IlyaBOT/MonoPod/README.md

# MonoPod
DIY iPod-inspired portable music player powered by ESP32-S3, featuring a capacitive click wheel, custom firmware, high-quality audio (16 bit/ and wireless synchronization
