IlyaBOT/MonoPod/Hardware/TDA1308_HeadphoneAmp/README.md

# MonoPod TDA1308, R2: односторонняя плата

KiCad 10.0.6, 27.10.2026. Нативные файлы `TDA1308_HeadphoneAmp.kicad_pro`, `.kicad_sch` и `.kicad_pcb` являются редактируемыми оригиналами. Библиотеки и 3D-модели находятся в `libraries/`, переносить папку проекта целиком.

## Изменения относительно R1

| Параметр | R1 | R2 |
|---|---|---|
| Размер платы | 45 x 25 мм | 50 x 35 мм |
| Физические медные стороны | 2 | 1, только нижняя B.Cu |
| Переходные отверстия | 14 | 0 |
| Проволочные перемычки для разводки | 0 | 0 |
| Ширина дорожек | 0,25 мм | 0,60 мм |
| Устанавливаемые резисторы | 18, 0805 | 14, 1206 |
| Нулевые резисторы | 4 установлены + 2 места DNP | 0 |
| Керамические конденсаторы C3-C5 | SMD | Все выводные |
| Устанавливаемые электронные детали | 26 | 22 |

Медь, TDA1308, резисторы и селекторы JP находятся снизу. Все семь конденсаторов стоят сверху, их выводы паяются к нижней меди. Отверстия компонентов не являются переходными отверстиями. В R2 всего 21 отверстие для выводов/проводов: 14 x 0,8 мм и 7 x 1,15 мм. Для физической односторонней платы металлизация отверстий не требуется.

KiCad поддерживает формально чётное число медных слоёв, поэтому в редакторе сохранён служебный двухслойный стек. Верхний F.Cu электрически и физически не используется: нет дорожек, полигонов и активных колец площадок. Для выводных площадок в локальной библиотеке включено удаление всех неподключённых колец, включая крайние слои. Нативный контрольный экспорт F.Cu пуст: `validation/empty_front_copper_proof/`. Верхний медный Gerber отсутствует в производственном архиве. Это одна физическая сторона меди, а не скрытая двухслойная разводка. См. [документацию KiCad](https://docs.kicad.org/10.0/en/pcbnew/pcbnew.html).

Предыдущая R1 сохранена в `revisions/` основной рабочей папки на I:. Для изготовления новой версии использовать только архив R2 из текущей папки.

## Электрическая схема и сокращение резисторов

Основа сохранена: [NXP TDA1308, Rev.5, Fig.4, стр.6](https://www.nxp.com/docs/en/data-sheet/TDA1308.pdf). VREF = VDD/2, два инвертирующих каскада с Rin=Rf=3,9 кОм, обязательные выходные разделительные электролиты, развязка питания и общий GND. Электрические номиналы R1-R14 и C1-C7 относительно R1 не изменены.

Удалены R15-R20: четыре устанавливаемых нулевых резистора и два резервных места. Вместо них четыре трёхконтактных паяных селектора JP1-JP4. Резисторы делителя VREF, входных делителей и обратной связи нужны для сохранения рабочей схемы. R11/R12 = 2,2 Ом оставлены для выходной развязки с неизвестным кабелем; R13/R14 = 100 кОм сохраняют определённый потенциал отключённого выхода. Их удаление изменило бы поведение и диагностику платы, поэтому дальнейшее сокращение не выполнено.

### Режим ATT/DIRECT

Все JP изготовлены РАЗОМКНУТЫМИ. Перед включением необходимо запаять выбранные пары. Это четыре припойные перемычки выбора режима, они не используются для пересечения дорожек. Отдельных проводов и нулевых резисторов для разводки нет.

| Канал | Селекторы | ATTENUATED, штатно для PCM5102A | DIRECT для слабого источника |
|---|---|---|---|
| Левый | JP1 и JP2 | На обоих соединить 1-2 | На обоих убрать 1-2 и соединить 2-3 |
| Правый | JP3 и JP4 | На обоих соединить 1-2 | На обоих убрать 1-2 и соединить 2-3 |

Вывод 1 отмечен треугольником на нижней шелкографии; сверяться с нижним assembly-видом. Нельзя соединять все три площадки и нельзя оставлять два селектора одного канала в разных режимах. Переключать только при снятом питании. В DIRECT делитель отключён от источника и от выбранного входа с обоих концов, паразитной нагрузки 3,3 кОм нет. Контроль DC-графа обоих режимов выполнен в `scripts/document.py`.

В ATT реальное ослабление с нагрузкой входа 3,9 кОм составляет около -16,4 дБ, а не -12 дБ изолированного делителя. С выходным 2,2 Ом на 32 Ом получается около -17 дБ и 0,298 В RMS при 2,1 В RMS от PCM5102A, приблизительно 2,8 мВт/канал. Это расчёт линейной схемы, не измеренная мощность. DIRECT при полной амплитуде PCM5102A вызовет клиппинг: начинать с малой цифровой громкости.

## Конденсаторы: все выводные, все сверху

| Ref | Номинал | Корпус и шаг | Полярность |
|---|---|---|---|
| C1 | 22 мкФ / >=10 В | Электролит, D<=5 мм, P=2 мм | + к VREF, - к GND |
| C2 | 100 мкФ / >=10 В | Электролит, D<=6,3 мм, P=2,5 мм | + к VDD, - к GND |
| C3 | 100 нФ / >=25 В X7R | Выводной керамический, D<=5 мм, толщина <=2,5 мм, P=2,5 мм | Неполярный |
| C4/C5 | 4,7 мкФ / >=25 В X7R | Выводной многослойный керамический, тело <=7 x 4,5 мм, P=5 мм | Неполярные |
| C6/C7 | 220 мкФ / >=10 В | Электролит, D<=8 мм, P=3,5 мм | + к усилителю через R11/R12, - к наушникам |

Керамические C4/C5 должны иметь эффективную ёмкость >=2,2 мкФ при постоянном смещении до 2,5 В. Обычные диски 100 нФ вместо них не подходят: это сильно поднимет нижнюю границу полосы. Выбирать X7R, не Y5V/Z5U. Подходящий класс деталей существует среди выводных MLCC, например семейство [KEMET Goldmax X7R](https://content.kemet.com/datasheets/KEM_C1050_GOLDMAX_X7R.pdf); перед покупкой проверить конкретный корпус, шаг и DC bias. Шаг 5,08 мм можно аккуратно привести к 5,00 мм. 3D-модель показывает габарит посадочного места, а не гарантированный цвет/форму покупного конденсатора.

Большие выходные ёмкости остаются электролитическими: замена на малые керамические диски нарушила бы НЧ-характеристику. В C6/C7 можно установить 470 мкФ / >=10 В в том же габарите или временно имеющиеся 100 мкФ / 25 В. Срез на 32 Ом без учёта 2,2 Ом: 49,7 / 22,6 / 10,6 Гц для 100 / 220 / 470 мкФ. С 2,2 Ом: 46,5 / 21,2 / 9,9 Гц. На 20 Гц у 220 мкФ остаётся заметный спад; 470 мкФ лучше сохраняет бас.

Ваши выпаянные 100 мкФ / 25 В подходят для C2 при D<=6,3 мм и для временной замены C6/C7 при D<=8 мм. Если шаг 2,5 мм, выводы можно осторожно сформовать до 3,5 мм, не изгибая их у пробки. Их высота, ESR, утечка и исправность неизвестны. Для штатного варианта дополнительно нужны 22 мкФ x1, 100 нФ выводной X7R x1, 4,7 мкФ выводной X7R x2 и 220/470 мкФ x2. C2 можно взять из имеющегося набора после проверки.

## Подключение и монтаж

Штатное питание 3,3 В; 5 В только после полного стендового испытания. Не подавать 5 В на ESP32. Плата не содержит преобразователей, стабилизаторов или защиты от переполюсовки. Общая земля объединяет PCM5102A, питание и наушники. Разъём 3,5 мм вынесен на провода.

| Площадка | Маркировка | Подключение |
|---|---|---|
| J1 | VCC | Питание 3,3 В |
| J2 | GND | Земля источника питания/PCM5102A |
| J3 | LIN | Левый сигнал PCM5102A |
| J4 | RIN | Правый сигнал PCM5102A |
| J5 | GND | Общий контакт наушников |
| J6 | LOUT | Левый наушник, после C6 |
| J7 | ROUT | Правый наушник, после C7 |

Маркировка проводов находится на нижней стороне. При перевороте платы левое/правое положение на изображении меняется: подключать по надписям, не по памяти о R1. Площадки проводов 2,15 мм, отверстия 1,15 мм подходят для AWG26-30. Механическую разгрузку проводов выполнить в корпусе; монтажных отверстий нет.

Сначала паять SMD снизу: U1, резисторы и выбранные пары JP. Затем устанавливать конденсаторы сверху и паять их ножки снизу, подрезая выводы. C3 располагать как можно ближе к плате: длинные ножки ухудшают высокочастотную развязку. Точки GND имеют сплошное соединение с заливкой, поэтому при ручной пайке понадобится хороший теплоотвод от жала и флюс; не компенсировать недостаток мощности длительным перегревом деталей.

U1 остаётся SOIC-8 3,9 x 4,9 мм с шагом 1,27 мм. На нижнем виде pin 1 находится сверху справа от корпуса; ориентироваться по точке корпуса и метке шелкографии. TSSOP-8 не подходит. Все полярные конденсаторы имеют + на квадратной площадке, к усилителю/питанию; закрашенная половина силуэта обозначает отрицательную сторону. Проверить ориентацию по assembly-изображениям.

Снизу к высоте платы добавляются SMD-компоненты: место и изоляцию от металлического корпуса нужно проверить. Высота старых электролитов и совместимость корпуса MonoPod не измерены. Рисунки 3D библиотечные; они не подтверждают реальные габариты вашего набора.

## Тестовые площадки

TP1 VDD; TP2 GND; TP3 VREF; TP4 INA; TP5 INB; TP6 OUTA_RAW; TP7 OUTB_RAW; TP8 HP_L; TP9 HP_R. Все площадки находятся снизу и не требуют отдельных компонентов. INA/INB находятся после селекторов, до входных конденсаторов. RAW имеют постоянное смещение около VREF и не предназначены для наушников.

Схема сохраняет обратную связь до разделительных конденсаторов. Не подключать большие керамические конденсаторы от RAW к GND. В даташите CL ограничена 200 пФ при паспортных условиях. 2,2 Ом не гарантируют устойчивость с любым кабелем: проверить осциллографом на 330/33 Ом и с реальным кабелем. Noise gain около 1,61 в ATT и 2 в DIRECT; электрические значения относительно R1 не изменены.

## Первый запуск: без PCM5102A и без наушников

1. При снятом питании проверить пайку, ориентацию U1 и полярности четырёх электролитов. Проверить отсутствие устойчивого короткого VDD-GND мультиметром; из-за зарядки C2 показание сопротивления может меняться. Проверить четыре селектора JP: штатно на каждом запаять 1-2; ни один селектор не должен соединять все три площадки.
2. Подать стабилизированные 3,3 В от лабораторного источника с начальным ограничением 20 мА. Не подавать аудиосигнал. После зарядки конденсаторов источник должен выйти из ограничения. Нормальный ток покоя ожидается единицы мА (NXP: 3 мА типично, 5 мА максимум при 5 В, плюс ток делителя). Устойчивый ток более 10 мА без сигнала или нагрев требуют выключения и поиска причины.
3. Измерить TP1 VDD и TP3 VREF относительно TP2 GND. VREF должен быть около VDD/2: примерно 1,65 В при 3,3 В. Для начальной диагностики ориентир 1,60-1,70 В при точных 3,3 В; это практический ориентир, не паспортный допуск всей сборки.
4. Измерить постоянное напряжение на выводах 1 и 7 / TP6 и TP7. Оба должны быть около VREF, а не около нуля. Заметная разница между каналами либо выход у шины питания требует проверки U1 и обратной связи. Не подключать наушники к TP6/TP7.
5. Проверить DC после выходных конденсаторов, TP8/TP9. Без нагрузки ждать около 120 с для 220 мкФ, 240 с для 470 мкФ, 60 с для 100 мкФ: постоянная времени с 100 кОм составляет 22/47/10 с. В начале возможен зарядный импульс. После установления ориентир <10 мВ; если напряжение сохраняется, проверить полярность/утечку конденсатора и пайку. Это критерий диагностики, не гарантия для неизвестных электролитов.
6. Подать тестовый синус 1 кГц, например 20 мВ RMS, через LIN/RIN с общей землёй. В ATT ожидается около 3 мВ RMS на наушниковом выходе при резистивной нагрузке, поэтому для оценки формы можно постепенно увеличить до 100-200 мВ RMS на входе. Наблюдать оба RAW-выхода и выходы после C6/C7 осциллографом. Земля щупа только GND. Для проверки ВЧ использовать короткую землю щупа и пробник x10.
7. Установить отдельные эквиваленты нагрузки 330 Ом между LOUT-GND и ROUT-GND; проверить форму, DC и просадку питания. Нагрузки подключать при снятом питании, затем повторять измерения после включения.
8. Заменить эквиваленты на 33 Ом, >=0,25 Вт каждый. Для испытаний с сигналом можно увеличить токовый лимит до 50-100 мА, наблюдая потребление. Начинать с малой амплитуды. Не искать предел громкости в наушниках.
9. Проверить отсутствие клиппинга, ВЧ-самовозбуждения, перегрева и заметного падения VDD; повторить с реальным кабелем и с обоими каналами. Логический анализатор не заменяет осциллограф для DC, аналоговой формы и искажений; учитывать допустимые напряжения его входов.
10. Только после успешных проверок подключить наушники при минимальной громкости и установившемся питании. Затем подключить PCM5102A, начиная с минимального цифрового уровня. При выключениях/включениях учитывать зарядные импульсы. Испытание на 5 В проводить сначала без наушников и повторять весь цикл.

Выпаянная U1 может быть повреждена, перемаркирована или перегрета. Правильная схема и чистый DRC не исключают сохранение прежних симптомов перегруза из-за самой микросхемы. Измеренное улучшение на активных колонках не доказывает её работоспособность на 32 Ом.

## Проверки и файлы изготовления

Нативные ERC и DRC выполнены со всеми уровнями замечаний, с проверкой соответствия PCB схеме: 0 нарушений, 0 неразведённых соединений и 0 расхождений со схемой. Исключения DRC не добавлялись. Карта всех выводов и нетлист сверены, полярности и конфигурации селекторов проверены. В частности, на F.Cu нет активных площадок, дорожек или заливки; контрольный Gerber F.Cu содержит ноль апертур/рисующих команд. Все 78 центров площадок проверены на открытие в фактическом Gerber нижней маски; результат PASS в `soldermask_pad_openings.json`. Все дорожки B.Cu имеют ширину 0,6 мм, правило зазора 0,25 мм; минимальная толщина перемычек заливки земли 0,4 мм.

`manufacturing.zip` содержит только одну медь B.Cu, нижнюю маску, шелкографию двух сторон, контур, единый Excellon с 21 отверстием и `FABRICATION.txt`. Для физического заказа: ОДНА сторона меди снизу, FR4 1,6 мм, медь 35 мкм, все отверстия БЕЗ металлизации. Финиш HASL или иной стандартный паяемый. Не создавать верхнюю медь, не зеркалить и не масштабировать Gerber. Если сервис предлагает только двухслойный заказ, выбрать изготовителя с поддержкой односторонних плат или явно согласовать пустую верхнюю сторону; заказ автоматически не выполнялся.

Использован обычный Gerber RS-274X без X2-атрибутов. Комментарии X2 со служебной двухслойной нумерацией удалены; все графические команды побайтно по строкам сохранены, контроль в `gerber_metadata_normalization.json`. Внутренний двухслойный Gerber job KiCad намеренно не включён. Excellon имеет минимальный заголовок без атрибута металлизации; физическое отсутствие металлизации явно задано в FABRICATION.txt. Нативный отчёт KiCad называет выводные отверстия PTH по электрическому типу площадок — это служебная классификация CAD, а не указание металлизировать эту одностороннюю плату.

`BOM.csv` содержит 14 резисторов, 7 конденсаторов и одну U1 — всего 22 устанавливаемые детали. JP/J/TP указаны отдельно как площадки без покупных компонентов. Координаты и фактические повороты: `assembly_coordinates.csv`. В `renders/` находятся виды сверху/снизу, assembly и медь. `docs/schematic.pdf` — обзор, `.kicad_sch` — редактируемая схема. `validation/` содержит результаты, расчёты, карту цепей, доказательство пустого F.Cu и SHA-256.

Изготовленный физический образец не испытан. Чистые ERC/DRC не подтверждают исправность выпаянной TDA1308, утечку старых электролитов, реальные THD/шум или устойчивость с кабелем. Перенос библиотеки и native-паритет проверяются отдельно. Для редактирования открыть основной `.kicad_pro`. Скрипты `design.py`/`build_pcb.py` перезаписывают CAD; обычные правки вносить в KiCad. Повторные проверки: bundled Python KiCad + `scripts/validate.py`, экспорт — `scripts/export.py`.
