IlyaBOT/MonoPod/Hardware/MonoPod_Enclosure_v04_USB_Flush_Acrylic_2026-11-02/stl/README_RU.md

# MonoPod v0.7 — рамка дисплея с нахлёстом под клей

Стойки передней панели и рамки укорочены по высоте на 1 мм относительно пробника 52×30,4. Они входят друг в друга, поэтому плата TFT в сборе приблизилась к лицу на 1 мм. Шаг креплений 52×30,4 мм. Винты TFT — четыре М2.5×6. Расчётное зацепление резьбы 2,6 мм, запас под концом винта 0,25 мм.

На рамке сплошной бортик толщиной 1 мм. Он заходит под панель на 2 мм по контуру, включая участки вокруг креплений. В панели есть ответная ступенька с зазором 0,15 мм под тонкий слой клея. Клей наносится на обращённую к панели плоскую сторону этого бортика.

Акрил 45×38×1 мм с тем же контуром. Его посадка сдвинута вверх на 1,2 мм, чтобы оставить место под бортик рядом с каркасом колеса. Световой проём 38×31 мм расположен на 3 мм левее центра креплений. Справа рамка прикрывает зону шлейфа. Номинальный зазор между рамкой и корпусом TFT составляет 0,3 мм.

## Печать и примерка

1. Напечатайте `Probnik.stl` и `Ramka.stl` в масштабе 100%, в миллиметрах. Оба STL уже ориентированы плоской стороной на стол. Печатайте рамку из непрозрачного пластика.
2. Вставьте рамку с тыльной стороны пробника, приложите TFT и проверьте попадание всех четырёх винтов. Проверьте, что плата лежит на опорах без перекоса, стекло свободно, бортик перекрывает стык, а на включённом экране видны края изображения.
3. После сухой примерки печатайте `Front_Panel.stl` и приклейте рамку к панели по бортику. Клеевой шов проходит вдоль края, с отступом от винтовых отверстий. Монтаж TFT и установка панели выполняются после отверждения клея.

## Исходники

В полном архиве есть STL, STEP, сборка экрана и параметры CadQuery. Из корня архива с Python 3.13:

```powershell
python -m pip install -r source/requirements.txt
python source/build_enclosure.py --output build
```

В CAD проверены центры винтов, опорные площадки, непрерывность клеевой полосы, установка рамки сзади и зазоры до TFT и Click Wheel. Посадку напечатанных деталей проверяют пробником.
