IlyaBOT/MonoPod/Hardware/MonoPod_Enclosure_v04_USB_Flush_Acrylic_2026-11-02/reference/clickwheel/README_RU.md

# MonoPod Click Wheel v0.3 — механика под актуальную PCB

Комплект адаптирован к круглой плате MonoPod Ø44 мм из проекта KiCad: четыре боковые кнопки находятся на радиусе 16,5 мм, Select — в центре, крепёжные отверстия платы — в точках (±13; ±13). Идентичность ваших TS-1187A кнопкам проекта принята по вашему подтверждению. Исходная плата и прошивка не изменены.

Накладка закреплена в четырёх диагональных точках. При нажатии прогибается её тонкое лицо между закреплениями. У каждой стороны есть отдельный толкатель с двумя ограничительными ножками на общей перемычке. Select — отдельная деталь, удерживаемая скрытым буртиком за основное колесо; скрытый ключ задаёт её ориентацию. В собранном узле четыре неподвижные полки каркаса задают верхнее положение Select, а небольшой расчётный преднатяг её кнопки удерживает Select у этих полок.

Это механический прототип для первой печати. Геометрия и экспорт проверены в CAD; усилие нажатия, возврат пластика, ресурс и работа ёмкостного сенсора требуют проверки собранного узла.

## Файлы

| Файл | Назначение |
|---|---|
| `stl/wheel.stl` | Основное колесо с символами глубиной 0,1 мм, четырьмя толкателями и крепёжными бобышками |
| `stl/wheel_plain.stl` | Альтернатива без символов; печатать вместо `wheel.stl` |
| `stl/select.stl` | Отдельная Select с буртиком, ключом, центральным толкателем и тремя ограничителями |
| `stl/frame.stl` | Неподвижный каркас с четырьмя отверстиями крепления к корпусу |
| `stl/fit_coupon.stl` | Пробник посадки Select и пилотных отверстий M2 |
| `cad/assembly.step` | Сборка с платой, габаритными моделями компонентов, фольгой и условными габаритами винтов |
| `cad/wheel.step`, `cad/wheel_plain.step`, `cad/select.step`, `cad/frame.step` | Отдельные редактируемые твёрдые тела в сборочных координатах |
| `source/build_mechanism.py`, `source/parameters.json` | Параметрический исходник CadQuery 2.7 и снимок размеров |
| `source/pcb_geometry.json`, `source/pcb_native.step` | Геометрическая привязка к текущей плате |
| `reference/pcb_with_component_envelopes.step` | Плата с моделями габаритов компонентов для механической проверки |
| `reference/electrodes_1to1.svg` | Шесть медных электродов 1:1 при взгляде спереди; для проверки углового порядка |
| `reference/electrodes_BACK_1to1.svg` | Шаблон 1:1 при взгляде на изнанку; для размещения фольги на накладке |
| `Assembly_and_Print_Guide_RU.pdf` | Четыре страницы: сборка, печать, размерный шаблон и два вида электродов |
| `validation/geometry_check.json` | Численные результаты проверок |

STL уже ориентированы для печати. STEP использует сборочные координаты: лицевая плоскость `Z=0`, задняя сторона имеет отрицательный Z. При взгляде спереди X направлен вправо, Y — вверх, к MENU. Все размеры — в миллиметрах.

STL получены жёстким поворотом или переносом соответствующей CAD-детали, без зеркального отражения. Дополнительно зеркалить их в слайсере не нужно: после печати и переворота надпись MENU будет читаться правильно.

## Основные размеры

| Параметр | Размер |
|---|---:|
| Видимый диаметр колеса | 44,0 |
| Диаметр видимой Select | 15,0 |
| Отверстие колеса под Select | 15,3 |
| Радиальный зазор Select с каждой стороны | 0,15 |
| Толщина лица колеса | 0,7 |
| Глубина символов / остаток пластика под ними | 0,1 / 0,6 |
| Толщина основного диска Select | 2,0 |
| Скрытый буртик Select | Ø19,4 × 0,8, с вырезом со стороны PLAY |
| Длина центральной направляющей от лица | 1,65 |
| Осевой зазор до буртика Select без каркаса | 0,35 |
| Свободный осевой ход Select вверх в собранном каркасе | 0 |
| Диаметр контактных концов всех пяти толкателей | 2,4 |
| Глубина боковых контактных концов от лица | 3,4 |
| Глубина контактного конца Select от лица | 3,47 |
| Номинальный зазор до ненажатых боковых кнопок | 0,05 |
| Расчётный преднатяг кнопки Select | 0,02 |
| Зазор боковых ограничительных ножек до платы | 0,30 |
| Ход Select вниз до её ограничителей | 0,23 |
| Передняя поверхность платы от лица | 4,25 |
| Принятая итоговая толщина платы | 1,6 |
| От лица до обратной поверхности платы | 5,85 |
| От лица до конца условного габарита головок M2 | 7,85 |
| Габарит каркаса в плане | 50 × 50 |
| Осевой размер самого каркаса | 3,55 |
| Отверстия каркаса под M2.5 | Ø2,8, квадрат 42 × 42 |

Размер 7,85 мм включает условные головки M2 Ø5 × 2 мм. Реальные головки ваших винтов нужно проверить. Опциональный разъём на обратной стороне платы, его выводы и кабели в эту толщину не входят.

## Координаты привязки

Начало координат находится в центре Select. Таблица дана при взгляде на лицевую сторону; MENU сверху.

| Элемент | X | Y |
|---|---:|---:|
| MENU / SW1 | 0 | +16,5 |
| PREV / SW2 | −16,5 | 0 |
| NEXT / SW3 | +16,5 | 0 |
| PLAY / SW4 | 0 | −16,5 |
| Select / SW5 | 0 | 0 |
| H1 | −13 | +13 |
| H2 | +13 | +13 |
| H3 | −13 | −13 |
| H4 | +13 | −13 |
| Четыре крепления к корпусу | ±21 | ±21 |

## Крепёж

Для текущего узла нужны **четыре M2×5**. Они устанавливаются с обратной стороны платы и последовательно проходят через плату и каркас, затем входят в глухие пилотные отверстия накладки. Номинальный диаметр пилота — 1,7 мм; расчётная длина зацепления винта в накладке — 2,2 мм. От дна пилота до лицевой поверхности остаётся 0,65 мм материала, а между концом винта и дном пилота — 0,20 мм. Резьбу в пластике формируют аккуратно на пробнике, затем в детали; модель не содержит нарезанную винтовую резьбу.

Для крепления собранного узла к будущей передней панели предусмотрены **четыре M2.5×4**. Винты идут сзади через уши каркаса толщиной 2,4 мм в ответные резьбовые бобышки корпуса. За переднюю опорную поверхность уха выступает 1,6 мм стержня. Ответные бобышки и резьба M2.5 относятся к будущему корпусу и в этот комплект не входят. При проектировании панели нужно сохранить место для зацепления винта и дна глухого отверстия.

Опорная плоскость ушей находится на глубине 1,85 мм от лица колеса, передний торец кольцевой части каркаса — на глубине 0,70 мм. Поэтому в будущей панели нужна выборка под кольцо на 1,15 мм относительно плоскости опоры ушей. Четыре точки крепления и эта ступень задают интерфейс корпуса; плоская панель без выборки не сядет на все опоры.

M2.5×8 оставлены для будущего соединения половинок корпуса; в текущем узле они не используются. M2×6 вместо M2×5 ставить нельзя без пересчёта глубины: они могут повредить тонкое лицо накладки.

## Пробная печать и посадка

Используйте FDM с соплом 0,4 мм, масштаб 100%, единицы мм. Для первой проверки подходит слой 0,1 мм: лицо колеса имеет семь слоёв, под символами остаётся шесть. Материал и режимы конкретного принтера влияют на зазоры и упругость; одинаковый профиль нужен для пробника и рабочих деталей.

Сначала напечатайте `fit_coupon.stl` и Select. Круглые отверстия пробника с одной, двумя и тремя точками имеют соответственно Ø15,2 / Ø15,3 / Ø15,4 мм: это зазоры 0,10 / 0,15 / 0,20 мм на сторону для Select Ø15. У каждого отверстия есть совместимый паз под скрытый ключ Select. Совместите ключ с пазом и проверьте свободное скольжение без заедания. Среднее отверстие соответствует рабочей модели. В нижнем ряду находятся глухие пилоты M2 Ø1,6 / Ø1,7 / Ø1,8 мм с тем же порядком точек; выберите посадку, в которой винт формирует резьбу без растрескивания и держится без свободного проворота.

Если нужен другой размер, измените соответствующий параметр в `source/parameters.json` и заново выполните генератор. Изменение JSON само по себе не обновляет STL и STEP. Для генерации нужны Python, CadQuery 2.7, NumPy, Trimesh и Matplotlib. Соседние `pcb_geometry.json` и `pcb_native.step` должны оставаться рядом с исходником.

Воспроизводимая генерация в Windows из папки комплекта (проверено на Python 3.12):

```powershell
py -3.12 -m venv .venv
.\.venv\Scripts\python.exe -m pip install -r source\requirements.txt
.\.venv\Scripts\python.exe source\build_mechanism.py
.\.venv\Scripts\python.exe source\make_images.py
.\.venv\Scripts\python.exe source\make_guide.py
```

Генератор перезаписывает экспорты в этой папке. Перед редактированием сохраните копию комплекта. Размеры конкретной платы находятся в `pcb_geometry.json`; при перемещении кнопок или отверстий одной правки параметров недостаточно — требуется обновить привязку и проверить всю сборку.

Колесо и Select в STL лежат лицом на столе, толкателями вверх. Каркас лежит задней плоскостью на столе. Колесу и пробнику отдельные поддержки геометрически не требуются. **Под скрытым выступающим буртиком Select и под четырьмя внутренними полками каркаса нужны локальные поддержки.** Полки расположены на углах 45°, 135°, 225° и 315°, в зоне радиусов примерно 9,2–15,2 мм. Не допускайте прирастания поддержек к направляющему ключу, контактным концам, опорным поверхностям полок и буртика. После снятия поддержек очистите посадки и проверьте скольжение. До полной печати осмотрите тонкое лицо, мелкие символы, ножки, полки и глухие пилоты в предпросмотре слайсера.

Преднатяг Select 0,02 мм — расчётная настройка, а не достижимая гарантия FDM-печати слоем 0,1 мм. После печати нужно проверить, что полки задают положение Select без люфта и без постоянного срабатывания кнопки. По измерениям можно скорректировать `select_preload` и высоту контактного конца, сохраняя запас до ограничителей.

## Фольга и провода

Оба шаблона электродов соответствуют новой геометрии: в них освобождены места под бобышки и перемычки толкателей. Это шесть отдельных электродов с промежутками 1,2 мм, внутренним радиусом 9,35 мм и наружным 20,8 мм. Старый шаблон из ZIP v0.2 для этой накладки не использовать.

Для размещения меди на изнанке используйте `reference/electrodes_BACK_1to1.svg`, держа MENU сверху. Файл `reference/electrodes_1to1.svg` показывает расположение спереди: E1 находится на 12 часах, E2–E6 идут по часовой стрелке, как в прежней привязке PCB. Вид с изнанки уже отражён по X, поэтому дополнительно зеркалить BACK-шаблон не нужно. Печатайте 100% без подгонки страницы и проверьте контрольный отрезок 20 мм. Сохраняйте обозначения E1–E6 при подключении проводов; надписи и контрольный отрезок не являются вырезами в меди.

Медь приклеивается к изнанке тонкого лица. Не соединяйте соседние секторы клеевой медной лентой или припоем. Для соединений с E1–E6 платы используйте тонкие гибкие изолированные провода со свободным изгибом: провод не должен натягивать прогибающуюся накладку или попадать под ограничители. Под площадками пайки в проверочной модели принят габарит до 1 мм над платой; реальные наплывы припоя и петли проводов в CAD не воспроизведены. У каркаса со стороны PLAY есть выход для проводки, задняя часть открыта для доступа к J1.

## Сборка

1. Очистите детали после печати, включая скрытые полки каркаса. Проверьте пробником посадку Select и пилот M2. Убедитесь, что винт M2×5 не прошивает лицо накладки.
2. Закрепите шесть электродов на изнанке накладки. Подготовьте гибкие соединения; уложите их вне бобышек, толкателей, полок и ограничительных ножек.
3. Совместите четыре бобышки накладки с четырьмя внутренними опорами каркаса **без установленной Select**. Затем вставьте Select с открытой задней стороны каркаса в отверстие колеса до упора буртика в четыре полки. Скрытый ключ должен смотреть к MENU и попасть в паз направляющей; вырез в буртике Select направлен к PLAY, к зоне E1/E3/E5 на плате. Такой порядок не требует проводить буртик сквозь неподвижные полки.
4. Установите PCB кнопками к накладке, удерживая детали до вворачивания винтов. Все четыре отверстия платы должны совпасть без бокового усилия; Select должен оказаться над центральной SW5.
5. Вставьте четыре M2×5 с обратной стороны PCB. Затягивайте постепенно крест-накрест до посадки плоских опор. Не выгибайте плату и не перетягивайте пластиковые пилоты. Убедитесь, что провода не зажаты между опорами.
6. Поочерёдно проверьте MENU, PREV, NEXT, PLAY и Select. Каждая кнопка должна срабатывать и отпускаться без заедания; при нажатии направления Select не должен срабатывать сам. Проверьте также работу touch через накладку с установленной фольгой.
7. После успешной примерки закрепите каркас на ответных бобышках передней панели четырьмя M2.5×4. Не используйте затяжку этих винтов для исправления перекоса или принудительного совмещения отверстий.

Если боковая кнопка поджата в покое, Select постоянно срабатывает или кнопка не срабатывает до упора ограничителей, сначала измерьте фактическую толщину PCB и высоту собранной кнопки. Для Select предусмотрен только небольшой механический преднатяг 0,02 мм, недостаточный для срабатывания. Корректировать нужно осевую посадку или высоту толкателя в модели; уменьшение высоты ограничительных ножек без измерений убирает предусмотренное ограничение хода.

## Что проверено и что остаётся проверить

Для текущей модели подтверждены корректные одиночные твёрдые тела, замкнутые STL с согласованными нормалями, повторное чтение STEP без изменения объёма и совпадение центров всех пяти толкателей с актуальной PCB. В расчётных положениях детали не пересекаются с платой, моделями компонентов и принятыми габаритами пайки. Удержание Select проверено на прямое вытягивание, его движение — до 0,23 мм вниз и на боковое смещение 0,15 мм. При ходе 0,23 мм суммарное расчётное сжатие центральной кнопки составляет 0,25 мм с учётом преднатяга. В собранном каркасе полки блокируют свободный подъём Select; отдельно от каркаса её удерживает колесо с осевым запасом 0,35 мм. Электродов получилось ровно шесть.

Проверка каждой боковой перемычки на перемещение 0,30 мм предполагает, что сама перемычка с толкателем и ограничителями движется как жёсткий элемент. Это проверка зазоров и ограничителей, **не расчёт упругого изгиба всего колеса**. Упругость FDM-пластика, усилие и возврат после нажатия, влияние затяжки, ресурс, точность печати, реальные головки винтов и ёмкостная чувствительность пока не проверены физически. Номинальные 0,20 мм хода кнопки и проверочные 0,25 мм не заменяют измерение изготовленного узла.

Привязка выполнена к PCB с SHA-256 `a7bdeb4b372455b6ef700c6a342041ecb3fbb6f173e195c51b35aa866ef53abd`. При последующем перемещении кнопок или отверстий в KiCad механическую модель нужно обновить.
