IlyaBOT/MonoPod/Hardware/TDA1308_HeadphoneAmp/validation/drill_report_from_KiCad.txt

Drill report for TDA1308_HeadphoneAmp.kicad_pcb
Created on 2026-10-27T15:29:45

Copper Layer Stackup:
    =============================================================
    L1 :  F.Cu                      front
    L2 :  B.Cu                      back

Drill file 'TDA1308_HeadphoneAmp.drl' contains
    plated through holes:
    =============================================================
    T1  0.800mm  0.0315"  (14 holes))
    T2  1.150mm  0.0453"  (7 holes))

    Total plated holes count 21

Not plated through holes are merged with plated holes
    unplated through holes:
    =============================================================

    Total unplated holes count 0
