IlyaBOT/MonoPod/Hardware/TDA1308_HeadphoneAmp/revisions/R1_snapshot/validation/drill_report.txt

Drill report for TDA1308_HeadphoneAmp.kicad_pcb
Created on 2026-10-27T14:29:48

Copper Layer Stackup:
    =============================================================
    L1 :  F.Cu                      front
    L2 :  B.Cu                      back

Drill file 'TDA1308_HeadphoneAmp-PTH.drl' contains
    plated through holes:
    =============================================================
    T1  0.300mm  0.0118"  (14 holes))
    T2  0.800mm  0.0315"  (8 holes))
    T3  1.150mm  0.0453"  (7 holes))

    Total plated holes count 29

Drill file 'TDA1308_HeadphoneAmp-NPTH.drl' contains
    unplated through holes:
    =============================================================

    Total unplated holes count 0
