IlyaBOT/MonoPod/firmware/README_POWER_GUARD_HOLD_v0.10.7.2_RU.md

# MonoPod v0.10.7.2 — прототип Deep Sleep и пробуждение через HOLD

## Как работает

На ESP32-S3 N16R8 мониторится GPIO9 **только при отпущенных кнопках**: внешний резистор 20 кОм подключает его к шине 3V3. На момент старта аналоговый вход GPIO9 используется без полной инициализации прошивки, чтобы проверить питание до SD, Wi-Fi, TFT framebuffer, touch и I2S.

- При стартовом результате 2450–3119 мВ устройство показывает `LOW BATTERY / Connect charger` на TFT 3 секунды, затем уходит в Deep Sleep. Показание — **приближение**, не калиброванный вольтметр: ADC ESP32-S3 нелинеен и насыщается в верхней части диапазона.
- В ходе работы устойчивые показания <=3050 мВ при отпущенных кнопках более 750 мс также запускают предупреждение и Deep Sleep. При активной передаче USB/Wi-Fi устройство не прерывает запись этим механизмом. Запуск Wi-Fi OTA дополнительно отклоняется, если GPIO9 не подтверждает достаточное напряжение, либо в этот момент нажата кнопка. Это лишь предварительная проверка, а не гарантия безопасности уже начатой прошивки.
- В Deep Sleep плата ждёт HOLD=LOCK (GPIO21 LOW). После переключения в LOCK она сразу снова уходит в сон и ждёт HOLD=UNLOCK (GPIO21 HIGH). После возврата к UNLOCK проверяет питание заново. Если оно всё ещё низкое, TFT показывает сообщение на 3 секунды, и цикл повторяется. При достаточном питании продолжается полный запуск прошивки.
- Если при уходе в Deep Sleep HOLD уже установлен в LOCK, плата ждёт только возврата в UNLOCK.
- Это **не аппаратный power-off**: все части платы, постоянно питаемые от батареи, продолжают потреблять ток. Ток Deep Sleep платы DevKit может быть значительно выше тока самого чипа из-за USB-преобразователей, стабилизаторов, TFT и TP4056.

## Подключение

- HOLD — GPIO21, **внешняя** подтяжка 10 кОм к 3V3, положение LOCK замыкает GPIO21 на GND.
- Резистивная клавиатура — GPIO9, 20 кОм к 3V3. При нажатой кнопке через GPIO9 измерять 3V3 нельзя; код намеренно игнорирует такие показания.
- Аккумуляторный ADC GPIO4 остаётся для приблизительной оценки Vbat. Он не сообщает напряжение шины 3V3.
- TFT использует GPIO10 CS, GPIO39 DC, GPIO47 RST, GPIO15 BL, SPI GPIO11/12/13, без SD.begin() для аварийного экрана.

## Критические ограничения

1. **ESP32-S3 нельзя гарантированно эксплуатировать при 2.7–2.8 В.** Устройство рассчитано на 3.0–3.6 В. Если в точке 3V3 уже 2.57 В, *никакая прошивка не сможет гарантировать вывод предупреждения, работу Flash или Deep Sleep*. Исправьте стабилизатор/цепь питания: подойдут правильно рассчитанный buck-boost 3.3 В и Li-ion protection/UVLO.
2. Калиброванного независимого входа 3V3 в текущей разводке нет. GPIO9 — **только приближение**. Ни сохранение постоянного значения, ни отсечка по нему не заменяют физический undervoltage-lockout.
3. Разбудить плату по любому Select пока невозможно: Select находится на той же аналоговой лестнице GPIO9, что и другие кнопки; HOLD GPIO21 подходит для wake EXT0, поскольку это RTC GPIO. При быстрых переключениях или сильной просадке возможен повторный сброс; переключайте LOCK, дайте контроллеру распознать его, затем UNLOCK.
4. До безопасной записи в Flash/на microSD и OTA нужно устранить падение стабилизатора. Скрипт не умеет предотвратить повреждение данных, если питание исчезнет во время уже идущей записи.

## Настройка

В `DIY_iPod_Mono/PowerGuard.cpp`:
- `kShutdownMv = 3050` — порог ухода в сон при работающей прошивке.
- `kBootResumeMv = 3120` — порог разрешения полноценного старта.
- `kReleasedMinMv = 2450` — фильтр нажатых кнопок, не минимально допустимое питание.
- `kSustainedLowMs = 750` — время устойчивой просадки.

**Проверять на стенде с регулируемым источником**, отключив аккумулятор, с ограничением тока, постепенно изменяя напряжение. Не проверяйте работу Li-ion ниже безопасного напряжения разряда. Сначала проверьте роль GPIO21 и правильность логических уровней HOLD.

## Известные ограничения / статус

Архив является прототипом. Нативные/static тесты не заменяют компиляцию в Arduino IDE и проверку Deep Sleep / TFT на физической ESP32-S3. Режим классической ESP32 оставлен без изменений.
