IlyaBOT/MonoPod/Hardware/MonoPod_Enclosure_v04_USB_Flush_Acrylic_2026-11-02/PARAMETERS_RU.md

# Параметры MonoPod Enclosure v0.4

Все редактируемые значения находятся в `source/parameters.json`. Координаты: X вправо, Y вверх, глубина D=-Z. Зазоры в серии - **на сторону**, если не указано иное. Размеры display задаются до поворота; `rotation_degrees=90` поворачивает окно, плату, стекло и сетку креплений вместе.

Изменение JSON требует повторного запуска генератора. Параметры исходного колеса сохранены отдельно в `reference/clickwheel/source/parameters.json`; не меняйте их для подгонки корпуса.

| Параметр | Значение | Ед. | Статус | Источник / проверка |
|---|---|---|---|---|
| version | 0.4 | - | Служебный | Формат проекта |
| units | mm | - | Служебный | Формат проекта |
| case.width | 94.0 | мм | ПРОЕКТНОЕ | Начальные габариты и конструкция; подогнать после обмера начинки и пробников |
| case.height | 148.0 | мм | ПРОЕКТНОЕ | Начальные габариты и конструкция; подогнать после обмера начинки и пробников |
| case.depth | 26.0 | мм | ПРОЕКТНОЕ | Начальные габариты и конструкция; подогнать после обмера начинки и пробников |
| case.corner_radius | 8.0 | мм | ПРОЕКТНОЕ | Начальные габариты и конструкция; подогнать после обмера начинки и пробников |
| case.edge_radius | 0.6 | мм | ПРОЕКТНОЕ | Начальные габариты и конструкция; подогнать после обмера начинки и пробников |
| case.front_thickness | 2.4 | мм | ПРОЕКТНОЕ | Начальные габариты и конструкция; подогнать после обмера начинки и пробников |
| case.wall | 2.0 | мм | ПРОЕКТНОЕ | Начальные габариты и конструкция; подогнать после обмера начинки и пробников |
| case.rear_thickness | 2.0 | мм | ПРОЕКТНОЕ | Начальные габариты и конструкция; подогнать после обмера начинки и пробников |
| case.lip_wall | 1.2 | мм | ПРОЕКТНОЕ | Начальные габариты и конструкция; подогнать после обмера начинки и пробников |
| case.lip_height | 2.0 | мм | ПРОЕКТНОЕ | Начальные габариты и конструкция; подогнать после обмера начинки и пробников |
| case.seam_clearance | 0.25 | мм | ПРОЕКТНОЕ | Начальные габариты и конструкция; подогнать после обмера начинки и пробников |
| case.closure_xy | [[-40.0, -65.0], [40.0, -65.0], [-40.0, 65.0], [40.0, 65.0]] | мм | ПРОЕКТНОЕ | Начальные габариты и конструкция; подогнать после обмера начинки и пробников |
| case.closure_boss_diameter | 7.2 | мм | ПРОЕКТНОЕ | Начальные габариты и конструкция; подогнать после обмера начинки и пробников |
| case.closure_root_diameter | 8.4 | мм | ПРОЕКТНОЕ | Начальные габариты и конструкция; подогнать после обмера начинки и пробников |
| case.closure_root_height | 3.0 | мм | ПРОЕКТНОЕ | Начальные габариты и конструкция; подогнать после обмера начинки и пробников |
| case.closure_end_gap | 0.0 | мм | ПРОЕКТНОЕ | Начальные габариты и конструкция; подогнать после обмера начинки и пробников |
| case.closure_pilot_depth | 6.3 | мм | ПРОЕКТНОЕ | Начальные габариты и конструкция; подогнать после обмера начинки и пробников |
| wheel.x | 0.0 | мм | ПРОЕКТНОЕ ПОД ИНТЕРФЕЙС | Сопряжение с неизменённым Click Wheel v0.3; исходные 42x42/2.8/1.15 фиксируются отдельными reference/STEP/JSON |
| wheel.y | -31.0 | мм | ПРОЕКТНОЕ ПОД ИНТЕРФЕЙС | Сопряжение с неизменённым Click Wheel v0.3; исходные 42x42/2.8/1.15 фиксируются отдельными reference/STEP/JSON |
| wheel.face_recess | 0.6 | мм | ПРОЕКТНОЕ ПОД ИНТЕРФЕЙС | Сопряжение с неизменённым Click Wheel v0.3; исходные 42x42/2.8/1.15 фиксируются отдельными reference/STEP/JSON |
| wheel.radial_gap | 0.25 | мм | ПРОЕКТНОЕ ПОД ИНТЕРФЕЙС | Сопряжение с неизменённым Click Wheel v0.3; исходные 42x42/2.8/1.15 фиксируются отдельными reference/STEP/JSON |
| wheel.ring_radial_clearance | 0.25 | мм | ПРОЕКТНОЕ ПОД ИНТЕРФЕЙС | Сопряжение с неизменённым Click Wheel v0.3; исходные 42x42/2.8/1.15 фиксируются отдельными reference/STEP/JSON |
| wheel.ring_axial_clearance | 0.1 | мм | ПРОЕКТНОЕ ПОД ИНТЕРФЕЙС | Сопряжение с неизменённым Click Wheel v0.3; исходные 42x42/2.8/1.15 фиксируются отдельными reference/STEP/JSON |
| wheel.lug_radial_clearance | 0.25 | мм | ПРОЕКТНОЕ ПОД ИНТЕРФЕЙС | Сопряжение с неизменённым Click Wheel v0.3; исходные 42x42/2.8/1.15 фиксируются отдельными reference/STEP/JSON |
| wheel.boss_diameter | 7.2 | мм | ПРОЕКТНОЕ ПОД ИНТЕРФЕЙС | Сопряжение с неизменённым Click Wheel v0.3; исходные 42x42/2.8/1.15 фиксируются отдельными reference/STEP/JSON |
| wheel.pilot_depth | 1.85 | мм | ПРОЕКТНОЕ ПОД ИНТЕРФЕЙС | Сопряжение с неизменённым Click Wheel v0.3; исходные 42x42/2.8/1.15 фиксируются отдельными reference/STEP/JSON |
| wheel.lug_radius | 4.0 | мм | ПО ИСХОДНОЙ CAD | Наружный радиус уха из генератора v0.3 |
| display.x | 0.0 | мм | НЕ ПОДТВЕРЖДЕНО | Габаритный профиль типового TFT; проверить display_window_coupon и изменить по своей плате |
| display.y | 35.0 | мм | НЕ ПОДТВЕРЖДЕНО | Габаритный профиль типового TFT; проверить display_window_coupon и изменить по своей плате |
| display.rotation_degrees | 90.0 | град | ПРОЕКТНОЕ | 90 градусов: альбомный экран под интерфейс 160x128; реальные отверстия и стекло не обмерены |
| display.pcb_width | 35.0 | мм | НЕ ПОДТВЕРЖДЕНО | Габаритный профиль типового TFT; проверить display_window_coupon и изменить по своей плате |
| display.pcb_height | 56.0 | мм | НЕ ПОДТВЕРЖДЕНО | Габаритный профиль типового TFT; проверить display_window_coupon и изменить по своей плате |
| display.pcb_thickness | 1.6 | мм | НЕ ПОДТВЕРЖДЕНО | Габаритный профиль типового TFT; проверить display_window_coupon и изменить по своей плате |
| display.pcb_front_depth | 6.0 | мм | НЕ ПОДТВЕРЖДЕНО | Габаритный профиль типового TFT; проверить display_window_coupon и изменить по своей плате |
| display.hole_pitch_x | 30.0 | мм | НЕ ПОДТВЕРЖДЕНО | Габаритный профиль типового TFT; проверить display_window_coupon и изменить по своей плате |
| display.hole_pitch_y | 50.0 | мм | НЕ ПОДТВЕРЖДЕНО | Габаритный профиль типового TFT; проверить display_window_coupon и изменить по своей плате |
| display.hole_diameter | 2.8 | мм | НЕ ПОДТВЕРЖДЕНО | Габаритный профиль типового TFT; проверить display_window_coupon и изменить по своей плате |
| display.glass_width | 34.0 | мм | НЕ ПОДТВЕРЖДЕНО | Габаритный профиль типового TFT; проверить display_window_coupon и изменить по своей плате |
| display.glass_height | 43.0 | мм | НЕ ПОДТВЕРЖДЕНО | Габаритный профиль типового TFT; проверить display_window_coupon и изменить по своей плате |
| display.glass_above_pcb | 3.4 | мм | НЕ ПОДТВЕРЖДЕНО | Габаритный профиль типового TFT; проверить display_window_coupon и изменить по своей плате |
| display.glass_y_offset | 0.0 | мм | НЕ ПОДТВЕРЖДЕНО | Габаритный профиль типового TFT; проверить display_window_coupon и изменить по своей плате |
| display.active_width | 28.0 | мм | НЕ ПОДТВЕРЖДЕНО | Габаритный профиль типового TFT; проверить display_window_coupon и изменить по своей плате |
| display.active_height | 35.0 | мм | НЕ ПОДТВЕРЖДЕНО | Габаритный профиль типового TFT; проверить display_window_coupon и изменить по своей плате |
| display.window_width | 29.0 | мм | НЕ ПОДТВЕРЖДЕНО | Габаритный профиль типового TFT; проверить display_window_coupon и изменить по своей плате |
| display.window_height | 36.0 | мм | НЕ ПОДТВЕРЖДЕНО | Габаритный профиль типового TFT; проверить display_window_coupon и изменить по своей плате |
| display.window_radius | 0.8 | мм | НЕ ПОДТВЕРЖДЕНО | Габаритный профиль типового TFT; проверить display_window_coupon и изменить по своей плате |
| display.rear_component_height | 3.0 | мм | НЕ ПОДТВЕРЖДЕНО | Габаритный профиль типового TFT; проверить display_window_coupon и изменить по своей плате |
| display.boss_diameter | 6.4 | мм | НЕ ПОДТВЕРЖДЕНО | Габаритный профиль типового TFT; проверить display_window_coupon и изменить по своей плате |
| display.pilot_depth | 2.65 | мм | НЕ ПОДТВЕРЖДЕНО | Габаритный профиль типового TFT; проверить display_window_coupon и изменить по своей плате |
| mainboard.width | 70.0 | мм | ИЗМЕРЕНО ПОЛЬЗОВАТЕЛЕМ | Макетная плата 70x90 мм; уточнение 01.11.2026 |
| mainboard.height | 90.0 | мм | ИЗМЕРЕНО ПОЛЬЗОВАТЕЛЕМ | Макетная плата 70x90 мм; уточнение 01.11.2026 |
| mainboard.thickness | 1.6 | мм | ПРОЕКТНОЕ / ОБМЕРИТЬ | Общий родитель всей припаянной сборки; jack_tip_recess сдвигает плату и оба разъёма вместе, сохраняя защиту носика джека |
| mainboard.x | 0.0 | мм | ПРОЕКТНОЕ / ОБМЕРИТЬ | Общий родитель всей припаянной сборки; jack_tip_recess сдвигает плату и оба разъёма вместе, сохраняя защиту носика джека |
| mainboard.hole_diameter | 2.2 | мм | ПРОЕКТНОЕ / ОБМЕРИТЬ | Общий родитель всей припаянной сборки; jack_tip_recess сдвигает плату и оба разъёма вместе, сохраняя защиту носика джека |
| mainboard.boss_diameter | 5.6 | мм | ПРОЕКТНОЕ / ОБМЕРИТЬ | Общий родитель всей припаянной сборки; jack_tip_recess сдвигает плату и оба разъёма вместе, сохраняя защиту носика джека |
| mainboard.pilot_depth | 3.7 | мм | ПРОЕКТНОЕ / ОБМЕРИТЬ | Общий родитель всей припаянной сборки; jack_tip_recess сдвигает плату и оба разъёма вместе, сохраняя защиту носика джека |
| mainboard.component_height | 7.0 | мм | ПРОЕКТНОЕ / ОБМЕРИТЬ | Общий родитель всей припаянной сборки; jack_tip_recess сдвигает плату и оба разъёма вместе, сохраняя защиту носика джека |
| mainboard.rear_solder_height | 2.0 | мм | ПРОЕКТНОЕ / ОБМЕРИТЬ | Общий родитель всей припаянной сборки; jack_tip_recess сдвигает плату и оба разъёма вместе, сохраняя защиту носика джека |
| mainboard.stack_to_wheel_face | 22.0 | мм | ОЦЕНКА ПОЛЬЗОВАТЕЛЯ С ЗАПАСОМ | От низа платы/пайки до лица колеса около 20 мм; для модели выбрано 22 мм. Проверить осевой пробник |
| mainboard.mount_from_left_bottom | [[67.0, 3.0], [3.0, 87.0], [67.0, 87.0]] | мм | НЕ ОБМЕРЕНО | Три стартовых отверстия от ЛЕВОГО НИЖНЕГО края платы. Не сверлить плату по этому файлу; проверить реальную разводку и края |
| mainboard.jack_tip_recess | 1.0 | мм | ПРОЕКТНОЕ / ОБМЕРИТЬ | Общий родитель всей припаянной сборки; jack_tip_recess сдвигает плату и оба разъёма вместе, сохраняя защиту носика джека |
| tp4056.pcb_width | 17.0 | мм | НОМИНАЛ ИЗ ЗАДАНИЯ | 28x17x4 дано пользователем; выступ USB/толщина PCB/реальная высота требуют примерки |
| tp4056.pcb_length | 28.0 | мм | НОМИНАЛ ИЗ ЗАДАНИЯ | 28x17x4 дано пользователем; выступ USB/толщина PCB/реальная высота требуют примерки |
| tp4056.module_height | 4.0 | мм | НОМИНАЛ ИЗ ЗАДАНИЯ | 28x17x4 дано пользователем; выступ USB/толщина PCB/реальная высота требуют примерки |
| tp4056.pcb_thickness | 1.0 | мм | ПРОЕКТНОЕ / ПРИМЕРИТЬ | Высоты над платой и размер USB не обмерены. Геометрия привязана к mainboard; отдельного кармана/прижима TP4056 нет |
| tp4056.usb_left_from_board_left | 6.5 | мм | ПРИМЕРНО ИЗМЕРЕНО ПОЛЬЗОВАТЕЛЕМ | Диапазон 6–7 мм; выбран центр 6.5. Перед финальным корпусом обмерить |
| tp4056.usb_tip_beyond_board | 6.5 | мм | ПРИМЕРНО ИЗМЕРЕНО ПОЛЬЗОВАТЕЛЕМ | Диапазон 6–7 мм; выбран центр 6.5. Перед финальным корпусом обмерить |
| tp4056.mount_standoff | 0.2 | мм | ПРОЕКТНОЕ / ПРИМЕРИТЬ | Высоты над платой и размер USB не обмерены. Геометрия привязана к mainboard; отдельного кармана/прижима TP4056 нет |
| tp4056.usb_axis_above_pcb_rear | 2.5 | мм | ПРОЕКТНОЕ / ПРИМЕРИТЬ | Высоты над платой и размер USB не обмерены. Геометрия привязана к mainboard; отдельного кармана/прижима TP4056 нет |
| tp4056.usb_protrusion | 1.5 | мм | ПРОЕКТНОЕ / ПРИМЕРИТЬ | Высоты над платой и размер USB не обмерены. Геометрия привязана к mainboard; отдельного кармана/прижима TP4056 нет |
| tp4056.usb_width | 8.8 | мм | ПРОЕКТНОЕ / ПРИМЕРИТЬ | Высоты над платой и размер USB не обмерены. Геометрия привязана к mainboard; отдельного кармана/прижима TP4056 нет |
| tp4056.usb_height | 3.0 | мм | ПРОЕКТНОЕ / ПРИМЕРИТЬ | Высоты над платой и размер USB не обмерены. Геометрия привязана к mainboard; отдельного кармана/прижима TP4056 нет |
| tp4056.usb_metal_length | 7.0 | мм | ПРОЕКТНОЕ / ПРИМЕРИТЬ | Высоты над платой и размер USB не обмерены. Геометрия привязана к mainboard; отдельного кармана/прижима TP4056 нет |
| tp4056.aperture_width | 9.6 | мм | ПРОЕКТНОЕ / ПРИМЕРИТЬ | Высоты над платой и размер USB не обмерены. Геометрия привязана к mainboard; отдельного кармана/прижима TP4056 нет |
| tp4056.aperture_height | 3.8 | мм | ПРОЕКТНОЕ / ПРИМЕРИТЬ | Высоты над платой и размер USB не обмерены. Геометрия привязана к mainboard; отдельного кармана/прижима TP4056 нет |
| tp4056.tunnel_wall | 1.6 | мм | ПРОЕКТНОЕ / ПРИМЕРИТЬ | Высоты над платой и размер USB не обмерены. Геометрия привязана к mainboard; отдельного кармана/прижима TP4056 нет |
| tp4056.body_clearance | 0.3 | мм | ПРОЕКТНОЕ / ПРИМЕРИТЬ | Высоты над платой и размер USB не обмерены. Геометрия привязана к mainboard; отдельного кармана/прижима TP4056 нет |
| jack.body_width | 11.5 | мм | ЧЕРТЁЖ АНАЛОГА | XKB PJ-324MX A1, 10.09.2024; соответствие вашей детали не подтверждено |
| jack.body_length | 14.2 | мм | ЧЕРТЁЖ АНАЛОГА | XKB PJ-324MX A1, 10.09.2024; соответствие вашей детали не подтверждено |
| jack.body_height | 6.45 | мм | ЧЕРТЁЖ АНАЛОГА | XKB PJ-324MX A1, 10.09.2024; соответствие вашей детали не подтверждено |
| jack.body_x_offset | -0.25 | мм | ЧЕРТЁЖ АНАЛОГА | XKB PJ-324MX A1, 10.09.2024; соответствие вашей детали не подтверждено |
| jack.axis_above_body_bottom | 3.0 | мм | ЧЕРТЁЖ АНАЛОГА | XKB PJ-324MX A1, 10.09.2024; соответствие вашей детали не подтверждено |
| jack.thread_diameter | 6.0 | мм | ЧЕРТЁЖ АНАЛОГА | XKB PJ-324MX A1, 10.09.2024; соответствие вашей детали не подтверждено |
| jack.thread_length | 3.55 | мм | ЧЕРТЁЖ АНАЛОГА | XKB PJ-324MX A1, 10.09.2024; соответствие вашей детали не подтверждено |
| jack.bore_diameter | 3.6 | мм | ЧЕРТЁЖ АНАЛОГА | XKB PJ-324MX A1, 10.09.2024; соответствие вашей детали не подтверждено |
| jack.panel_hole_diameter | 6.3 | мм | ПРОЕКТНОЕ / ПРИМЕРИТЬ | Посадка/положение подбираются jack/bottom coupons |
| jack.panel_thickness | 1.6 | мм | ПРОЕКТНОЕ / ПРИМЕРИТЬ | Посадка/положение подбираются jack/bottom coupons |
| jack.nut_diameter | 8.2 | мм | НЕ ПОДТВЕРЖДЕНО | Габарит гайки оценён; проверить ваш экземпляр и полное зацепление |
| jack.nut_thickness | 1.6 | мм | НЕ ПОДТВЕРЖДЕНО | Габарит гайки оценён; проверить ваш экземпляр и полное зацепление |
| jack.body_clearance | 0.3 | мм | ПРОЕКТНОЕ / ПРИМЕРИТЬ | Посадка/положение подбираются jack/bottom coupons |
| jack.pin_length | 3.0 | мм | ЧЕРТЁЖ АНАЛОГА | XKB PJ-324MX A1, 10.09.2024; соответствие вашей детали не подтверждено |
| jack.gap_from_usb_right | 8.0 | мм | ПРИМЕРНО ИЗМЕРЕНО ПОЛЬЗОВАТЕЛЕМ | Зазор около 8 мм между металлическими краями; выступ 7–8 мм до конца резьбы. Высота оси не обмерена |
| jack.tip_beyond_board | 7.5 | мм | ПРИМЕРНО ИЗМЕРЕНО ПОЛЬЗОВАТЕЛЕМ | Зазор около 8 мм между металлическими краями; выступ 7–8 мм до конца резьбы. Высота оси не обмерена |
| jack.mount_standoff | 0.2 | мм | ПРОЕКТНОЕ / ПРИМЕРИТЬ | Посадка/положение подбираются jack/bottom coupons |
| jack.nut_access_diameter | 11.0 | мм | ПРОЕКТНОЕ / ПРИМЕРИТЬ | Посадка/положение подбираются jack/bottom coupons |
| jack.seat_outer_diameter | 13.0 | мм | ПРОЕКТНОЕ / ПРИМЕРИТЬ | Посадка/положение подбираются jack/bottom coupons |
| hold.x | 0.0 | мм | НЕ ПОДТВЕРЖДЕНО / ПРИМЕРИТЬ | Семейство SS22F32 либо компактный аналог; тип на фото не установлен. Есть отдельные шаги отверстий, окна и карманы |
| hold.center_depth | 17.0 | мм | НЕ ПОДТВЕРЖДЕНО / ПРИМЕРИТЬ | Семейство SS22F32 либо компактный аналог; тип на фото не установлен. Есть отдельные шаги отверстий, окна и карманы |
| hold.travel | 3.0 | мм | НЕ ПОДТВЕРЖДЕНО / ПРИМЕРИТЬ | Семейство SS22F32 либо компактный аналог; тип на фото не установлен. Есть отдельные шаги отверстий, окна и карманы |
| hold.body_length_x | 15.7 | мм | НЕ ПОДТВЕРЖДЕНО / ПРИМЕРИТЬ | Семейство SS22F32 либо компактный аналог; тип на фото не установлен. Есть отдельные шаги отверстий, окна и карманы |
| hold.body_width_z | 7.4 | мм | НЕ ПОДТВЕРЖДЕНО / ПРИМЕРИТЬ | Семейство SS22F32 либо компактный аналог; тип на фото не установлен. Есть отдельные шаги отверстий, окна и карманы |
| hold.body_depth_y | 6.5 | мм | НЕ ПОДТВЕРЖДЕНО / ПРИМЕРИТЬ | Семейство SS22F32 либо компактный аналог; тип на фото не установлен. Есть отдельные шаги отверстий, окна и карманы |
| hold.flange_length | 23.3 | мм | НЕ ПОДТВЕРЖДЕНО / ПРИМЕРИТЬ | Семейство SS22F32 либо компактный аналог; тип на фото не установлен. Есть отдельные шаги отверстий, окна и карманы |
| hold.flange_width_z | 5.5 | мм | НЕ ПОДТВЕРЖДЕНО / ПРИМЕРИТЬ | Семейство SS22F32 либо компактный аналог; тип на фото не установлен. Есть отдельные шаги отверстий, окна и карманы |
| hold.flange_thickness | 0.5 | мм | НЕ ПОДТВЕРЖДЕНО / ПРИМЕРИТЬ | Семейство SS22F32 либо компактный аналог; тип на фото не установлен. Есть отдельные шаги отверстий, окна и карманы |
| hold.hole_pitch | 19.0 | мм | НЕ ПОДТВЕРЖДЕНО / ПРИМЕРИТЬ | Семейство SS22F32 либо компактный аналог; тип на фото не установлен. Есть отдельные шаги отверстий, окна и карманы |
| hold.hole_diameter | 2.2 | мм | НЕ ПОДТВЕРЖДЕНО / ПРИМЕРИТЬ | Семейство SS22F32 либо компактный аналог; тип на фото не установлен. Есть отдельные шаги отверстий, окна и карманы |
| hold.lever_width_x | 3.8 | мм | НЕ ПОДТВЕРЖДЕНО / ПРИМЕРИТЬ | Семейство SS22F32 либо компактный аналог; тип на фото не установлен. Есть отдельные шаги отверстий, окна и карманы |
| hold.lever_width_z | 2.0 | мм | НЕ ПОДТВЕРЖДЕНО / ПРИМЕРИТЬ | Семейство SS22F32 либо компактный аналог; тип на фото не установлен. Есть отдельные шаги отверстий, окна и карманы |
| hold.lever_length_y | 5.0 | мм | НЕ ПОДТВЕРЖДЕНО / ПРИМЕРИТЬ | Семейство SS22F32 либо компактный аналог; тип на фото не установлен. Есть отдельные шаги отверстий, окна и карманы |
| hold.terminal_length_y | 3.0 | мм | НЕ ПОДТВЕРЖДЕНО / ПРИМЕРИТЬ | Семейство SS22F32 либо компактный аналог; тип на фото не установлен. Есть отдельные шаги отверстий, окна и карманы |
| hold.standoff_height | 2.4 | мм | НЕ ПОДТВЕРЖДЕНО / ПРИМЕРИТЬ | Семейство SS22F32 либо компактный аналог; тип на фото не установлен. Есть отдельные шаги отверстий, окна и карманы |
| hold.boss_diameter | 5.2 | мм | НЕ ПОДТВЕРЖДЕНО / ПРИМЕРИТЬ | Семейство SS22F32 либо компактный аналог; тип на фото не установлен. Есть отдельные шаги отверстий, окна и карманы |
| hold.pilot_depth | 3.7 | мм | НЕ ПОДТВЕРЖДЕНО / ПРИМЕРИТЬ | Семейство SS22F32 либо компактный аналог; тип на фото не установлен. Есть отдельные шаги отверстий, окна и карманы |
| hold.window_clearance | 0.2 | мм | НЕ ПОДТВЕРЖДЕНО / ПРИМЕРИТЬ | Семейство SS22F32 либо компактный аналог; тип на фото не установлен. Есть отдельные шаги отверстий, окна и карманы |
| hold.lever_gap | 0.0 | мм | НЕ ПОДТВЕРЖДЕНО / ПРИМЕРИТЬ | Семейство SS22F32 либо компактный аналог; тип на фото не установлен. Есть отдельные шаги отверстий, окна и карманы |
| hold.neck_length_x | 7.0 | мм | НЕ ПОДТВЕРЖДЕНО / ПРИМЕРИТЬ | Семейство SS22F32 либо компактный аналог; тип на фото не установлен. Есть отдельные шаги отверстий, окна и карманы |
| hold.neck_width_z | 4.4 | мм | НЕ ПОДТВЕРЖДЕНО / ПРИМЕРИТЬ | Семейство SS22F32 либо компактный аналог; тип на фото не установлен. Есть отдельные шаги отверстий, окна и карманы |
| hold.neck_inner_protrusion | 0.4 | мм | НЕ ПОДТВЕРЖДЕНО / ПРИМЕРИТЬ | Семейство SS22F32 либо компактный аналог; тип на фото не установлен. Есть отдельные шаги отверстий, окна и карманы |
| hold.cap_length_x | 14.0 | мм | НЕ ПОДТВЕРЖДЕНО / ПРИМЕРИТЬ | Семейство SS22F32 либо компактный аналог; тип на фото не установлен. Есть отдельные шаги отверстий, окна и карманы |
| hold.cap_width_z | 8.4 | мм | НЕ ПОДТВЕРЖДЕНО / ПРИМЕРИТЬ | Семейство SS22F32 либо компактный аналог; тип на фото не установлен. Есть отдельные шаги отверстий, окна и карманы |
| hold.cap_thickness_y | 1.8 | мм | НЕ ПОДТВЕРЖДЕНО / ПРИМЕРИТЬ | Семейство SS22F32 либо компактный аналог; тип на фото не установлен. Есть отдельные шаги отверстий, окна и карманы |
| hold.cap_wall_gap | 0.2 | мм | НЕ ПОДТВЕРЖДЕНО / ПРИМЕРИТЬ | Семейство SS22F32 либо компактный аналог; тип на фото не установлен. Есть отдельные шаги отверстий, окна и карманы |
| hold.pocket_end_gap | 0.2 | мм | НЕ ПОДТВЕРЖДЕНО / ПРИМЕРИТЬ | Семейство SS22F32 либо компактный аналог; тип на фото не установлен. Есть отдельные шаги отверстий, окна и карманы |
| hold.cap_corner_radius | 1.2 | мм | НЕ ПОДТВЕРЖДЕНО / ПРИМЕРИТЬ | Семейство SS22F32 либо компактный аналог; тип на фото не установлен. Есть отдельные шаги отверстий, окна и карманы |
| hold.grip_rib_count | 3 | шт | НЕ ПОДТВЕРЖДЕНО / ПРИМЕРИТЬ | Семейство SS22F32 либо компактный аналог; тип на фото не установлен. Есть отдельные шаги отверстий, окна и карманы |
| hold.grip_rib_width | 0.7 | мм | НЕ ПОДТВЕРЖДЕНО / ПРИМЕРИТЬ | Семейство SS22F32 либо компактный аналог; тип на фото не установлен. Есть отдельные шаги отверстий, окна и карманы |
| hold.grip_rib_height | 0.25 | мм | НЕ ПОДТВЕРЖДЕНО / ПРИМЕРИТЬ | Семейство SS22F32 либо компактный аналог; тип на фото не установлен. Есть отдельные шаги отверстий, окна и карманы |
| hold.grip_rib_pitch | 2.0 | мм | НЕ ПОДТВЕРЖДЕНО / ПРИМЕРИТЬ | Семейство SS22F32 либо компактный аналог; тип на фото не установлен. Есть отдельные шаги отверстий, окна и карманы |
| fasteners.m2_pilot | 1.7 | мм | ПРОЕКТНОЕ / ПРОБНИК | Пилоты и проходные отверстия проверяются под материал и принтер |
| fasteners.m25_pilot | 2.1 | мм | ПРОЕКТНОЕ / ПРОБНИК | Пилоты и проходные отверстия проверяются под материал и принтер |
| fasteners.m2_clearance | 2.2 | мм | ПРОЕКТНОЕ / ПРОБНИК | Пилоты и проходные отверстия проверяются под материал и принтер |
| fasteners.m25_clearance | 2.8 | мм | ПРОЕКТНОЕ / ПРОБНИК | Пилоты и проходные отверстия проверяются под материал и принтер |
| fasteners.wheel_screw | 4.0 | мм | ИЗ НАБОРА ПОЛЬЗОВАТЕЛЯ | Выбран доступный винт; допустимость длины зависит от приведённого стека деталей |
| fasteners.display_screw | 5.0 | мм | ИЗ НАБОРА ПОЛЬЗОВАТЕЛЯ | Выбран доступный винт; допустимость длины зависит от приведённого стека деталей |
| fasteners.mainboard_screw | 5.0 | мм | ИЗ НАБОРА ПОЛЬЗОВАТЕЛЯ | Выбран доступный винт; допустимость длины зависит от приведённого стека деталей |
| fasteners.hold_screw | 4.0 | мм | ИЗ НАБОРА ПОЛЬЗОВАТЕЛЯ | Выбран доступный винт; допустимость длины зависит от приведённого стека деталей |
| fasteners.closure_screw | 8.0 | мм | ИЗ НАБОРА ПОЛЬЗОВАТЕЛЯ | Выбран доступный винт; допустимость длины зависит от приведённого стека деталей |
| fasteners.m2_head_diameter | 4.0 | мм | НЕ ПОДТВЕРЖДЕНО | Головки винтов условные, измерить фактические |
| fasteners.m25_head_diameter | 5.0 | мм | НЕ ПОДТВЕРЖДЕНО | Головки винтов условные, измерить фактические |
| fasteners.head_height | 2.0 | мм | НЕ ПОДТВЕРЖДЕНО | Головки винтов условные, измерить фактические |
| fasteners.minimum_blind_floor | 0.6 | мм | ПРОЕКТНОЕ / ПРОБНИК | Пилоты и проходные отверстия проверяются под материал и принтер |
| fasteners.connector_insert_screw | 4.0 | мм | ИЗ НАБОРА ПОЛЬЗОВАТЕЛЯ | Выбран доступный винт; допустимость длины зависит от приведённого стека деталей |
| coupons.window_border | 5.0 | мм | ПРОЕКТНОЕ | Серия калибров, маркировка и точность сетки |
| coupons.wheel_border | 5.0 | мм | ПРОЕКТНОЕ | Серия калибров, маркировка и точность сетки |
| coupons.wheel_step_extras | [0.0, 0.1, 0.2] | мм | ПРОЕКТНОЕ | Серия калибров, маркировка и точность сетки |
| coupons.clearances | [0.15, 0.2, 0.25, 0.3] | мм | ПРОЕКТНОЕ | Серия калибров, маркировка и точность сетки |
| coupons.lever_gaps | [-0.05, 0.0, 0.1, 0.2] | мм | ПРОЕКТНОЕ | Серия калибров, маркировка и точность сетки |
| coupons.hold_hole_pitches | [15.0, 19.0] | мм | ПРОЕКТНОЕ | Серия калибров, маркировка и точность сетки |
| coupons.jack_panel_thicknesses | [1.2, 1.6, 2.0, 2.4] | мм | ПРОЕКТНОЕ | Серия калибров, маркировка и точность сетки |
| coupons.jack_holes | [6.1, 6.3, 6.5] | мм | ПРОЕКТНОЕ | Серия калибров, маркировка и точность сетки |
| coupons.usb_recesses | [1.5, 2.0, 2.5] | мм | ПРОЕКТНОЕ | Серия калибров, маркировка и точность сетки |
| coupons.m2_pilots | [1.6, 1.7, 1.8] | мм | ПРОЕКТНОЕ | Серия калибров, маркировка и точность сетки |
| coupons.m25_pilots | [2.0, 2.1, 2.2] | мм | ПРОЕКТНОЕ | Серия калибров, маркировка и точность сетки |
| coupons.jack_plate_width | 24.0 | мм | ПРОЕКТНОЕ | Серия калибров, маркировка и точность сетки |
| coupons.jack_plate_height | 24.0 | мм | ПРОЕКТНОЕ | Серия калибров, маркировка и точность сетки |
| coupons.hold_patch_width | 34.0 | мм | ПРОЕКТНОЕ | Серия калибров, маркировка и точность сетки |
| coupons.hold_patch_height | 20.0 | мм | ПРОЕКТНОЕ | Серия калибров, маркировка и точность сетки |
| coupons.screw_bar_width | 82.0 | мм | ПРОЕКТНОЕ | Серия калибров, маркировка и точность сетки |
| coupons.screw_bar_height | 24.0 | мм | ПРОЕКТНОЕ | Серия калибров, маркировка и точность сетки |
| coupons.screw_bar_base | 2.0 | мм | ПРОЕКТНОЕ | Серия калибров, маркировка и точность сетки |
| coupons.screw_boss_height | 5.0 | мм | ПРОЕКТНОЕ | Серия калибров, маркировка и точность сетки |
| coupons.tolerance_key_width | 8.0 | мм | ПРОЕКТНОЕ | Серия калибров, маркировка и точность сетки |
| coupons.tolerance_key_height | 6.0 | мм | ПРОЕКТНОЕ | Серия калибров, маркировка и точность сетки |
| coupons.tolerance_frame_thickness | 3.0 | мм | ПРОЕКТНОЕ | Серия калибров, маркировка и точность сетки |
| coupons.bottom_patch_margin | 4.0 | мм | ПРОЕКТНОЕ | Серия калибров, маркировка и точность сетки |
| coupons.bottom_patch_length | 35.0 | мм | ПРОЕКТНОЕ | Серия калибров, маркировка и точность сетки |
| coupons.bottom_patch_front_depth | 12.0 | мм | ПРОЕКТНОЕ | Серия калибров, маркировка и точность сетки |
| coupons.marker_diameter | 0.8 | мм | ПРОЕКТНОЕ | Серия калибров, маркировка и точность сетки |
| coupons.marker_depth | 0.35 | мм | ПРОЕКТНОЕ | Серия калибров, маркировка и точность сетки |
| coupons.stack_gauge_jaw_length | 35.0 | мм | ПРОЕКТНОЕ | Серия калибров, маркировка и точность сетки |
| coupons.stack_gauge_width | 10.0 | мм | ПРОЕКТНОЕ | Серия калибров, маркировка и точность сетки |
| coupons.stack_gauge_wall | 2.4 | мм | ПРОЕКТНОЕ | Серия калибров, маркировка и точность сетки |
| coupons.stl_linear_tolerance | 0.035 | мм | ПРОЕКТНОЕ | Серия калибров, маркировка и точность сетки |
| coupons.stl_angular_tolerance | 0.1 | рад | ПРОЕКТНОЕ | Серия калибров, маркировка и точность сетки |
| coupons.insert_clearances | [0.15, 0.2, 0.25, 0.3] | мм | ПРОЕКТНОЕ | Серия калибров, маркировка и точность сетки |
| coupons.connector_aperture_extras | [0.0, 0.2, 0.4] | мм | ПРОЕКТНОЕ | Серия калибров, маркировка и точность сетки |
| coupons.usb_cable_side_clearances | [0.3, 0.4, 0.5] | мм | ПРОЕКТНОЕ | Серия калибров, маркировка и точность сетки |
| acrylic.stock_width | 200.0 | мм | НОМИНАЛ ИЗ ЗАДАНИЯ | Лист акрила пользователя 200x100x1; фактическую толщину измерить перед вклейкой |
| acrylic.stock_height | 100.0 | мм | НОМИНАЛ ИЗ ЗАДАНИЯ | Лист акрила пользователя 200x100x1; фактическую толщину измерить перед вклейкой |
| acrylic.thickness | 1.0 | мм | НОМИНАЛ ИЗ ЗАДАНИЯ | Лист акрила пользователя 200x100x1; фактическую толщину измерить перед вклейкой |
| acrylic.overlap | 3.0 | мм | ПРОЕКТНОЕ / ПРОБНИК | Основной вариант: плоский акрил почти вровень и задняя клеевая рамка. front_lip/stop_pad используются только альтернативой rear_lip. Контуры лазера номинальные, пропил в CAM |
| acrylic.corner_radius | 2.0 | мм | ПРОЕКТНОЕ / ПРОБНИК | Основной вариант: плоский акрил почти вровень и задняя клеевая рамка. front_lip/stop_pad используются только альтернативой rear_lip. Контуры лазера номинальные, пропил в CAM |
| acrylic.pocket_side_clearance | 0.2 | мм | ПРОЕКТНОЕ / ПРОБНИК | Основной вариант: плоский акрил почти вровень и задняя клеевая рамка. front_lip/stop_pad используются только альтернативой rear_lip. Контуры лазера номинальные, пропил в CAM |
| acrylic.front_lip_thickness | 0.8 | мм | ПРОЕКТНОЕ / ПРОБНИК | Основной вариант: плоский акрил почти вровень и задняя клеевая рамка. front_lip/stop_pad используются только альтернативой rear_lip. Контуры лазера номинальные, пропил в CAM |
| acrylic.adhesive_gap | 0.2 | мм | ПРОЕКТНОЕ / ПРОБНИК | Основной вариант: плоский акрил почти вровень и задняя клеевая рамка. front_lip/stop_pad используются только альтернативой rear_lip. Контуры лазера номинальные, пропил в CAM |
| acrylic.adhesive_inner_margin | 0.5 | мм | ПРОЕКТНОЕ / ПРОБНИК | Основной вариант: плоский акрил почти вровень и задняя клеевая рамка. front_lip/stop_pad используются только альтернативой rear_lip. Контуры лазера номинальные, пропил в CAM |
| acrylic.stop_pad_diameter | 1.2 | мм | ПРОЕКТНОЕ / ПРОБНИК | Основной вариант: плоский акрил почти вровень и задняя клеевая рамка. front_lip/stop_pad используются только альтернативой rear_lip. Контуры лазера номинальные, пропил в CAM |
| acrylic.minimum_display_air_gap | 0.4 | мм | ПРОЕКТНОЕ / ПРОБНИК | Основной вариант: плоский акрил почти вровень и задняя клеевая рамка. front_lip/stop_pad используются только альтернативой rear_lip. Контуры лазера номинальные, пропил в CAM |
| acrylic.fit_clearances | [0.15, 0.2, 0.25, 0.3] | мм | ПРОЕКТНОЕ / ПРОБНИК | Основной вариант: плоский акрил почти вровень и задняя клеевая рамка. front_lip/stop_pad используются только альтернативой rear_lip. Контуры лазера номинальные, пропил в CAM |
| acrylic.sheet_margin | 5.0 | мм | ПРОЕКТНОЕ / ПРОБНИК | Основной вариант: плоский акрил почти вровень и задняя клеевая рамка. front_lip/stop_pad используются только альтернативой rear_lip. Контуры лазера номинальные, пропил в CAM |
| acrylic.sheet_part_gap | 3.0 | мм | ПРОЕКТНОЕ / ПРОБНИК | Основной вариант: плоский акрил почти вровень и задняя клеевая рамка. front_lip/stop_pad используются только альтернативой rear_lip. Контуры лазера номинальные, пропил в CAM |
| acrylic.svg_stroke_width | 0.01 | мм | ПРОЕКТНОЕ / ПРОБНИК | Основной вариант: плоский акрил почти вровень и задняя клеевая рамка. front_lip/stop_pad используются только альтернативой rear_lip. Контуры лазера номинальные, пропил в CAM |
| acrylic.mount_style | flush_carrier | - | ПРОЕКТНОЕ / ПРОБНИК | Основной вариант: плоский акрил почти вровень и задняя клеевая рамка. front_lip/stop_pad используются только альтернативой rear_lip. Контуры лазера номинальные, пропил в CAM |
| acrylic.face_recess | 0.1 | мм | ПРОЕКТНОЕ / ПРОБНИК | Основной вариант: плоский акрил почти вровень и задняя клеевая рамка. front_lip/stop_pad используются только альтернативой rear_lip. Контуры лазера номинальные, пропил в CAM |
| connector_insert.width | 54.0 | мм | ПРОЕКТНОЕ / ПРОБНИК | Съёмная нижняя вставка для всей припаянной сборки; M2x4 снаружи. Проверить bottom_edge_coupon и высоты осей |
| connector_insert.x | -12.0 | мм | ПРОЕКТНОЕ / ПРОБНИК | Съёмная нижняя вставка для всей припаянной сборки; M2x4 снаружи. Проверить bottom_edge_coupon и высоты осей |
| connector_insert.gap | 0.2 | мм | ПРОЕКТНОЕ / ПРОБНИК | Съёмная нижняя вставка для всей припаянной сборки; M2x4 снаружи. Проверить bottom_edge_coupon и высоты осей |
| connector_insert.wall_thickness | 2.0 | мм | ПРОЕКТНОЕ / ПРОБНИК | Съёмная нижняя вставка для всей припаянной сборки; M2x4 снаружи. Проверить bottom_edge_coupon и высоты осей |
| connector_insert.mount_from_left | [3.5, 50.5] | мм | ПРОЕКТНОЕ / ПРОБНИК | Съёмная нижняя вставка для всей припаянной сборки; M2x4 снаружи. Проверить bottom_edge_coupon и высоты осей |
| connector_insert.mount_depth | 7.5 | мм | ПРОЕКТНОЕ / ПРОБНИК | Съёмная нижняя вставка для всей припаянной сборки; M2x4 снаружи. Проверить bottom_edge_coupon и высоты осей |
| connector_insert.boss_diameter | 4.8 | мм | ПРОЕКТНОЕ / ПРОБНИК | Съёмная нижняя вставка для всей припаянной сборки; M2x4 снаружи. Проверить bottom_edge_coupon и высоты осей |
| connector_insert.boss_length | 2.8 | мм | ПРОЕКТНОЕ / ПРОБНИК | Съёмная нижняя вставка для всей припаянной сборки; M2x4 снаружи. Проверить bottom_edge_coupon и высоты осей |
| connector_insert.pilot_depth | 2.3 | мм | ПРОЕКТНОЕ / ПРОБНИК | Съёмная нижняя вставка для всей припаянной сборки; M2x4 снаружи. Проверить bottom_edge_coupon и высоты осей |
| connector_insert.root_width | 4.8 | мм | ПРОЕКТНОЕ / ПРОБНИК | Съёмная нижняя вставка для всей припаянной сборки; M2x4 снаружи. Проверить bottom_edge_coupon и высоты осей |
| connector_insert.root_min_depth | 7.5 | мм | ПРОЕКТНОЕ / ПРОБНИК | Съёмная нижняя вставка для всей припаянной сборки; M2x4 снаружи. Проверить bottom_edge_coupon и высоты осей |
| connector_insert.tunnel_end_gap | 0.3 | мм | ПРОЕКТНОЕ / ПРОБНИК | Съёмная нижняя вставка для всей припаянной сборки; M2x4 снаружи. Проверить bottom_edge_coupon и высоты осей |
| connector_insert.assembly_clearance | 0.3 | мм | ПРОЕКТНОЕ / ПРОБНИК | Съёмная нижняя вставка для всей припаянной сборки; M2x4 снаружи. Проверить bottom_edge_coupon и высоты осей |
| lens_carrier.bond_width | 2.0 | мм | ПРОЕКТНОЕ / ПРОБНИК | Печатная задняя рамка: полоса клея 2, толщина 0.8, общие M2.5x5 с TFT. Сухая примерка и кондуктор перед вклейкой |
| lens_carrier.frame_thickness | 0.8 | мм | ПРОЕКТНОЕ / ПРОБНИК | Печатная задняя рамка: полоса клея 2, толщина 0.8, общие M2.5x5 с TFT. Сухая примерка и кондуктор перед вклейкой |
| lens_carrier.ear_thickness | 0.8 | мм | ПРОЕКТНОЕ / ПРОБНИК | Печатная задняя рамка: полоса клея 2, толщина 0.8, общие M2.5x5 с TFT. Сухая примерка и кондуктор перед вклейкой |
| lens_carrier.boss_side_clearance | 0.2 | мм | ПРОЕКТНОЕ / ПРОБНИК | Печатная задняя рамка: полоса клея 2, толщина 0.8, общие M2.5x5 с TFT. Сухая примерка и кондуктор перед вклейкой |
| lens_carrier.sleeve_wall | 1.4 | мм | ПРОЕКТНОЕ / ПРОБНИК | Печатная задняя рамка: полоса клея 2, толщина 0.8, общие M2.5x5 с TFT. Сухая примерка и кондуктор перед вклейкой |
| lens_carrier.panel_pocket_clearance | 0.2 | мм | ПРОЕКТНОЕ / ПРОБНИК | Печатная задняя рамка: полоса клея 2, толщина 0.8, общие M2.5x5 с TFT. Сухая примерка и кондуктор перед вклейкой |
| lens_carrier.panel_pocket_axial_clearance | 0.15 | мм | ПРОЕКТНОЕ / ПРОБНИК | Печатная задняя рамка: полоса клея 2, толщина 0.8, общие M2.5x5 с TFT. Сухая примерка и кондуктор перед вклейкой |
| lens_carrier.glass_side_clearance | 0.3 | мм | ПРОЕКТНОЕ / ПРОБНИК | Печатная задняя рамка: полоса клея 2, толщина 0.8, общие M2.5x5 с TFT. Сухая примерка и кондуктор перед вклейкой |
| lens_carrier.inner_corner_radius | 0.8 | мм | ПРОЕКТНОЕ / ПРОБНИК | Печатная задняя рамка: полоса клея 2, толщина 0.8, общие M2.5x5 с TFT. Сухая примерка и кондуктор перед вклейкой |
| lens_carrier.display_pilot_depth | 2.85 | мм | ПРОЕКТНОЕ / ПРОБНИК | Печатная задняя рамка: полоса клея 2, толщина 0.8, общие M2.5x5 с TFT. Сухая примерка и кондуктор перед вклейкой |
| lens_carrier.jig_base_thickness | 2.0 | мм | ПРОЕКТНОЕ / ПРОБНИК | Печатная задняя рамка: полоса клея 2, толщина 0.8, общие M2.5x5 с TFT. Сухая примерка и кондуктор перед вклейкой |
| lens_carrier.jig_border | 6.0 | мм | ПРОЕКТНОЕ / ПРОБНИК | Печатная задняя рамка: полоса клея 2, толщина 0.8, общие M2.5x5 с TFT. Сухая примерка и кондуктор перед вклейкой |
| lens_carrier.jig_lens_side_clearance | 0.3 | мм | ПРОЕКТНОЕ / ПРОБНИК | Печатная задняя рамка: полоса клея 2, толщина 0.8, общие M2.5x5 с TFT. Сухая примерка и кондуктор перед вклейкой |
| usb_cable.body_width | 9.7 | мм | ПРИМЕРНО ИЗМЕРЕНО ПОЛЬЗОВАТЕЛЕМ | 02.11.2026: корпус 9.7x5.6, металлический носик около 7. Систематическая погрешность штангенциркуля не измерена |
| usb_cable.body_height | 5.6 | мм | ПРИМЕРНО ИЗМЕРЕНО ПОЛЬЗОВАТЕЛЕМ | 02.11.2026: корпус 9.7x5.6, металлический носик около 7. Систематическая погрешность штангенциркуля не измерена |
| usb_cable.body_length | 16.0 | мм | НЕ ОБМЕРЕНО / ГАБАРИТ | Глубина сопряжения 6 мм и сечение металла условные; геометрический резерв не подтверждает электрический контакт. Проверить настоящим кабелем |
| usb_cable.metal_tip_length | 7.0 | мм | ПРИМЕРНО ИЗМЕРЕНО ПОЛЬЗОВАТЕЛЕМ | 02.11.2026: корпус 9.7x5.6, металлический носик около 7. Систематическая погрешность штангенциркуля не измерена |
| usb_cable.metal_width | 8.2 | мм | НЕ ОБМЕРЕНО / ГАБАРИТ | Глубина сопряжения 6 мм и сечение металла условные; геометрический резерв не подтверждает электрический контакт. Проверить настоящим кабелем |
| usb_cable.metal_height | 2.4 | мм | НЕ ОБМЕРЕНО / ГАБАРИТ | Глубина сопряжения 6 мм и сечение металла условные; геометрический резерв не подтверждает электрический контакт. Проверить настоящим кабелем |
| usb_cable.engagement_depth | 6.0 | мм | НЕ ОБМЕРЕНО / ГАБАРИТ | Глубина сопряжения 6 мм и сечение металла условные; геометрический резерв не подтверждает электрический контакт. Проверить настоящим кабелем |
| usb_cable.side_clearance | 0.4 | мм | ПРОЕКТНОЕ / ПРОБНИК | 0.4 зазора на сторону, 0.5 осевого резерва. В тесте суммарный размер корпуса увеличен на 0.2, носик укорочен на 0.2. Это допуск модели, не калибровка прибора |
| usb_cable.axial_clearance | 0.5 | мм | ПРОЕКТНОЕ / ПРОБНИК | 0.4 зазора на сторону, 0.5 осевого резерва. В тесте суммарный размер корпуса увеличен на 0.2, носик укорочен на 0.2. Это допуск модели, не калибровка прибора |
| usb_cable.well_wall | 1.6 | мм | ПРОЕКТНОЕ / ПРОБНИК | 0.4 зазора на сторону, 0.5 осевого резерва. В тесте суммарный размер корпуса увеличен на 0.2, носик укорочен на 0.2. Это допуск модели, не калибровка прибора |
| usb_cable.well_corner_radius | 0.6 | мм | ПРОЕКТНОЕ / ПРОБНИК | 0.4 зазора на сторону, 0.5 осевого резерва. В тесте суммарный размер корпуса увеличен на 0.2, носик укорочен на 0.2. Это допуск модели, не калибровка прибора |
| usb_cable.well_outer_radius | 1.6 | мм | ПРОЕКТНОЕ / ПРОБНИК | 0.4 зазора на сторону, 0.5 осевого резерва. В тесте суммарный размер корпуса увеличен на 0.2, носик укорочен на 0.2. Это допуск модели, не калибровка прибора |
| usb_cable.measurement_size_allowance | 0.2 | мм | ПРОЕКТНОЕ / ПРОБНИК | 0.4 зазора на сторону, 0.5 осевого резерва. В тесте суммарный размер корпуса увеличен на 0.2, носик укорочен на 0.2. Это допуск модели, не калибровка прибора |
| usb_cable.tip_length_allowance | 0.2 | мм | ПРОЕКТНОЕ / ПРОБНИК | 0.4 зазора на сторону, 0.5 осевого резерва. В тесте суммарный размер корпуса увеличен на 0.2, носик укорочен на 0.2. Это допуск модели, не калибровка прибора |
