IlyaBOT/MonoPod/Hardware/MonoPod_Enclosure_v04_USB_Flush_Acrylic_2026-11-02/reference/RIGID_ELECTRONICS_TASK_RU.txt

Уточнения пользователя 01.11.2026:
Миниджек и плата заряда припаяны к макетной плате. Это единая жёсткая сборка.
Макетка 70x90 мм.
Type-C выступает примерно на 6–7 мм, миниджек — на 7–8 мм.
От левого края макетки до левого края разъёма Type-C около 6–7 мм.
От правого края Type-C до левого края миниджека около 8 мм.
От самого низа платы до верха колеса при прижатом колесе примерно 20 мм;
с небольшим запасом взять высоту 22 мм.

Интерпретация: 22 мм — осевой габарит от нижней точки пайки до лица колеса;
выступ миниджека измерен до конца резьбового носика; боковой зазор 8 мм —
между металлической оболочкой USB-C и резьбовым носиком джека Ø6 мм.
Высоты осей, фактическая пайка, отверстия и тип джека ещё НЕ ОБМЕРЕНЫ.
