IlyaBOT/MonoPod/firmware/README_FLAC_PICTURE_SKIP_v0.10.7.1_RU.md

# MonoPod v0.10.7.1 — пропуск FLAC-обложек без загрузки в память

## Исправленная проблема

На некоторых FLAC-треках с большими изображениями внутри метаданных (например, PICTURE = 9 442 893 байт) декодер мог долго обрабатывать служебный блок и приводить к перезапуску ESP32-S3. Достоверная причина конкретного аппаратного сбоя (watchdog или исключение памяти) определяется только по UART panic/backtrace.

## Решение

Новый `DIY_iPod_Mono/FlacPictureSkipSource.h` — прозрачный seekable-фильтр перед `ChunkedFlacSource` и `SeekableFlacDecoder`.

- При запуске FLAC читает только `fLaC` и 4-байтные заголовки метаданных; перемещается через payload PICTURE через `seek`, без копирования в RAM/PSRAM.
- Вместо каждого PICTURE-блока генерирует 4-байтный пустой блок FLAC PADDING. LAST-флаг сохраняется.
- STREAMINFO, VORBIS_COMMENT, прочие служебные блоки и аудиокадры не меняются.
- `getSize`, `getPos`, `seek` работают в виртуальных смещениях; FLAC sample-accurate seek остаётся корректным.
- Записанный на microSD исходный файл не модифицируется; из файла ничего физически не удаляется.
- Если разметка FLAC недостоверна или содержит более 32 блоков PICTURE, воспроизведение этого файла отменяется с ошибкой, вместо чтения за пределами файла.

Путь: `AudioFileSourceSD` -> `FlacPictureSkipSource` -> `ChunkedFlacSource` -> `SeekableFlacDecoder` -> I2S.

## Проверка

- `tests/test_flac_picture_skip.py` генерирует FLAC с блоком PICTURE >9 MiB, собирает нативную проверку и запускает `flac --test` на виртуальном потоке.
- Нативный тест проверяет, что индекс не читает payload, а 500 произвольных seek возвращают правильные байты.
- С исходным файлом «Rinrin - All The Things She Said.flac» виртуальный выход FLAC был проверен декодером `flac --test`.
- Проверка исходников: `python -m pytest -q tests` — 55 passed, 1 skipped.
- Физическая сборка/прошивка на ESP32-S3 и испытания звука пока не выполнялись.

## Диагностика

Если устройство всё ещё перезагружается на этом треке, сохранить UART-вывод на скорости прошивки от момента PLAY до строки `Backtrace` или `Guru Meditation Error`. Вероятная следующая причина — ограничения декодера libFLAC, выделение PCM-буфера или просадка питания 3.3 В, а не обложка.
