IlyaBOT/MonoPod/MonoPod_Desktop/docs/AUDIT_RU.md

# Аудит исходников

Первый полный обход `I:\DIY_iPod_Mono` зафиксировал 1869 файлов в `original-inventory.json` (пути, размер, время изменения, SHA-256). В корне нет Git-репозитория: отличия ревизий установлены по содержимому, без утверждения о чистоте относительно неизвестного upstream. `revision-comparison.json` перечисляет изменения модулей между найденными деревьями.

На первом обходе самой поздней основной прошивкой была v0.9.0. Во время реализации появились распакованные v0.9.1 и v0.9.1.1. Проведён второй аудит, исходники и документация новой ветки перенесены на v0.9.1.1. Манифест этой базы и перечень отличий находятся в `baseline-refresh`. Ни один исходный файл v0.9.0 / v0.9.1 / v0.9.1.1 не изменён. Рабочая ветка — отдельная `MonoPod_v0.10.0`.

## Карта

| Дерево / модуль | Назначение и состояние до изменений |
|---|---|
| DIY_iPod_Mono, MonoPod_v0.6, v0.8.6…v0.9.1.1 | Исторические и основные Arduino-прошивки; основной актуальный sketch внутри версии |
| Studio/usb_sync.py, UsbSync.cpp | MPOD1 v3, HELLO/INFO, явные SYNC START/END, PUT/REPLACE/DELETE в /Music, SCAN, блоки NEXT до 1024 байт, CRC, временный файл / backup |
| Studio/device_api.py, WiFiSync.cpp | HTTP /api/info, /upload, /api/theme, /api/smoothing, /api/theme/reset, /time; в v0.9.1.1 STA сохраняется и AP используется резервно |
| SyncMode.cpp | Остановка аудио, блокировка нормального UI, один владелец SD: USB или Wi-Fi |
| Theme.cpp, Studio/theme_format.py | MPT1: 28 байт, 4 RGB565 цвета, две отсортированные таблицы 4bpp глифов, CRC payload |
| Display.cpp, MonoFont.h, UI.cpp | Геометрия 160×128, штатный сглаживаемый шрифт v0.9.1, поддержка пользовательских глифов |
| Library.cpp, AudioEngine.cpp | MP3/WAV/FLAC/raw AAC; .m4a/ALAC не поддерживаются; индекс плеера до 2048, сканирование до MAX_SCAN_DEPTH |
| BoardProbe, ESP8266_dev-tests, MonoPod_S3_DevTest_v1 | Отдельные аппаратные диагностики; не используются как основная прошивка |
| Wokwi-sim_dev, Wokwi_ILI9341, standalone_demo | Отдельные симуляторы/демонстрации; не подтверждают поведение физической платы |
| Hardware, hardware | KiCad, механика, аппаратные материалы; не изменялись |
| examples/S3_USB_MSC_Lab, tools/itunesdb_inspect.py | Изолированные опыты MSC/iTunes; не смешаны с MPOD1 |

До v0.10.0 отсутствовали LIST/STAT/READ, произвольные пользовательские каталоги, mkdir/rmdir/rename, USB-темы и расширенная палитра. Desktop требует соответствующих capabilities и не подменяет эти операции локальными данными.

GPIO, AudioEngine, Backlight, Input, схема питания и аппаратные настройки не перерабатывались. Bluetooth Classic по-прежнему исключён препроцессором для S3. Ограничение индекса плеера 2048 не является ограничением файлового менеджера: Desktop читает каталоги страницами и проверен на 2101 записи.

По последнему crash log дополнительно исправлен регресс Library.cpp, унаследованный от v0.9.0. Доказательство из совпадающего ELF и результаты — BOOT_REGRESSION_RU.md. Пользовательский badapple.bav сохранён из v0.9.0; в базе v0.9.1.1 этого файла не было.
