IlyaBOT/MonoPod/Hardware/MonoPod_Enclosure_v04_USB_Flush_Acrylic_2026-11-02/images/coupon_sheet.png

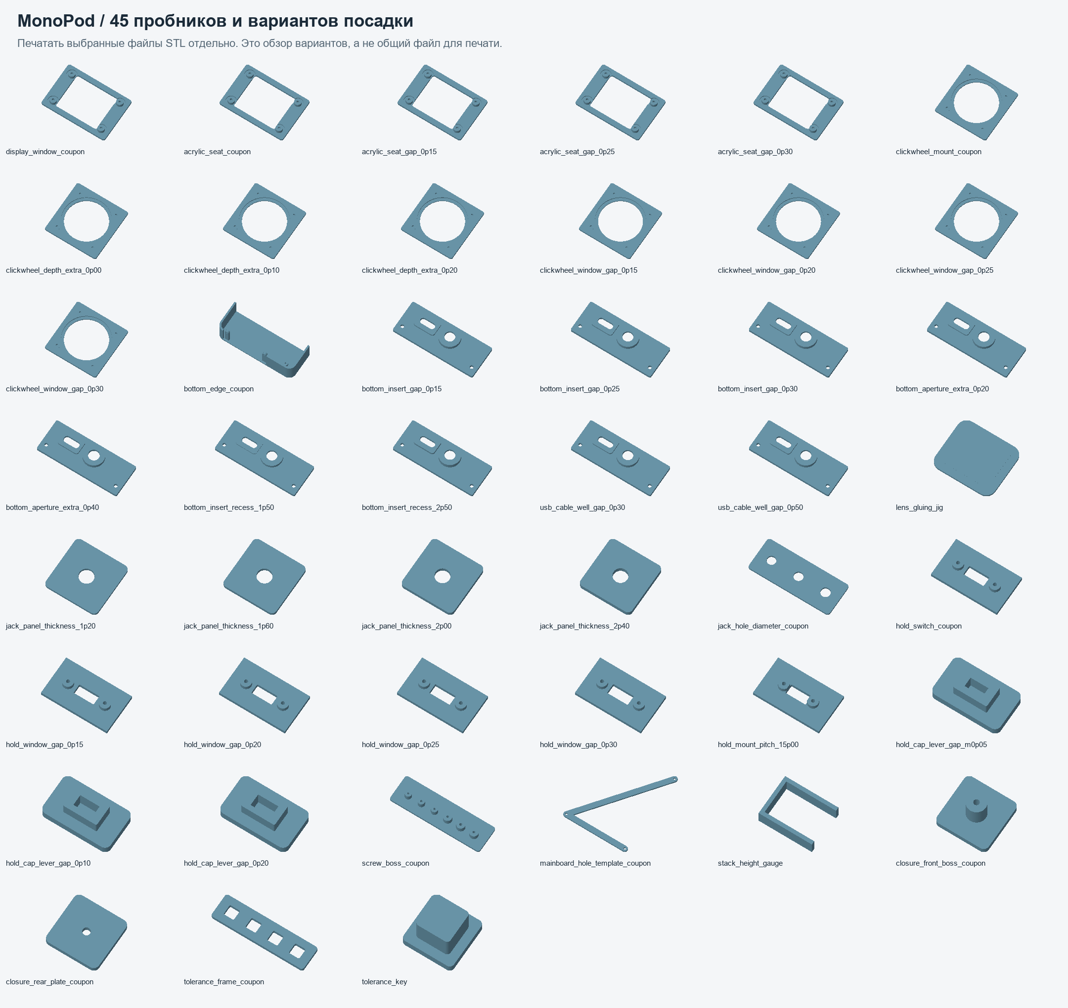
Hardware/MonoPod_Enclosure_v04_USB_Flush_Acrylic_2026-11-02/images/coupon_sheet.png
