IlyaBOT/MonoPod/Hardware/MonoPod_Enclosure_v04_USB_Flush_Acrylic_2026-11-02/reference/photos/photo_3_2026-11-01_18-29-50.jpg

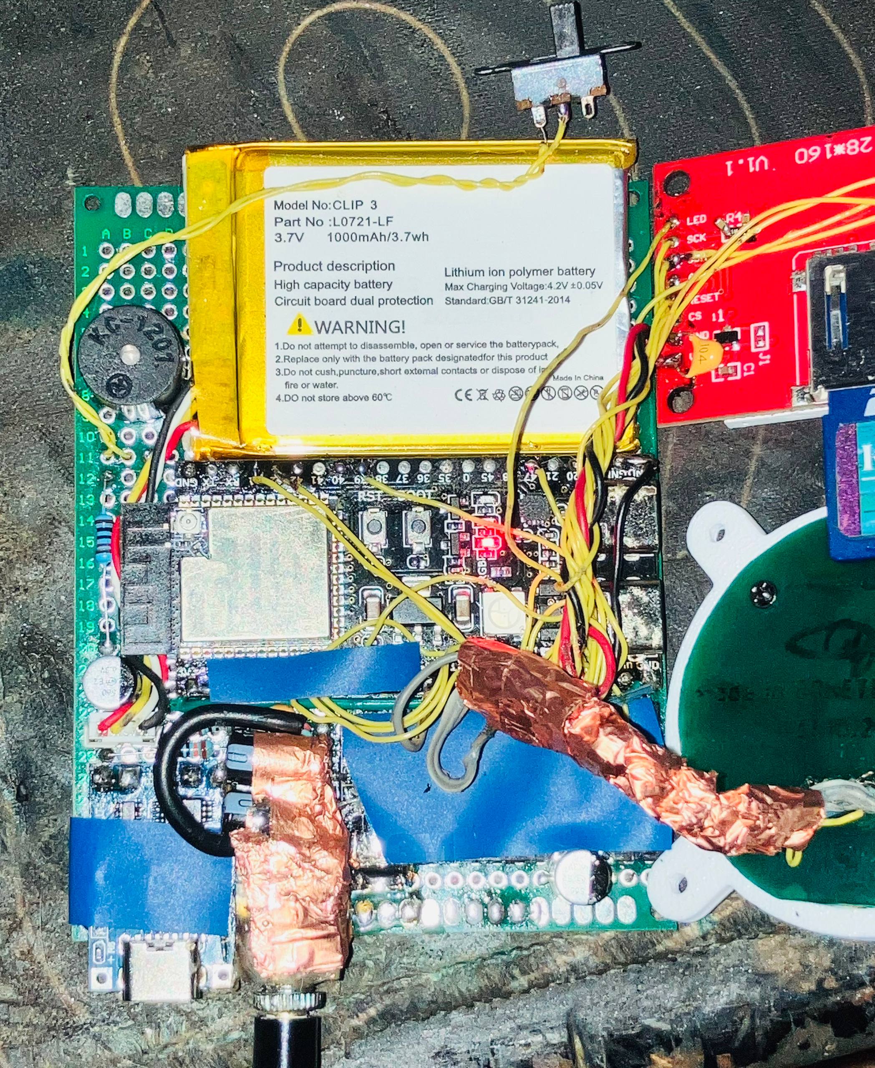
Hardware/MonoPod_Enclosure_v04_USB_Flush_Acrylic_2026-11-02/reference/photos/photo_3_2026-11-01_18-29-50.jpg
