IlyaBOT/MonoPod/Hardware/MonoPod_Enclosure_v04_USB_Flush_Acrylic_2026-11-02/reference/photos/rigid_electronics_2026-11-01.png

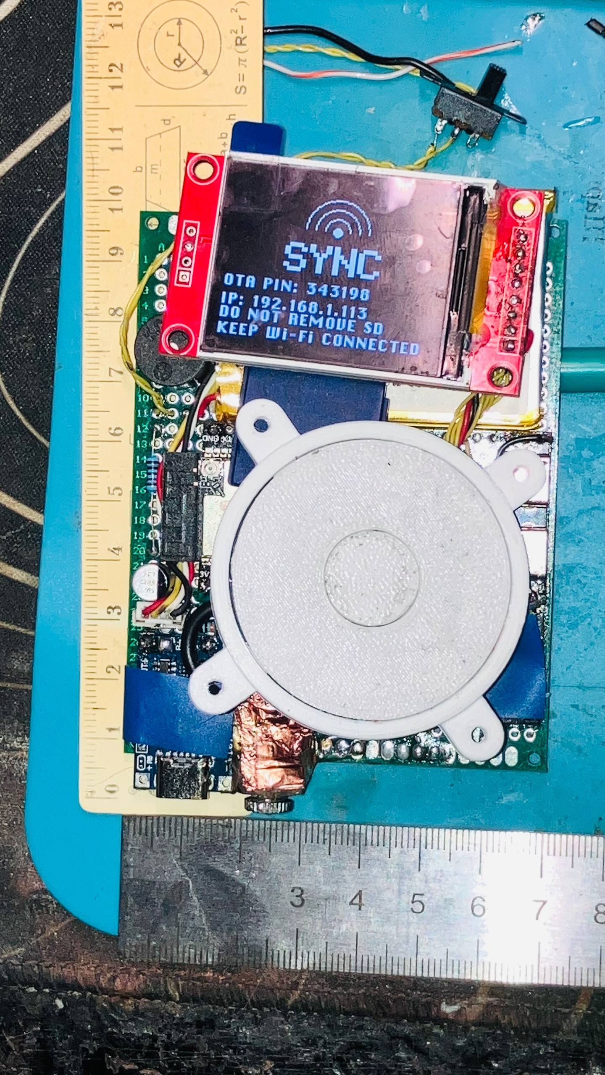
Hardware/MonoPod_Enclosure_v04_USB_Flush_Acrylic_2026-11-02/reference/photos/rigid_electronics_2026-11-01.png
