IlyaBOT/MonoPod/Hardware/TDA1308_HeadphoneAmp/renders/back.png

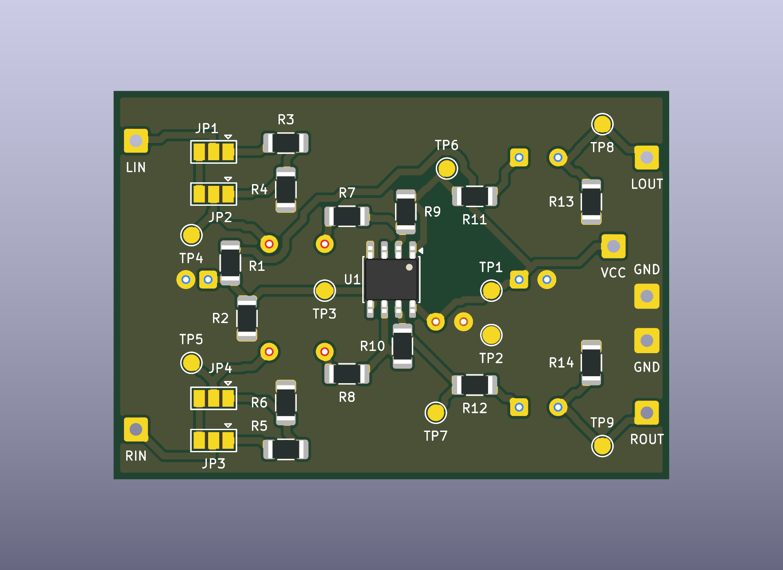
Hardware/TDA1308_HeadphoneAmp/renders/back.png
