IlyaBOT/MonoPod/Hardware/TDA1308_HeadphoneAmp/renders/front.png

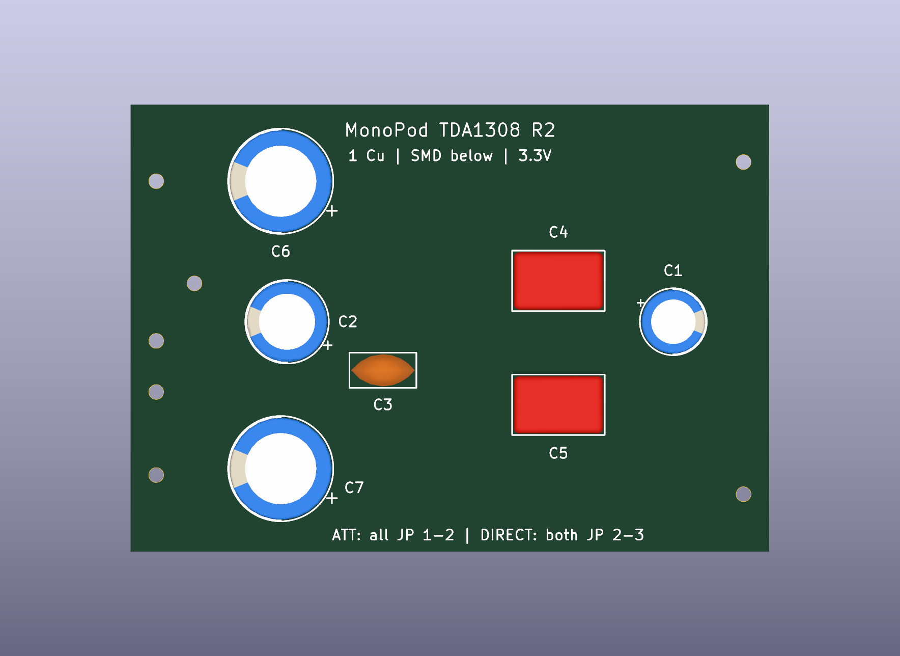
Hardware/TDA1308_HeadphoneAmp/renders/front.png
