IlyaBOT/MonoPod/MonoPod_Desktop/docs/theme-fixtures/menu.png

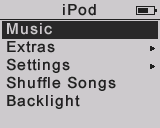
MonoPod_Desktop/docs/theme-fixtures/menu.png
