IlyaBOT/MonoPod/MonoPod_Desktop/docs/ui-smoke/1.5/main.png

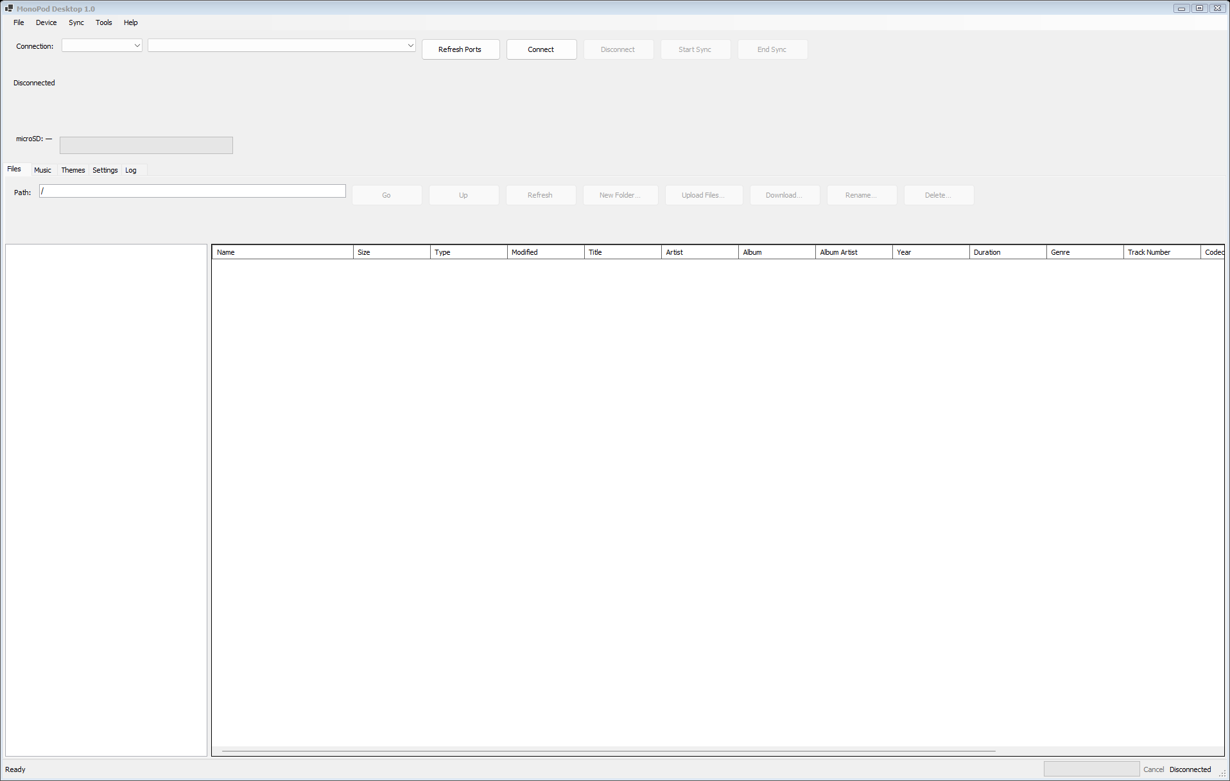
MonoPod_Desktop/docs/ui-smoke/1.5/main.png
