IlyaBOT/MonoPod/MonoPod_Desktop/docs/ui-smoke/1.5/tab-1.png

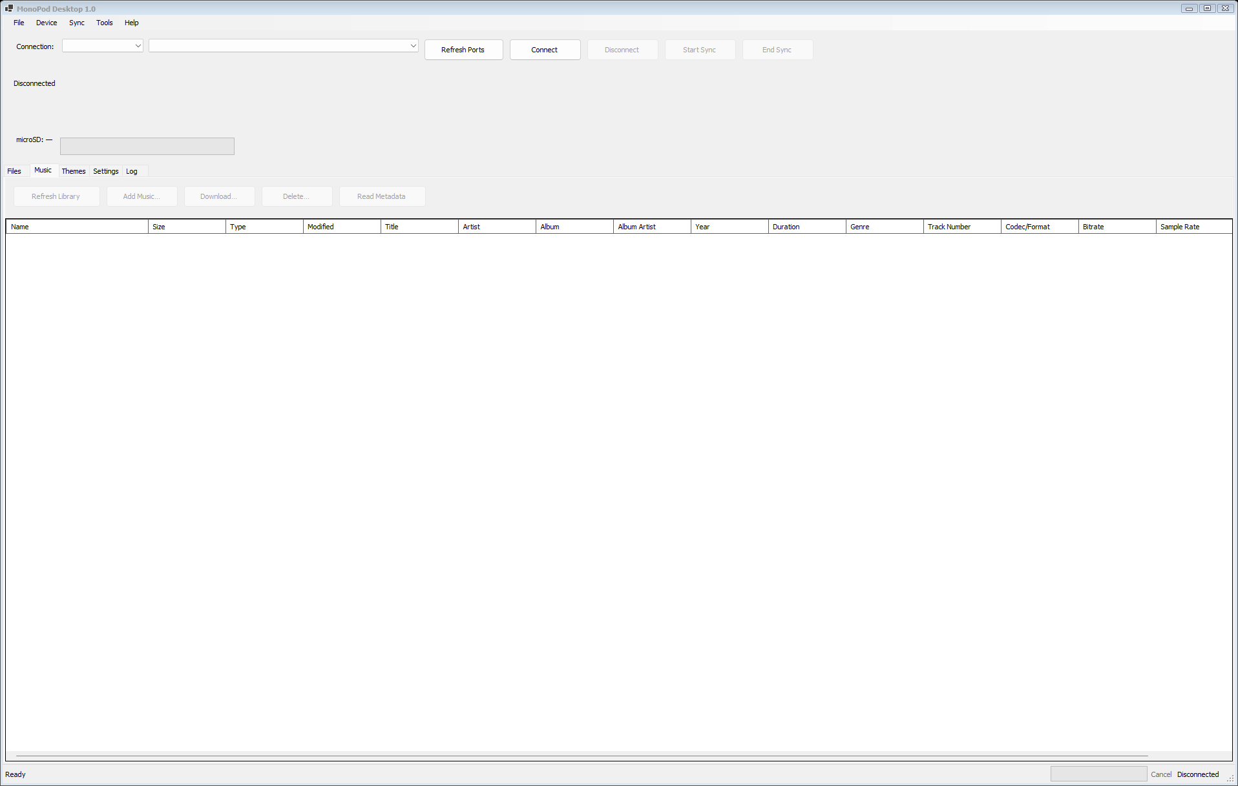
MonoPod_Desktop/docs/ui-smoke/1.5/tab-1.png
