IlyaBOT/MonoPod/MonoPod_Desktop/docs/ui-smoke/1.25/tab-2.png

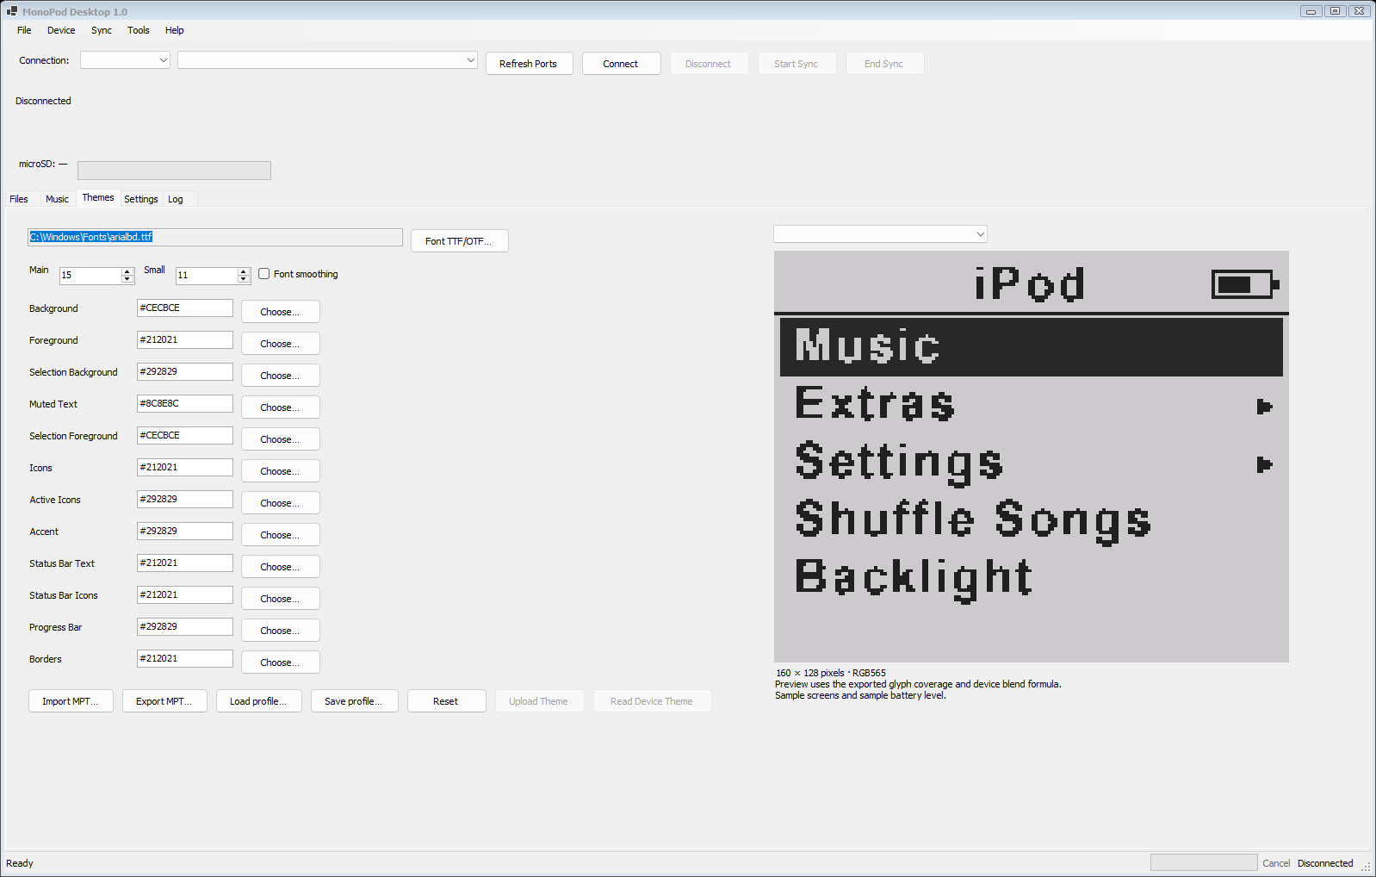
MonoPod_Desktop/docs/ui-smoke/1.25/tab-2.png
