IlyaBOT/MonoPod/MonoPod_Desktop/docs/ui-smoke/1/main.png

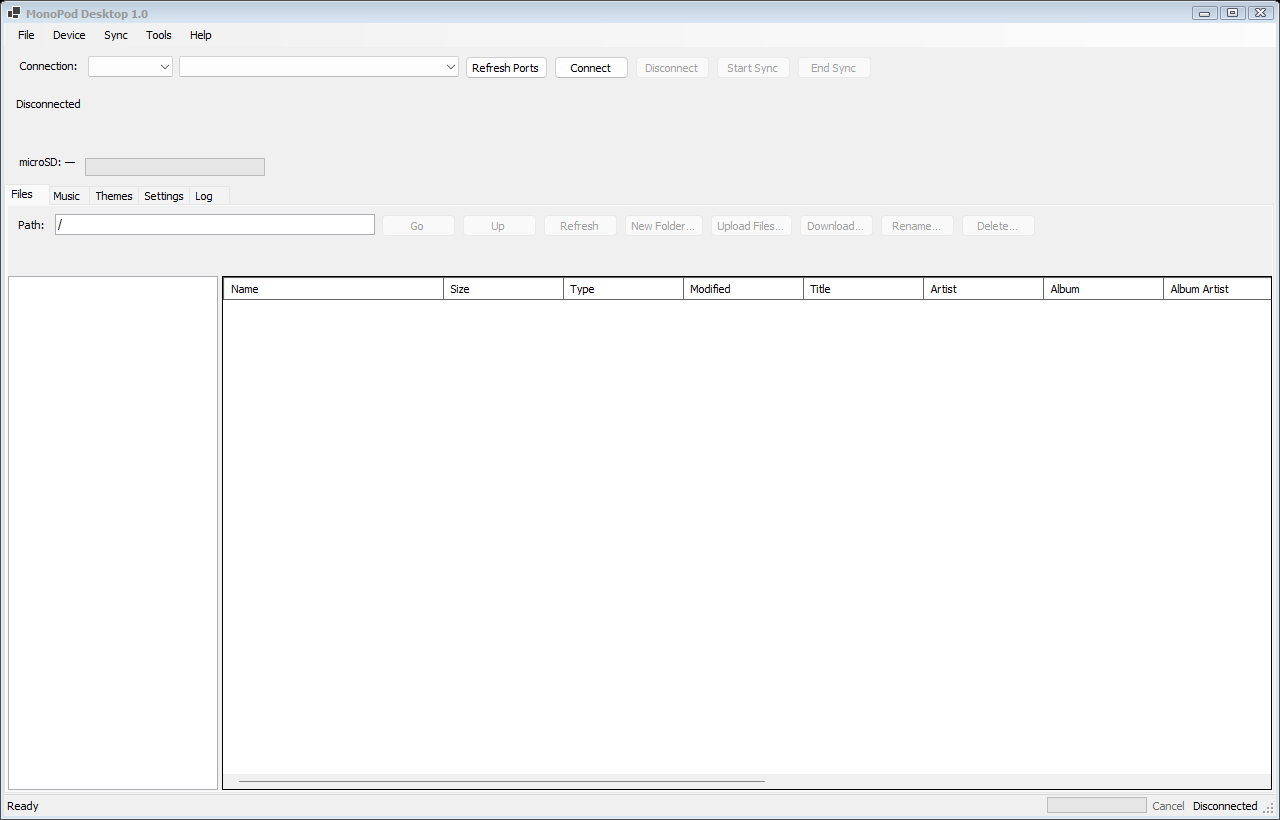
MonoPod_Desktop/docs/ui-smoke/1/main.png
