IlyaBOT/MonoPod/Hardware/TDA1308_HeadphoneAmp/assembly_coordinates.csv

Ref | Value | X_mm_top_view | Y_mm_top_view | KiCad_rotation_deg | Mounting_side
J6 | LOUT | 2.0 | 6.0 | 0.0 | TOP
J1 | VCC | 5.0 | 14.0 | 0.0 | TOP
J4 | RIN | 48.0 | 30.5 | 0.0 | TOP
J5 | GND | 2.0 | 22.5 | 0.0 | TOP
C6 | 220u / >=10V | 13.5 | 6.0 | 180.0 | TOP
J7 | ROUT | 2.0 | 29.0 | 0.0 | TOP
C4 | 4.7u / >=25V X7R | 36.0 | 13.8 | 180.0 | TOP
C1 | 22u / >=10V | 41.5 | 17.0 | 0.0 | TOP
C5 | 4.7u / >=25V X7R | 36.0 | 23.5 | 180.0 | TOP
C7 | 220u / >=10V | 13.5 | 28.5 | 180.0 | TOP
J3 | LIN | 48.0 | 4.5 | 0.0 | TOP
C3 | 100n / >=25V X7R | 21.0 | 20.8 | 180.0 | TOP
C2 | 100u / >=10V | 13.5 | 17.0 | 180.0 | TOP
J2 | GND | 2.0 | 18.5 | 0.0 | TOP
R4 | 3.3k | 34.5 | 8.9 | -90.0 | BOTTOM
TP8 | HP_L | 6.0 | 3.0 | 180.0 | BOTTOM
R8 | 3.9k | 29.0 | 25.5 | 180.0 | BOTTOM
R6 | 3.3k | 34.5 | 28.1 | 90.0 | BOTTOM
TP1 | VDD | 16.0 | 18.0 | 180.0 | BOTTOM
TP7 | OUTB_RAW | 21.0 | 29.0 | 180.0 | BOTTOM
TP2 | GND | 16.0 | 22.0 | 180.0 | BOTTOM
JP2 | L_OUTPUT_SEL | 41.0 | 9.3 | 0.0 | BOTTOM
R5 | 10k | 34.5 | 32.299999 | 180.0 | BOTTOM
JP1 | L_INPUT_SEL | 41.0 | 5.5 | 0.0 | BOTTOM
U1 | TDA1308T | 25.0 | 17.0 | -90.0 | BOTTOM
R2 | 10k | 38.0 | 20.5 | -90.0 | BOTTOM
TP5 | INB | 43.0 | 24.5 | 180.0 | BOTTOM
TP9 | HP_R | 6.0 | 32.0 | 180.0 | BOTTOM
TP4 | INA | 43.0 | 13.0 | 180.0 | BOTTOM
TP3 | VREF | 31.0 | 18.0 | 180.0 | BOTTOM
R13 | 100k | 7.0 | 10.0 | -90.0 | BOTTOM
JP4 | R_OUTPUT_SEL | 41.0 | 27.7 | 0.0 | BOTTOM
JP3 | R_INPUT_SEL | 41.0 | 31.5 | 0.0 | BOTTOM
R14 | 100k | 7.0 | 24.5 | 90.0 | BOTTOM
TP6 | OUTA_RAW | 20.0 | 7.0 | 180.0 | BOTTOM
R7 | 3.9k | 29.0 | 11.3 | 180.0 | BOTTOM
R12 | 2.2R | 17.5 | 26.5 | 180.0 | BOTTOM
R10 | 3.9k | 24.0 | 23.0 | -90.0 | BOTTOM
R1 | 10k | 39.5 | 15.5 | -90.0 | BOTTOM
R3 | 10k | 34.5 | 4.7 | 180.0 | BOTTOM
R9 | 3.9k | 23.7 | 10.9 | -90.0 | BOTTOM
R11 | 2.2R | 17.5 | 9.5 | 180.0 | BOTTOM
