IlyaBOT/MonoPod/Hardware/TDA1308_HeadphoneAmp/revisions/R1_snapshot/assembly_coordinates.csv

Ref | Value | X_mm | Y_mm | Rotation_deg | Side | DNP
U1 | TDA1308T | 25 | 16 | 0 | TOP | False
R1 | 10k | 17.8 | 8.0 | 0 | TOP | False
R2 | 10k | 17.8 | 10.5 | 0 | TOP | False
R3 | 10k | 9.2 | 10.5 | 0 | TOP | False
R4 | 3.3k | 12.7 | 10.5 | 90 | TOP | False
R5 | 10k | 9.2 | 19 | 0 | TOP | False
R6 | 3.3k | 12.7 | 19 | 90 | TOP | False
R7 | 3.9k | 17.3 | 18 | 0 | TOP | False
R8 | 3.9k | 29.5 | 20.2 | 90 | TOP | False
R9 | 3.9k | 19.9 | 14.7 | -90 | TOP | False
R10 | 3.9k | 30 | 16 | -90 | TOP | False
R11 | 2.2R | 21 | 10.5 | 90 | TOP | False
R12 | 2.2R | 37.5 | 11.1 | 90 | TOP | False
R13 | 100k | 38.5 | 15 | 0 | TOP | False
R14 | 100k | 38.5 | 19 | 0 | TOP | False
R15 | 0R | 5.5 | 10.5 | 0 | TOP | False
R16 | 0R | 9.2 | 13 | 0 | TOP | False
R17 | 0R | 5.5 | 19 | 0 | TOP | False
R18 | 0R | 9.2 | 21.5 | 0 | TOP | False
R19 | 0R | 5.5 | 13 | 0 | TOP | True
R20 | 0R | 5.5 | 21.5 | 0 | TOP | True
C1 | 22u / >=10V | 13.5 | 4.5 | 0 | TOP | False
C2 | 100u / >=10V | 6 | 4.8 | 0 | TOP | False
C3 | 100n / 25V X7R | 30.6 | 12.5 | 0 | TOP | False
C4 | 4.7u / 25V X7R | 13.6 | 15.6 | 0 | TOP | False
C5 | 4.7u / 25V X7R | 23.5 | 21 | 0 | TOP | False
C6 | 220u / >=10V | 22.25 | 5 | 0 | TOP | False
C7 | 220u / >=10V | 31.25 | 5 | 0 | TOP | False
J1 | VCC | 1.8 | 4 | 0 | TOP | False
J2 | GND | 1.8 | 9 | 0 | TOP | False
J3 | LIN | 1.8 | 14 | 0 | TOP | False
J4 | RIN | 1.8 | 19 | 0 | TOP | False
J5 | GND | 43 | 11.5 | 0 | TOP | False
J6 | LOUT | 43 | 15.5 | 0 | TOP | False
J7 | ROUT | 43 | 20.5 | 0 | TOP | False
TP1 | VDD | 18.2 | 1.6 | 0 | TOP | False
TP2 | GND | 1.8 | 23 | 0 | TOP | False
TP3 | VREF | 15.5 | 21.8 | 0 | TOP | False
TP4 | INA | 15.8 | 13 | 0 | TOP | False
TP5 | INB | 19 | 23.5 | 0 | TOP | False
TP6 | OUTA_RAW | 19.3 | 20.6 | 0 | TOP | False
TP7 | OUTB_RAW | 33 | 16 | 0 | TOP | False
TP8 | HP_L | 34 | 12 | 0 | TOP | False
TP9 | HP_R | 35 | 21.5 | 0 | TOP | False
