IlyaBOT/MonoPod/Hardware/MonoPod_Enclosure_v04_USB_Flush_Acrylic_2026-11-02/reference/clickwheel/cad/assembly.step

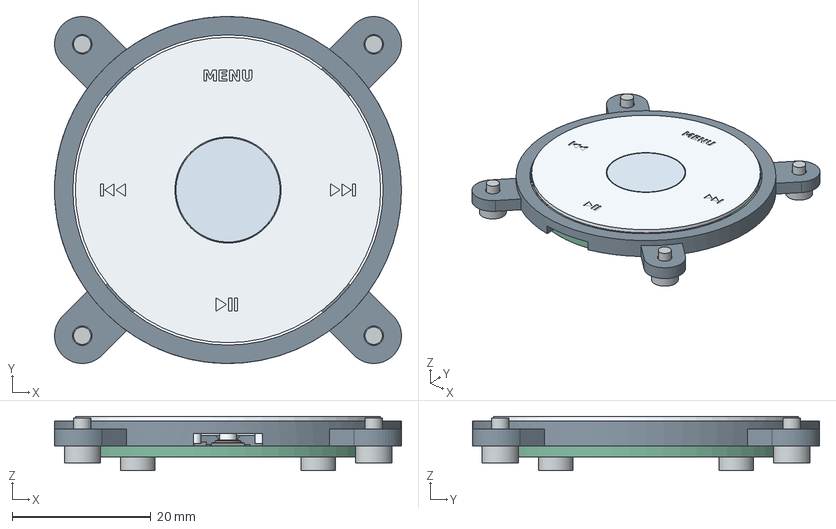
[picture p31: CAD file, 2026-11-14]
Hardware/MonoPod_Enclosure_v04_USB_Flush_Acrylic_2026-11-02/reference/clickwheel/cad/assembly.step
50.0 x 50.0 x 7.85 mm
wheel
select
frame
board
foil
SW1_fixed
SW2_fixed
SW3_fixed
SW4_fixed
SW5_fixed
R3
R1
R5
R2
R4
C1
R6
SW1_actuator
SW2_actuator
SW3_actuator
SW4_actuator
SW5_actuator
M2x5_1
M2x5_2
M2x5_3
M2x5_4
M2p5x4_1
M2p5x4_2
M2p5x4_3
M2p5x4_4
