IlyaBOT/MonoPod/Hardware/MonoPod_Enclosure_v04_USB_Flush_Acrylic_2026-11-02/reference/envelopes/mainboard_rear_solder_keepout.step

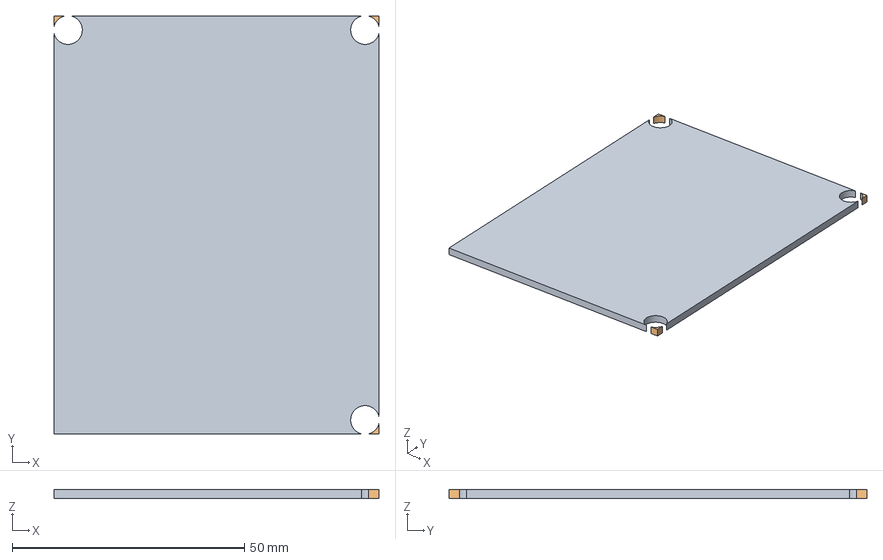
[picture p33: CAD file, 2026-11-14]
Hardware/MonoPod_Enclosure_v04_USB_Flush_Acrylic_2026-11-02/reference/envelopes/mainboard_rear_solder_keepout.step
70.0 x 90.0 x 2.00 mm
