IlyaBOT/MonoPod/Hardware/MonoPod_Enclosure_v04_USB_Flush_Acrylic_2026-11-02/cad/acrylic_carrier_subassembly.step

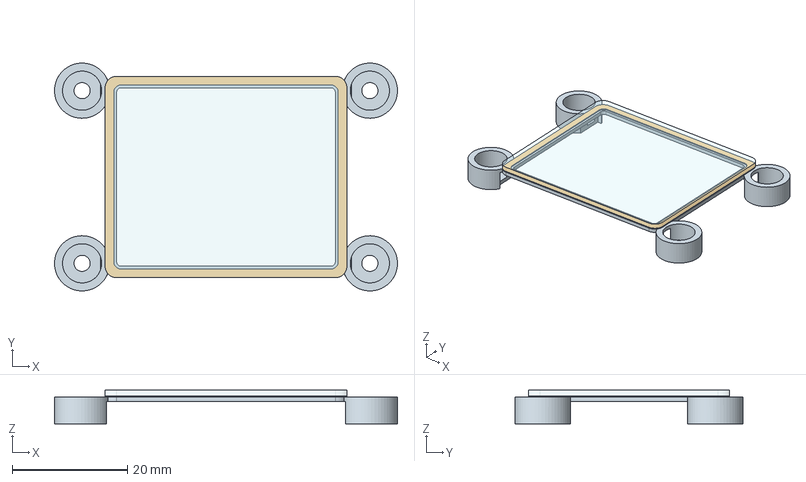
[picture p35: CAD file, 2026-11-14]
Hardware/MonoPod_Enclosure_v04_USB_Flush_Acrylic_2026-11-02/cad/acrylic_carrier_subassembly.step
59.6 x 39.6 x 5.90 mm
display_lens_carrier
screen_lens
lens_adhesive_envelope
