IlyaBOT/MonoPod/Hardware/MonoPod_Enclosure_v04_USB_Flush_Acrylic_2026-11-02/cad/assembly_mockup.step

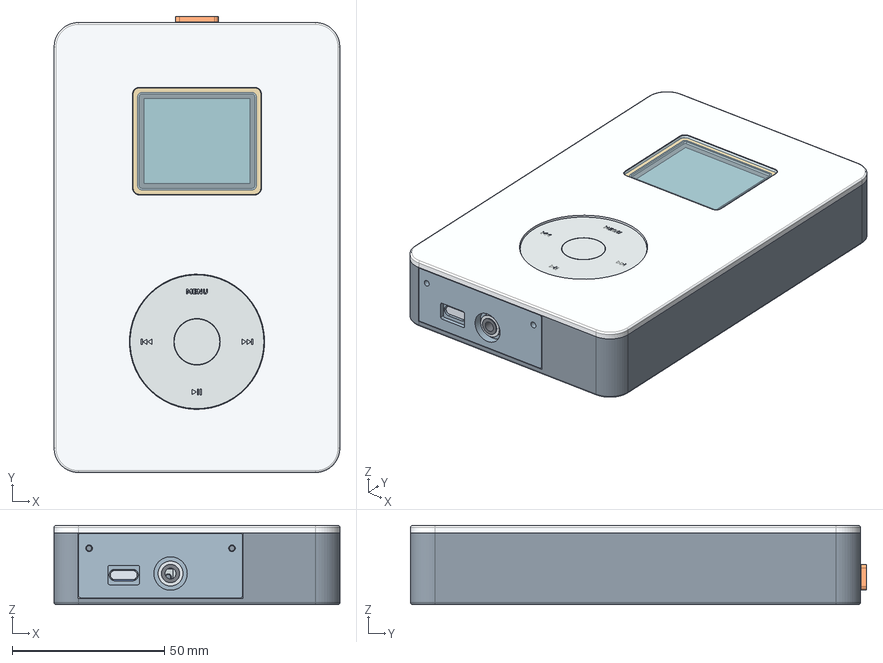
[picture p36: CAD file, 2026-11-14]
Hardware/MonoPod_Enclosure_v04_USB_Flush_Acrylic_2026-11-02/cad/assembly_mockup.step
94.0 x 150.0 x 26.0 mm
front_panel
back_chassis
hold_slider_cap
bottom_connector_insert
display_lens_carrier
clickwheel_original_assembly
mainboard
tp4056_pcb
tp4056_components
usb_c_shell
jack_body
jack_nut
hold_switch_body
hold_lever
display_pcb
display_glass
display_active
screen_lens
lens_adhesive_envelope
