IlyaBOT/MonoPod/Hardware/MonoPod_Enclosure_v04_USB_Flush_Acrylic_2026-11-02/cad/mainboard_hole_template_coupon.step

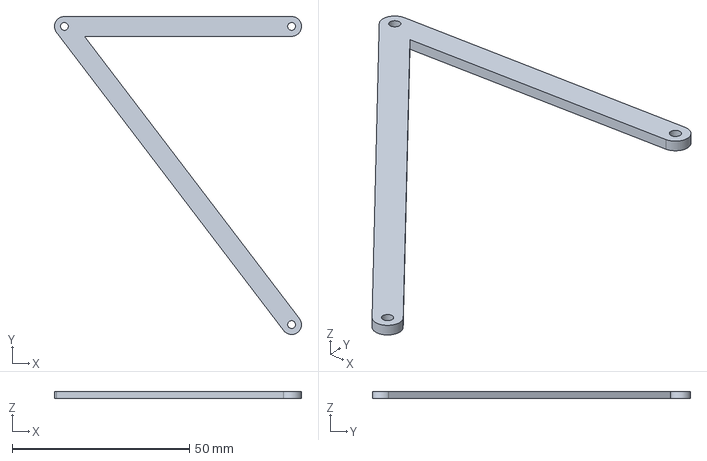
[picture p37: CAD file, 2026-11-14]
Hardware/MonoPod_Enclosure_v04_USB_Flush_Acrylic_2026-11-02/cad/mainboard_hole_template_coupon.step
69.6 x 89.6 x 2.00 mm
