IlyaBOT/MonoPod/Hardware/MonoPod_Enclosure_v04_USB_Flush_Acrylic_2026-11-02/cad/soldered_electronics_assembly.step

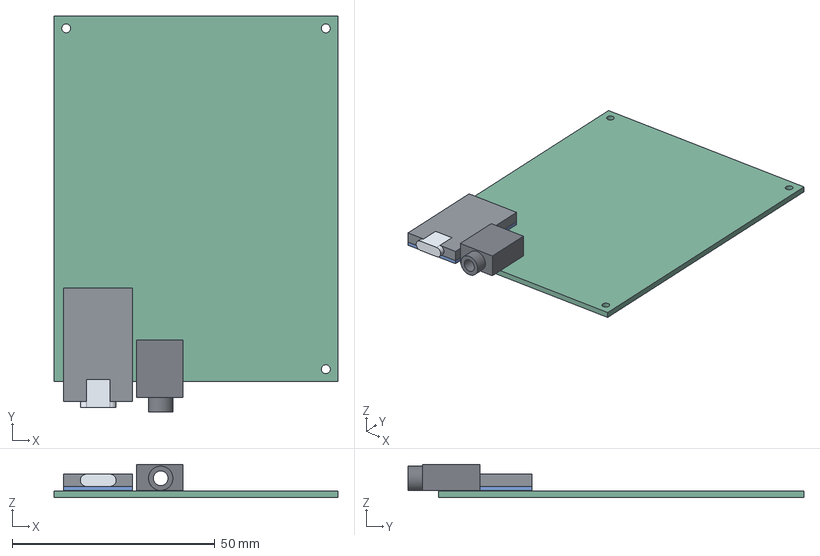
[picture p38: CAD file, 2026-11-14]
Hardware/MonoPod_Enclosure_v04_USB_Flush_Acrylic_2026-11-02/cad/soldered_electronics_assembly.step
70.0 x 97.5 x 8.25 mm
mainboard
tp4056_pcb
tp4056_components
usb_c_shell
jack_body
