IlyaBOT/MonoPod/Hardware/MonoPod_Enclosure_v04_USB_Flush_Acrylic_2026-11-02/cad/front_acrylic_display_assembly.step

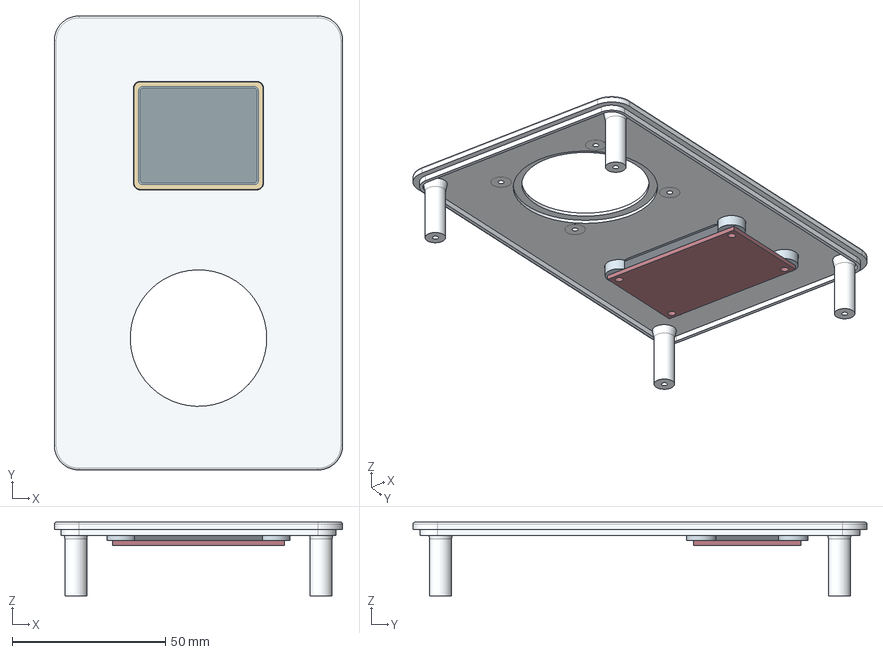
[picture p39: CAD file, 2026-11-14]
Hardware/MonoPod_Enclosure_v04_USB_Flush_Acrylic_2026-11-02/cad/front_acrylic_display_assembly.step
94.0 x 148.0 x 24.0 mm
front_panel
display_lens_carrier
screen_lens
lens_adhesive_envelope
display_pcb
display_glass
