IlyaBOT/MonoPod/Hardware/MonoPod_Enclosure_v04_USB_Flush_Acrylic_2026-11-02/cad/bottom_cable_fit_assembly.step

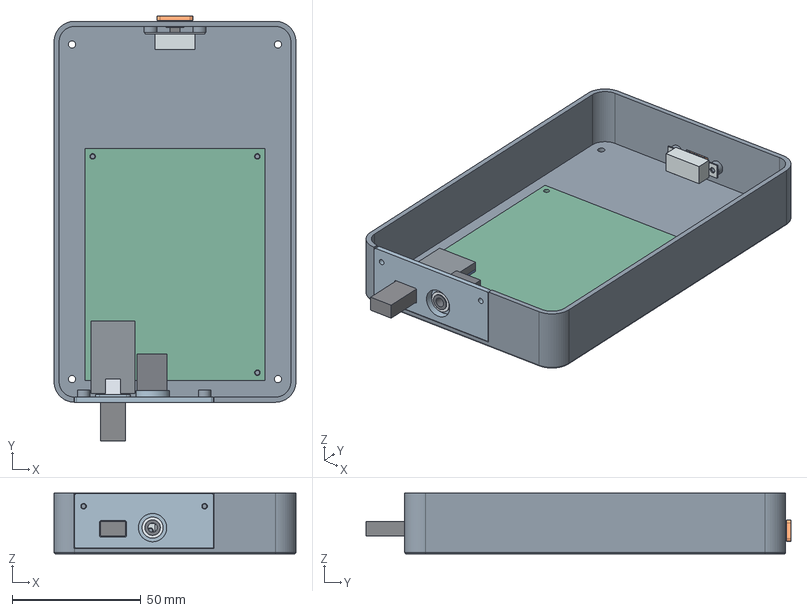
[picture p40: CAD file, 2026-11-14]
Hardware/MonoPod_Enclosure_v04_USB_Flush_Acrylic_2026-11-02/cad/bottom_cable_fit_assembly.step
94.0 x 165.0 x 23.6 mm
back_chassis
hold_slider_cap
bottom_connector_insert
mainboard
tp4056_pcb
tp4056_components
usb_c_shell
jack_body
jack_nut
hold_switch_body
hold_lever
usb_cable_hood
usb_cable_metal
