IlyaBOT/MonoPod/Hardware/MonoPod_Enclosure_v04_USB_Flush_Acrylic_2026-11-02/laser/acrylic_stock_layout_1to1.dxf

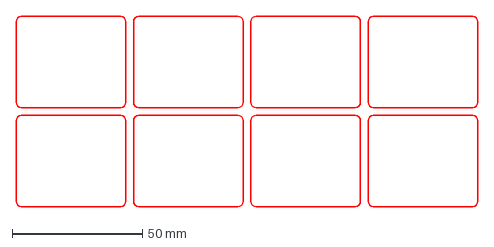
[picture p42: CAD file, 2026-11-14]
Hardware/MonoPod_Enclosure_v04_USB_Flush_Acrylic_2026-11-02/laser/acrylic_stock_layout_1to1.dxf
177.0 x 73.0 mm
