IlyaBOT/MonoPod/Hardware/MonoPod_Enclosure_v04_USB_Flush_Acrylic_2026-11-02/reference/clickwheel/cad/frame.step

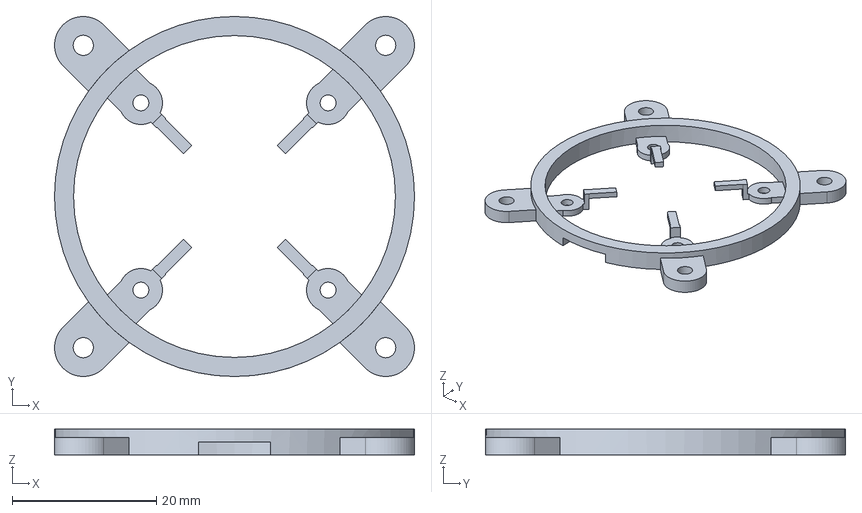
[picture p43: CAD file, 2026-11-14]
Hardware/MonoPod_Enclosure_v04_USB_Flush_Acrylic_2026-11-02/reference/clickwheel/cad/frame.step
50.0 x 50.0 x 3.55 mm
