IlyaBOT/MonoPod/Hardware/MonoPod_Enclosure_v04_USB_Flush_Acrylic_2026-11-02/reference/clickwheel/reference/pcb_with_component_envelopes.step

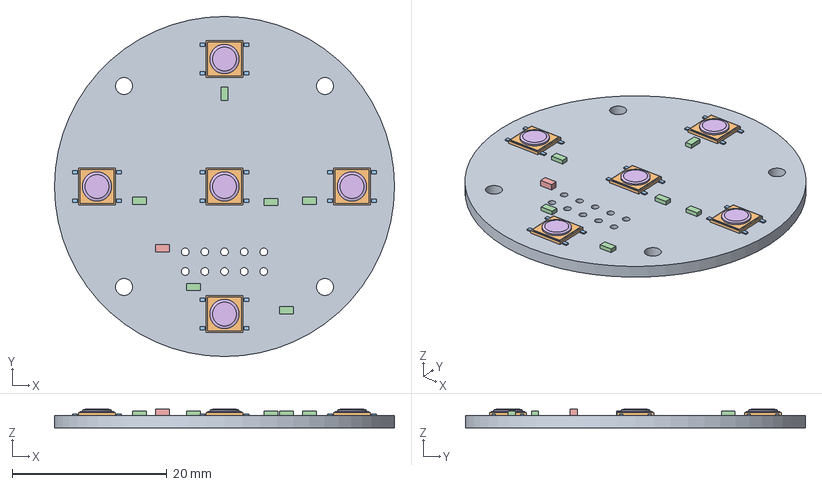
[picture p44: CAD file, 2026-11-14]
Hardware/MonoPod_Enclosure_v04_USB_Flush_Acrylic_2026-11-02/reference/clickwheel/reference/pcb_with_component_envelopes.step
44.0 x 44.0 x 2.40 mm
FR4
SW1_fixed
SW2_fixed
SW3_fixed
SW4_fixed
SW5_fixed
R3
R1
R5
R2
R4
C1
R6
SW1_actuator
SW2_actuator
SW3_actuator
SW4_actuator
SW5_actuator
