IlyaBOT/MonoPod/Hardware/MonoPod_Enclosure_v04_USB_Flush_Acrylic_2026-11-02/reference/envelopes/display_pcb.step

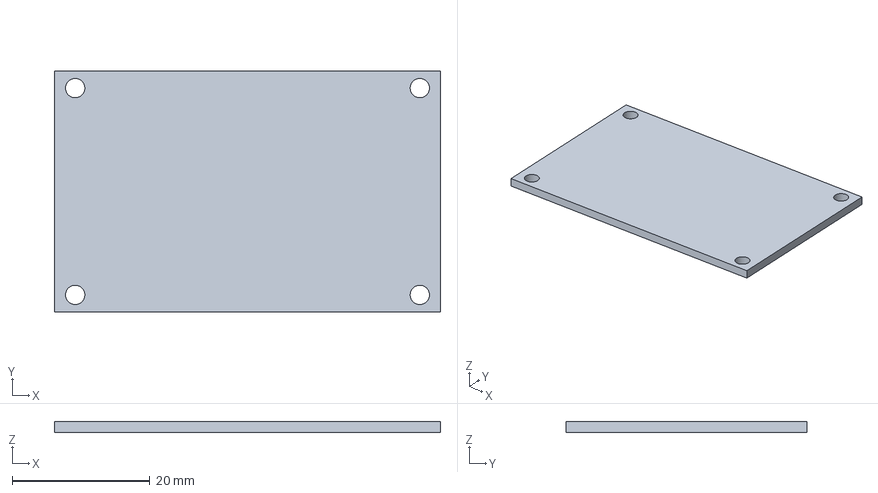
[picture p45: CAD file, 2026-11-14]
Hardware/MonoPod_Enclosure_v04_USB_Flush_Acrylic_2026-11-02/reference/envelopes/display_pcb.step
56.0 x 35.0 x 1.60 mm
