IlyaBOT/MonoPod/Hardware/MonoPod_Enclosure_v04_USB_Flush_Acrylic_2026-11-02/laser/acrylic_screen_lens_1to1.dxf

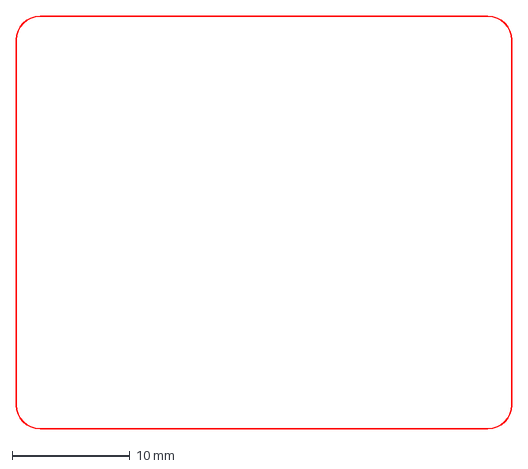
[picture p48: CAD file, 2026-11-14]
Hardware/MonoPod_Enclosure_v04_USB_Flush_Acrylic_2026-11-02/laser/acrylic_screen_lens_1to1.dxf
42.0 x 35.0 mm
