IlyaBOT/MonoPod/Hardware/MonoPod_Enclosure_v04_USB_Flush_Acrylic_2026-11-02/reference/clickwheel/cad/select.step

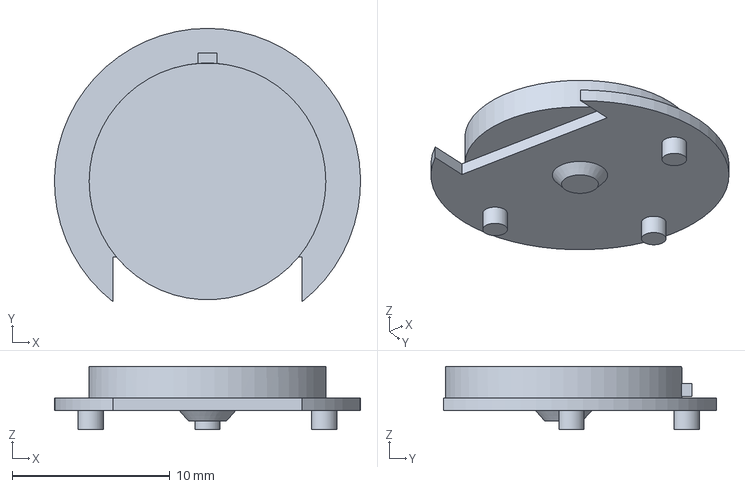
[picture p49: CAD file, 2026-11-14]
Hardware/MonoPod_Enclosure_v04_USB_Flush_Acrylic_2026-11-02/reference/clickwheel/cad/select.step
19.4 x 17.3 x 4.02 mm
