IlyaBOT/MonoPod/Hardware/MonoPod_Enclosure_v04_USB_Flush_Acrylic_2026-11-02/reference/envelopes/usb_cable_metal.step

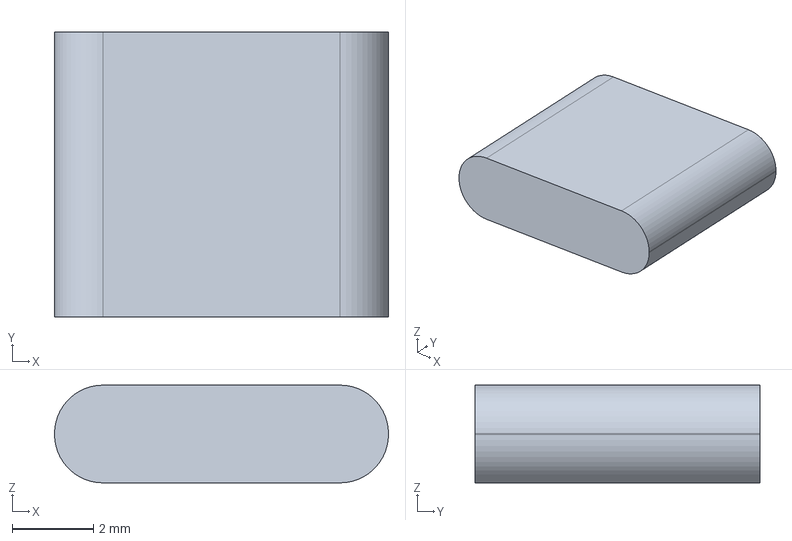
[picture p50: CAD file, 2026-11-14]
Hardware/MonoPod_Enclosure_v04_USB_Flush_Acrylic_2026-11-02/reference/envelopes/usb_cable_metal.step
8.20 x 7.00 x 2.40 mm
