IlyaBOT/MonoPod/Hardware/MonoPod_Enclosure_v04_USB_Flush_Acrylic_2026-11-02/cad/usb_cable_well_gap_0p50.step

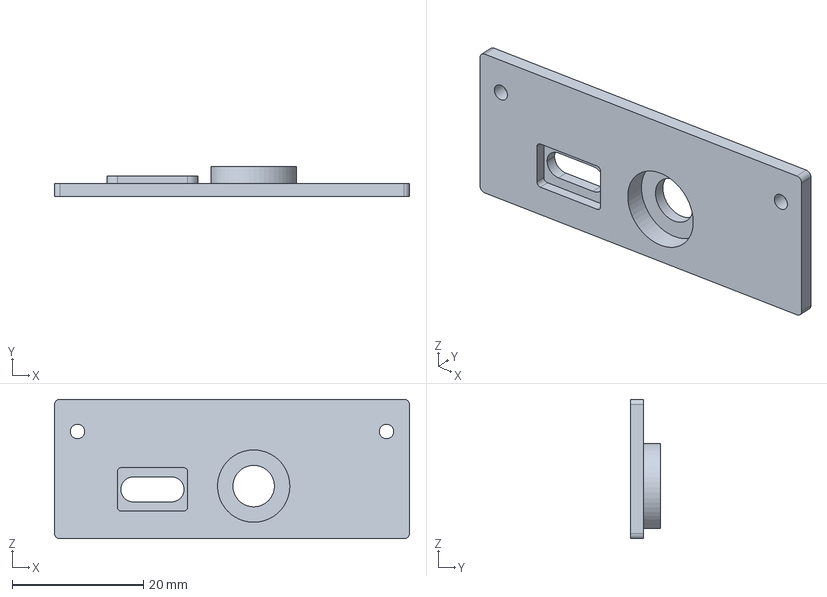
[picture p54: CAD file, 2026-11-14]
Hardware/MonoPod_Enclosure_v04_USB_Flush_Acrylic_2026-11-02/cad/usb_cable_well_gap_0p50.step
54.0 x 4.55 x 21.2 mm
