IlyaBOT/MonoPod/Hardware/MonoPod_Enclosure_v04_USB_Flush_Acrylic_2026-11-02/cad/front_panel_rear_lip_alternative.step

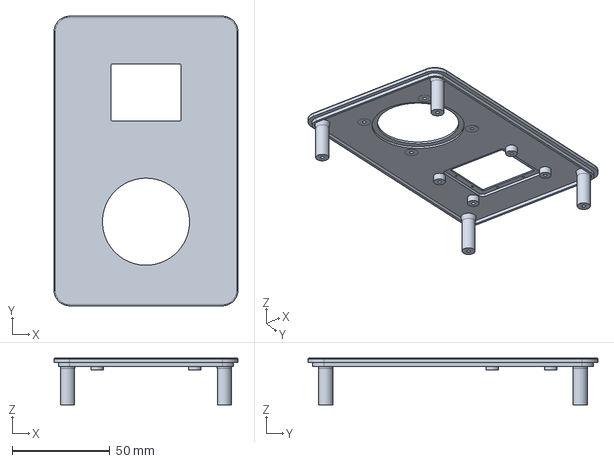
[picture p57: CAD file, 2026-11-14]
Hardware/MonoPod_Enclosure_v04_USB_Flush_Acrylic_2026-11-02/cad/front_panel_rear_lip_alternative.step
94.0 x 148.0 x 24.0 mm
