IlyaBOT/MonoPod/Hardware/MonoPod_Enclosure_v04_USB_Flush_Acrylic_2026-11-02/cad/clickwheel_window_gap_0p20.step

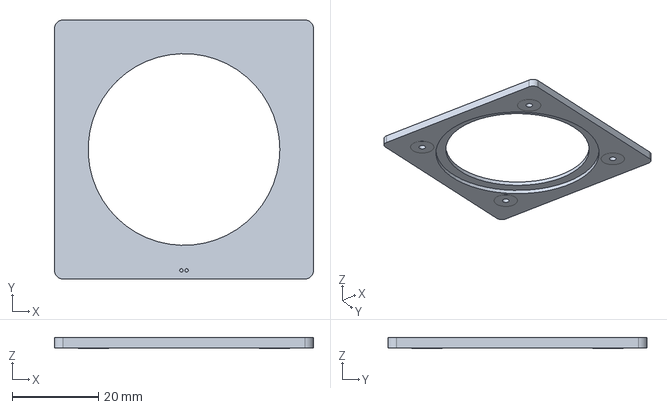
[picture p59: CAD file, 2026-11-14]
Hardware/MonoPod_Enclosure_v04_USB_Flush_Acrylic_2026-11-02/cad/clickwheel_window_gap_0p20.step
60.0 x 60.0 x 2.45 mm
