IlyaBOT/MonoPod/Hardware/MonoPod_Enclosure_v04_USB_Flush_Acrylic_2026-11-02/cad/closure_front_boss_coupon.step

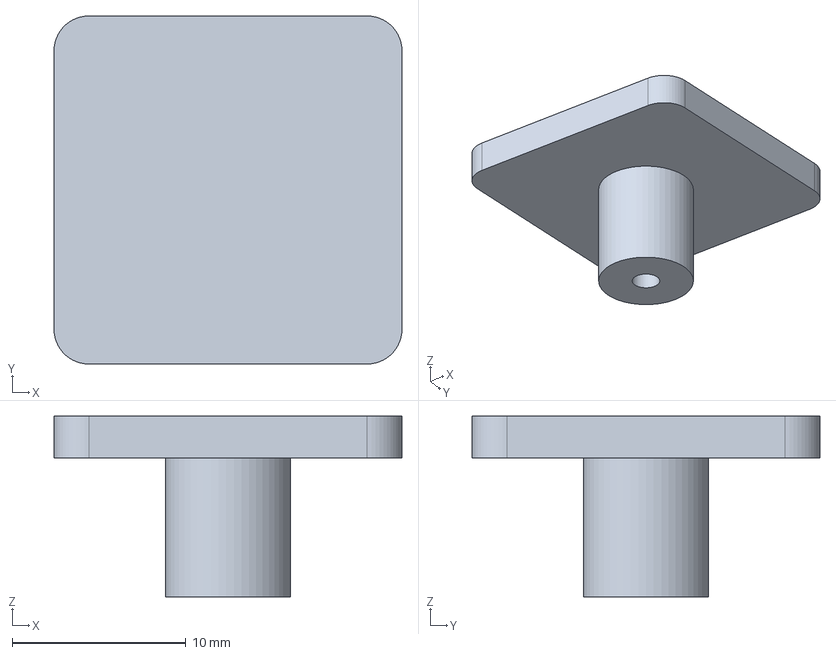
[picture p62: CAD file, 2026-11-14]
Hardware/MonoPod_Enclosure_v04_USB_Flush_Acrylic_2026-11-02/cad/closure_front_boss_coupon.step
20.0 x 20.0 x 10.4 mm
