IlyaBOT/MonoPod/Hardware/MonoPod_Enclosure_v04_USB_Flush_Acrylic_2026-11-02/cad/hold_window_gap_0p25.step

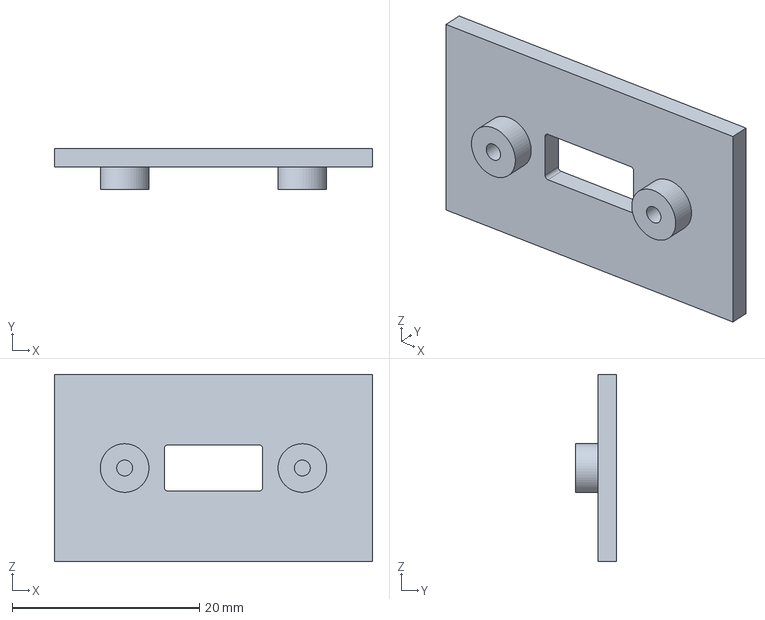
[picture p64: CAD file, 2026-11-14]
Hardware/MonoPod_Enclosure_v04_USB_Flush_Acrylic_2026-11-02/cad/hold_window_gap_0p25.step
34.0 x 4.40 x 20.0 mm
