IlyaBOT/MonoPod/Hardware/MonoPod_Enclosure_v04_USB_Flush_Acrylic_2026-11-02/cad/jack_hole_diameter_coupon.step

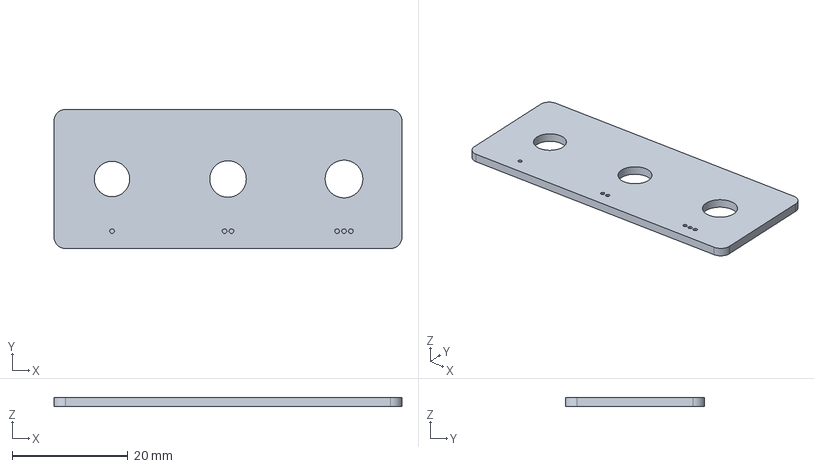
[picture p66: CAD file, 2026-11-14]
Hardware/MonoPod_Enclosure_v04_USB_Flush_Acrylic_2026-11-02/cad/jack_hole_diameter_coupon.step
60.0 x 24.0 x 1.60 mm
