IlyaBOT/MonoPod/Hardware/MonoPod_Enclosure_v04_USB_Flush_Acrylic_2026-11-02/cad/jack_panel_thickness_1p60.step

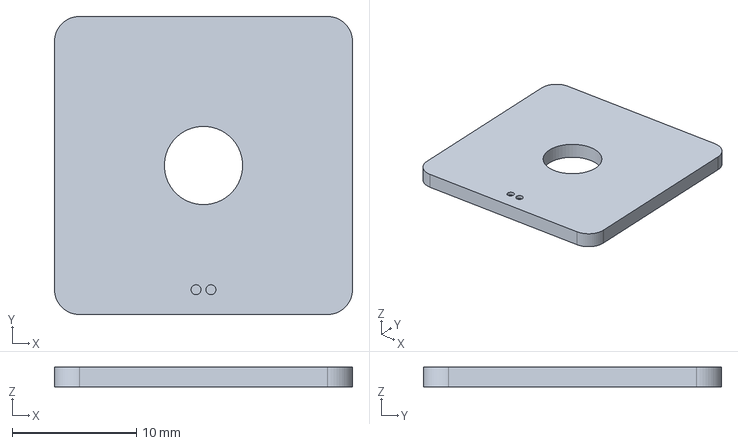
[picture p69: CAD file, 2026-11-14]
Hardware/MonoPod_Enclosure_v04_USB_Flush_Acrylic_2026-11-02/cad/jack_panel_thickness_1p60.step
24.0 x 24.0 x 1.60 mm
