IlyaBOT/MonoPod/Hardware/MonoPod_Enclosure_v04_USB_Flush_Acrylic_2026-11-02/cad/coupons_identification_sheet.step

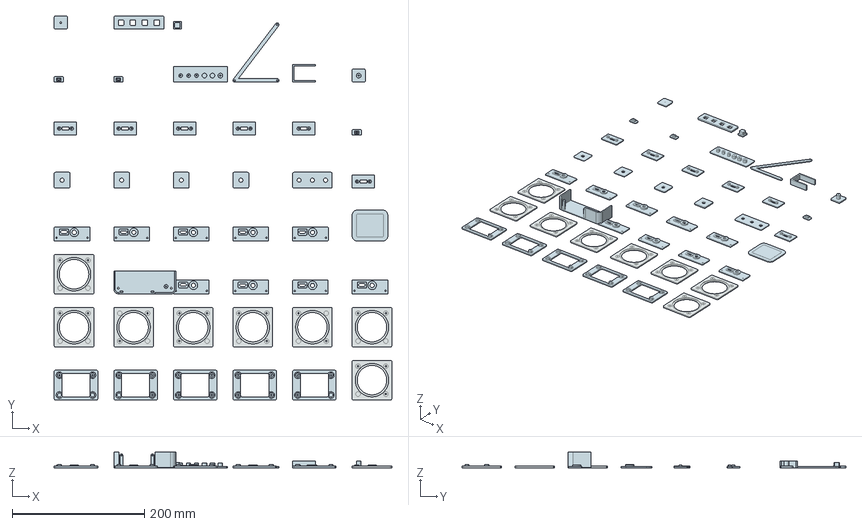
[picture p70: CAD file, 2026-11-14]
Hardware/MonoPod_Enclosure_v04_USB_Flush_Acrylic_2026-11-02/cad/coupons_identification_sheet.step
510.0 x 580.0 x 23.6 mm
display_window_coupon
acrylic_seat_coupon
acrylic_seat_gap_0p15
acrylic_seat_gap_0p25
acrylic_seat_gap_0p30
clickwheel_mount_coupon
clickwheel_depth_extra_0p00
clickwheel_depth_extra_0p10
clickwheel_depth_extra_0p20
clickwheel_window_gap_0p15
clickwheel_window_gap_0p20
clickwheel_window_gap_0p25
clickwheel_window_gap_0p30
bottom_edge_coupon
bottom_insert_gap_0p15
bottom_insert_gap_0p25
bottom_insert_gap_0p30
bottom_aperture_extra_0p20
bottom_aperture_extra_0p40
bottom_insert_recess_1p50
bottom_insert_recess_2p50
usb_cable_well_gap_0p30
usb_cable_well_gap_0p50
lens_gluing_jig
jack_panel_thickness_1p20
jack_panel_thickness_1p60
jack_panel_thickness_2p00
jack_panel_thickness_2p40
jack_hole_diameter_coupon
hold_switch_coupon
hold_window_gap_0p15
hold_window_gap_0p20
hold_window_gap_0p25
hold_window_gap_0p30
hold_mount_pitch_15p00
hold_cap_lever_gap_m0p05
hold_cap_lever_gap_0p10
hold_cap_lever_gap_0p20
screw_boss_coupon
mainboard_hole_template_coupon
stack_height_gauge
closure_front_boss_coupon
closure_rear_plate_coupon
tolerance_frame_coupon
tolerance_key
