IlyaBOT/MonoPod/Hardware/MonoPod_Enclosure_v04_USB_Flush_Acrylic_2026-11-02/cad/bottom_edge_coupon.step

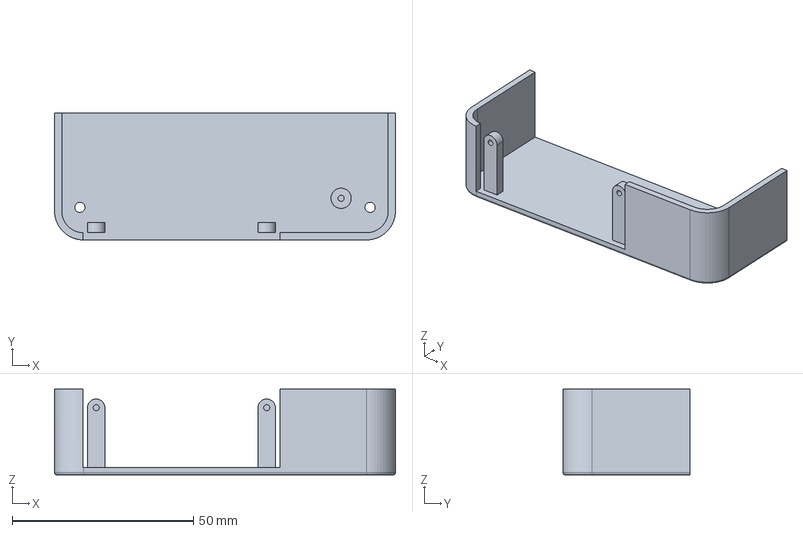
[picture p73: CAD file, 2026-11-14]
Hardware/MonoPod_Enclosure_v04_USB_Flush_Acrylic_2026-11-02/cad/bottom_edge_coupon.step
94.0 x 35.0 x 23.6 mm
