IlyaBOT/MonoPod/Hardware/MonoPod_Enclosure_v04_USB_Flush_Acrylic_2026-11-02/cad/bottom_insert_gap_0p15.step

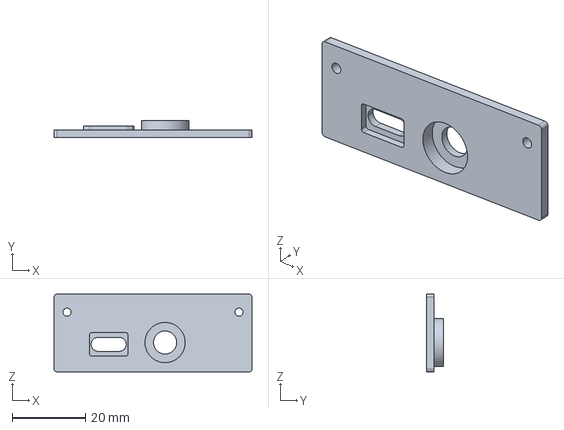
[picture p80: CAD file, 2026-11-14]
Hardware/MonoPod_Enclosure_v04_USB_Flush_Acrylic_2026-11-02/cad/bottom_insert_gap_0p15.step
54.1 x 4.55 x 21.3 mm
