IlyaBOT/MonoPod/Hardware/MonoPod_Enclosure_v04_USB_Flush_Acrylic_2026-11-02/cad/jack_panel_thickness_2p00.step

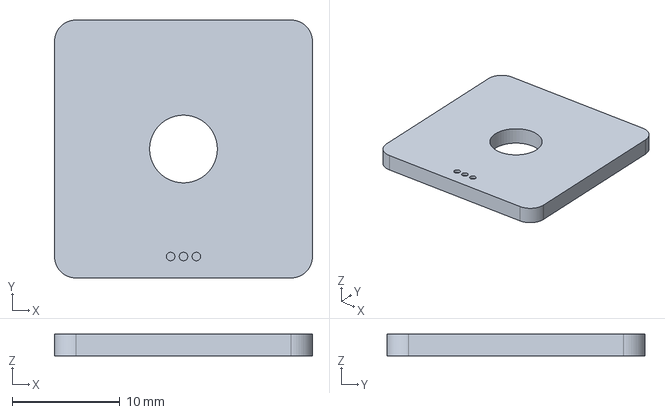
[picture p81: CAD file, 2026-11-14]
Hardware/MonoPod_Enclosure_v04_USB_Flush_Acrylic_2026-11-02/cad/jack_panel_thickness_2p00.step
24.0 x 24.0 x 2.00 mm
