IlyaBOT/MonoPod/Hardware/MonoPod_Enclosure_v04_USB_Flush_Acrylic_2026-11-02/reference/envelopes/module_envelopes.step

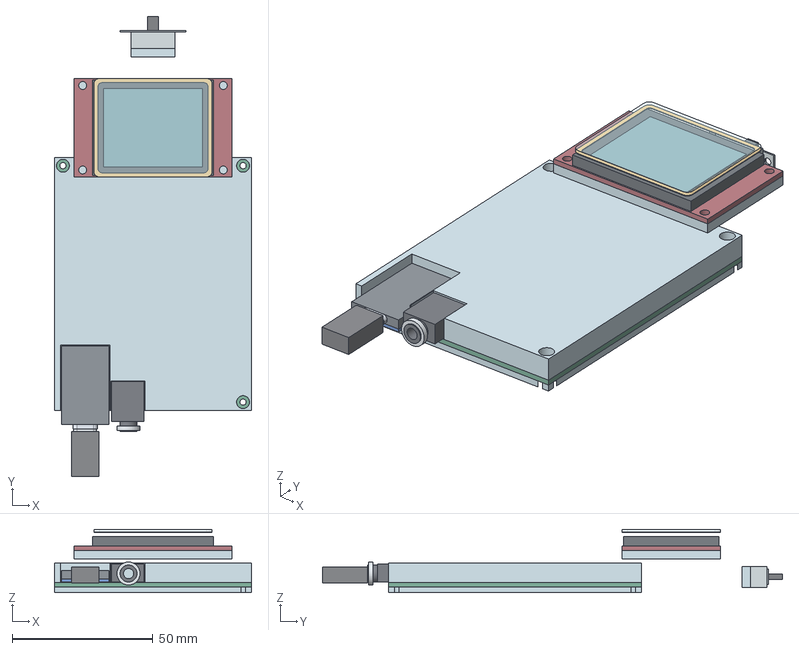
[picture p83: CAD file, 2026-11-14]
Hardware/MonoPod_Enclosure_v04_USB_Flush_Acrylic_2026-11-02/reference/envelopes/module_envelopes.step
70.0 x 163.6 x 22.5 mm
display_pcb
display_glass
display_active
display_rear_keepout
screen_lens
lens_adhesive_envelope
mainboard
tp4056_pcb
tp4056_components
usb_c_shell
jack_body
jack_nut
mainboard_component_keepout
mainboard_rear_solder_keepout
usb_cable_hood
usb_cable_metal
hold_switch_body
hold_lever
hold_terminal_keepout
