IlyaBOT/MonoPod/Hardware/MonoPod_Enclosure_v04_USB_Flush_Acrylic_2026-11-02/cad/tolerance_frame_coupon.step

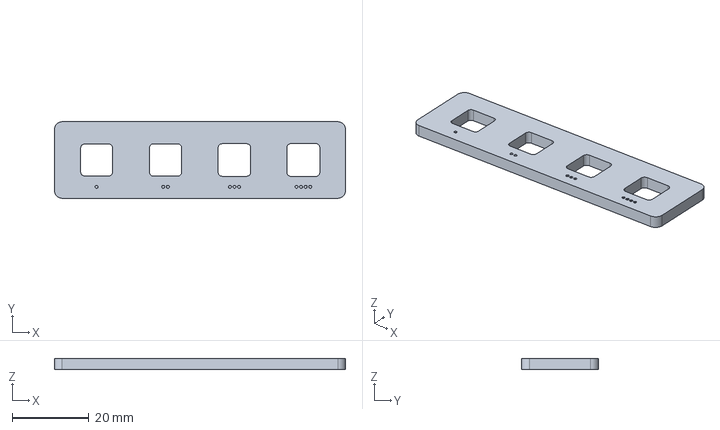
[picture p84: CAD file, 2026-11-14]
Hardware/MonoPod_Enclosure_v04_USB_Flush_Acrylic_2026-11-02/cad/tolerance_frame_coupon.step
76.0 x 20.0 x 3.00 mm
