IlyaBOT/MonoPod/Hardware/MonoPod_Enclosure_v04_USB_Flush_Acrylic_2026-11-02/cad/front_with_clickwheel.step

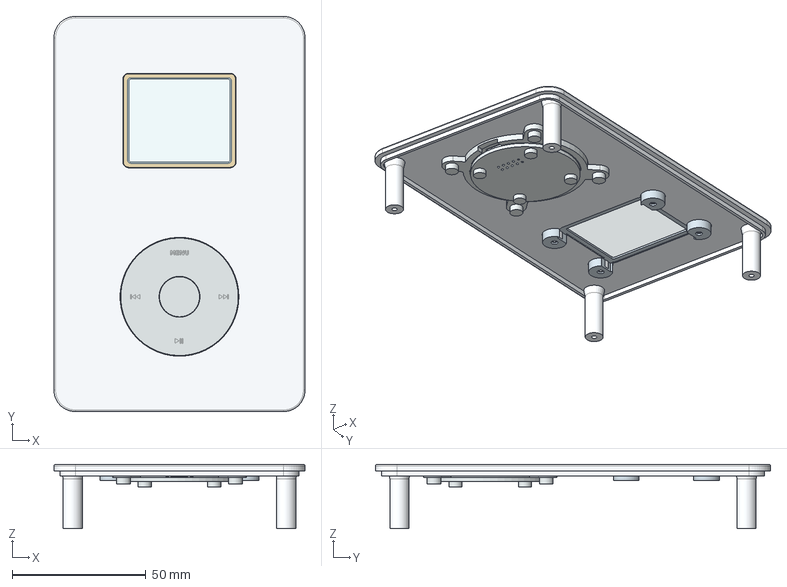
[picture p85: CAD file, 2026-11-14]
Hardware/MonoPod_Enclosure_v04_USB_Flush_Acrylic_2026-11-02/cad/front_with_clickwheel.step
94.0 x 148.0 x 24.0 mm
front_panel
display_lens_carrier
clickwheel_original_assembly
screen_lens
lens_adhesive_envelope
