IlyaBOT/MonoPod/Hardware/MonoPod_Enclosure_v04_USB_Flush_Acrylic_2026-11-02/cad/hold_cap_lever_gap_0p20.step

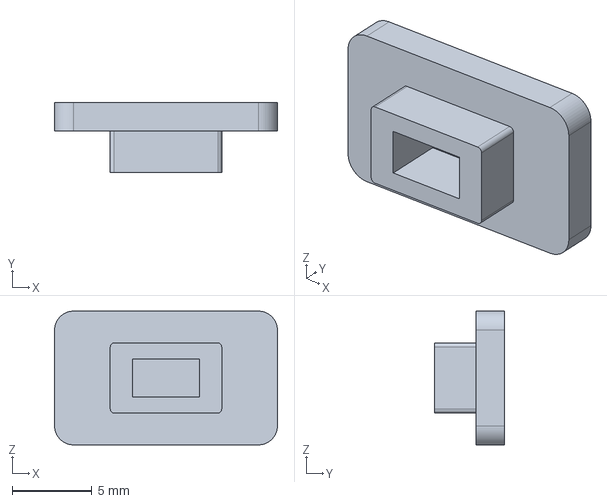
[picture p86: CAD file, 2026-11-14]
Hardware/MonoPod_Enclosure_v04_USB_Flush_Acrylic_2026-11-02/cad/hold_cap_lever_gap_0p20.step
14.0 x 4.40 x 8.40 mm
