IlyaBOT/MonoPod/Hardware/MonoPod_Enclosure_v04_USB_Flush_Acrylic_2026-11-02/cad/closure_rear_plate_coupon.step

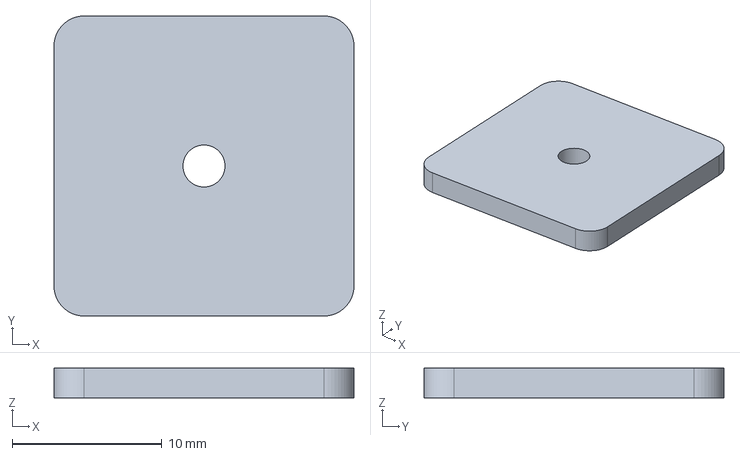
[picture p89: CAD file, 2026-11-14]
Hardware/MonoPod_Enclosure_v04_USB_Flush_Acrylic_2026-11-02/cad/closure_rear_plate_coupon.step
20.0 x 20.0 x 2.00 mm
