IlyaBOT/MonoPod/Hardware/MonoPod_Enclosure_v04_USB_Flush_Acrylic_2026-11-02/cad/bottom_insert_recess_2p50.step

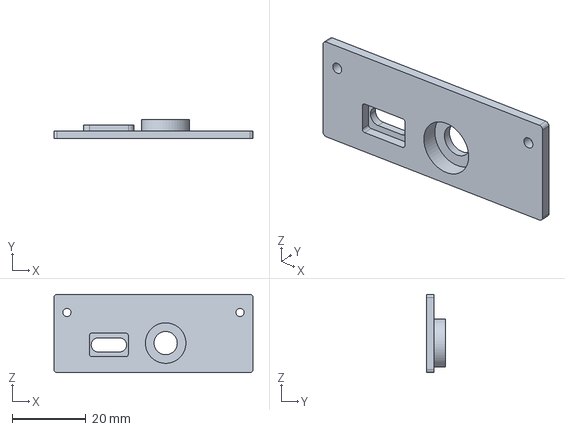
[picture p91: CAD file, 2026-11-14]
Hardware/MonoPod_Enclosure_v04_USB_Flush_Acrylic_2026-11-02/cad/bottom_insert_recess_2p50.step
54.0 x 5.05 x 21.2 mm
