IlyaBOT/MonoPod/(list of files, cad)

Other CAD files:
Hardware/MonoPod_Enclosure_v04_USB_Flush_Acrylic_2026-11-02/reference/envelopes/clickwheel_assembly.step
Hardware/MonoPod_Enclosure_v04_USB_Flush_Acrylic_2026-11-02/cad/bottom_aperture_extra_0p20.step
Hardware/MonoPod_Enclosure_v04_USB_Flush_Acrylic_2026-11-02/reference/envelopes/clickwheel_frame.step
Hardware/MonoPod_Enclosure_v04_USB_Flush_Acrylic_2026-11-02/reference/envelopes/clickwheel_pcb.step
Hardware/MonoPod_Enclosure_v04_USB_Flush_Acrylic_2026-11-02/cad/hold_switch_coupon.step
Hardware/MonoPod_Enclosure_v04_USB_Flush_Acrylic_2026-11-02/cad/clickwheel_depth_extra_0p20.step
Hardware/MonoPod_Enclosure_v04_USB_Flush_Acrylic_2026-11-02/cad/acrylic_seat_gap_0p25.step
Hardware/MonoPod_Enclosure_v04_USB_Flush_Acrylic_2026-11-02/cad/bottom_aperture_extra_0p40.step
Hardware/MonoPod_Enclosure_v04_USB_Flush_Acrylic_2026-11-02/reference/envelopes/clickwheel_select.step
Hardware/MonoPod_Enclosure_v04_USB_Flush_Acrylic_2026-11-02/cad/acrylic_screen_lens.step
Hardware/MonoPod_Enclosure_v04_USB_Flush_Acrylic_2026-11-02/cad/bottom_connector_insert.step
Hardware/MonoPod_Enclosure_v04_USB_Flush_Acrylic_2026-11-02/cad/bottom_insert_gap_0p25.step
Hardware/MonoPod_Enclosure_v04_USB_Flush_Acrylic_2026-11-02/cad/acrylic_seat_gap_0p30.step
Hardware/MonoPod_Enclosure_v04_USB_Flush_Acrylic_2026-11-02/cad/hold_window_gap_0p20.step
Hardware/MonoPod_Enclosure_v04_USB_Flush_Acrylic_2026-11-02/cad/front_panel.step
Hardware/MonoPod_Enclosure_v04_USB_Flush_Acrylic_2026-11-02/cad/hold_cap_lever_gap_m0p05.step
Hardware/MonoPod_Enclosure_v04_USB_Flush_Acrylic_2026-11-02/cad/bottom_insert_gap_0p30.step
Hardware/MonoPod_Enclosure_v04_USB_Flush_Acrylic_2026-11-02/cad/usb_cable_well_gap_0p30.step
Hardware/MonoPod_Enclosure_v04_USB_Flush_Acrylic_2026-11-02/cad/back_chassis.step
Hardware/MonoPod_Enclosure_v04_USB_Flush_Acrylic_2026-11-02/cad/acrylic_seat_gap_0p15.step
Hardware/MonoPod_Enclosure_v04_USB_Flush_Acrylic_2026-11-02/cad/clickwheel_window_gap_0p30.step
Hardware/MonoPod_Enclosure_v04_USB_Flush_Acrylic_2026-11-02/cad/hold_mount_pitch_15p00.step
Hardware/MonoPod_Enclosure_v04_USB_Flush_Acrylic_2026-11-02/cad/clickwheel_window_gap_0p15.step
Hardware/MonoPod_Enclosure_v04_USB_Flush_Acrylic_2026-11-02/cad/clickwheel_depth_extra_0p00.step
Hardware/MonoPod_Enclosure_v04_USB_Flush_Acrylic_2026-11-02/cad/hold_window_gap_0p15.step
Hardware/MonoPod_Enclosure_v04_USB_Flush_Acrylic_2026-11-02/cad/acrylic_seat_coupon.step
Hardware/MonoPod_Enclosure_v04_USB_Flush_Acrylic_2026-11-02/cad/clickwheel_window_gap_0p25.step
Hardware/MonoPod_Enclosure_v04_USB_Flush_Acrylic_2026-11-02/cad/hold_cap_lever_gap_0p10.step
Hardware/MonoPod_Enclosure_v04_USB_Flush_Acrylic_2026-11-02/cad/clickwheel_depth_extra_0p10.step
Hardware/MonoPod_Enclosure_v04_USB_Flush_Acrylic_2026-11-02/cad/clickwheel_mount_coupon.step
Hardware/MonoPod_Enclosure_v04_USB_Flush_Acrylic_2026-11-02/cad/screw_boss_coupon.step
Hardware/MonoPod_Enclosure_v04_USB_Flush_Acrylic_2026-11-02/reference/envelopes/jack_nut.step
Hardware/MonoPod_Enclosure_v04_USB_Flush_Acrylic_2026-11-02/stl/acrylic_seat_coupon.stl
Hardware/MonoPod_Enclosure_v04_USB_Flush_Acrylic_2026-11-02/stl/acrylic_seat_gap_0p15.stl
Hardware/MonoPod_Enclosure_v04_USB_Flush_Acrylic_2026-11-02/stl/acrylic_seat_gap_0p25.stl
Hardware/MonoPod_Enclosure_v04_USB_Flush_Acrylic_2026-11-02/stl/acrylic_seat_gap_0p30.stl
Hardware/MonoPod_Enclosure_v04_USB_Flush_Acrylic_2026-11-02/stl/back_chassis.stl
Hardware/MonoPod_Enclosure_v04_USB_Flush_Acrylic_2026-11-02/stl/bottom_aperture_extra_0p20.stl
Hardware/MonoPod_Enclosure_v04_USB_Flush_Acrylic_2026-11-02/stl/bottom_aperture_extra_0p40.stl
Hardware/MonoPod_Enclosure_v04_USB_Flush_Acrylic_2026-11-02/stl/bottom_connector_insert.stl
Hardware/MonoPod_Enclosure_v04_USB_Flush_Acrylic_2026-11-02/stl/bottom_edge_coupon.stl
Hardware/MonoPod_Enclosure_v04_USB_Flush_Acrylic_2026-11-02/stl/bottom_insert_gap_0p15.stl
Hardware/MonoPod_Enclosure_v04_USB_Flush_Acrylic_2026-11-02/stl/bottom_insert_gap_0p25.stl
Hardware/MonoPod_Enclosure_v04_USB_Flush_Acrylic_2026-11-02/stl/bottom_insert_gap_0p30.stl
Hardware/MonoPod_Enclosure_v04_USB_Flush_Acrylic_2026-11-02/stl/bottom_insert_recess_1p50.stl
Hardware/MonoPod_Enclosure_v04_USB_Flush_Acrylic_2026-11-02/stl/bottom_insert_recess_2p50.stl
Hardware/MonoPod_Enclosure_v04_USB_Flush_Acrylic_2026-11-02/stl/clickwheel_depth_extra_0p00.stl
Hardware/MonoPod_Enclosure_v04_USB_Flush_Acrylic_2026-11-02/stl/clickwheel_depth_extra_0p10.stl
Hardware/MonoPod_Enclosure_v04_USB_Flush_Acrylic_2026-11-02/stl/clickwheel_depth_extra_0p20.stl
Hardware/MonoPod_Enclosure_v04_USB_Flush_Acrylic_2026-11-02/stl/clickwheel_mount_coupon.stl
Hardware/MonoPod_Enclosure_v04_USB_Flush_Acrylic_2026-11-02/stl/clickwheel_window_gap_0p15.stl
Hardware/MonoPod_Enclosure_v04_USB_Flush_Acrylic_2026-11-02/stl/clickwheel_window_gap_0p20.stl
Hardware/MonoPod_Enclosure_v04_USB_Flush_Acrylic_2026-11-02/stl/clickwheel_window_gap_0p25.stl
Hardware/MonoPod_Enclosure_v04_USB_Flush_Acrylic_2026-11-02/stl/clickwheel_window_gap_0p30.stl
Hardware/MonoPod_Enclosure_v04_USB_Flush_Acrylic_2026-11-02/stl/closure_front_boss_coupon.stl
Hardware/MonoPod_Enclosure_v04_USB_Flush_Acrylic_2026-11-02/stl/closure_rear_plate_coupon.stl
Hardware/MonoPod_Enclosure_v04_USB_Flush_Acrylic_2026-11-02/stl/display_lens_carrier.stl
Hardware/MonoPod_Enclosure_v04_USB_Flush_Acrylic_2026-11-02/stl/display_window_coupon.stl
Hardware/MonoPod_Enclosure_v04_USB_Flush_Acrylic_2026-11-02/stl/front_panel.stl
Hardware/MonoPod_Enclosure_v04_USB_Flush_Acrylic_2026-11-02/stl/front_panel_rear_lip_alternative.stl
Hardware/MonoPod_Enclosure_v04_USB_Flush_Acrylic_2026-11-02/stl/hold_cap_lever_gap_0p10.stl
Hardware/MonoPod_Enclosure_v04_USB_Flush_Acrylic_2026-11-02/stl/hold_cap_lever_gap_0p20.stl
Hardware/MonoPod_Enclosure_v04_USB_Flush_Acrylic_2026-11-02/stl/hold_cap_lever_gap_m0p05.stl
Hardware/MonoPod_Enclosure_v04_USB_Flush_Acrylic_2026-11-02/stl/hold_mount_pitch_15p00.stl
Hardware/MonoPod_Enclosure_v04_USB_Flush_Acrylic_2026-11-02/stl/hold_slider_cap.stl
Hardware/MonoPod_Enclosure_v04_USB_Flush_Acrylic_2026-11-02/stl/hold_switch_coupon.stl
Hardware/MonoPod_Enclosure_v04_USB_Flush_Acrylic_2026-11-02/stl/hold_window_gap_0p15.stl
Hardware/MonoPod_Enclosure_v04_USB_Flush_Acrylic_2026-11-02/stl/hold_window_gap_0p20.stl
Hardware/MonoPod_Enclosure_v04_USB_Flush_Acrylic_2026-11-02/stl/hold_window_gap_0p25.stl
Hardware/MonoPod_Enclosure_v04_USB_Flush_Acrylic_2026-11-02/stl/hold_window_gap_0p30.stl
Hardware/MonoPod_Enclosure_v04_USB_Flush_Acrylic_2026-11-02/stl/jack_hole_diameter_coupon.stl
Hardware/MonoPod_Enclosure_v04_USB_Flush_Acrylic_2026-11-02/stl/jack_panel_thickness_1p20.stl
Hardware/MonoPod_Enclosure_v04_USB_Flush_Acrylic_2026-11-02/stl/jack_panel_thickness_1p60.stl
Hardware/MonoPod_Enclosure_v04_USB_Flush_Acrylic_2026-11-02/stl/jack_panel_thickness_2p00.stl
Hardware/MonoPod_Enclosure_v04_USB_Flush_Acrylic_2026-11-02/stl/jack_panel_thickness_2p40.stl
Hardware/MonoPod_Enclosure_v04_USB_Flush_Acrylic_2026-11-02/stl/lens_gluing_jig.stl
Hardware/MonoPod_Enclosure_v04_USB_Flush_Acrylic_2026-11-02/stl/mainboard_hole_template_coupon.stl
Hardware/MonoPod_Enclosure_v04_USB_Flush_Acrylic_2026-11-02/stl/screw_boss_coupon.stl
Hardware/MonoPod_Enclosure_v04_USB_Flush_Acrylic_2026-11-02/stl/stack_height_gauge.stl
Hardware/MonoPod_Enclosure_v04_USB_Flush_Acrylic_2026-11-02/stl/tolerance_frame_coupon.stl
Hardware/MonoPod_Enclosure_v04_USB_Flush_Acrylic_2026-11-02/stl/tolerance_key.stl
Hardware/MonoPod_Enclosure_v04_USB_Flush_Acrylic_2026-11-02/stl/usb_cable_well_gap_0p30.stl
Hardware/MonoPod_Enclosure_v04_USB_Flush_Acrylic_2026-11-02/stl/usb_cable_well_gap_0p50.stl
