IlyaBOT/MonoPod/Hardware/TDA1308_HeadphoneAmp/revisions/R1_snapshot/FABRICATION.txt

TDA1308 HeadphoneAmp R1
45 x 25 mm, 2 copper layers, FR4 1.6 mm, 35 um copper.
Solder mask and silkscreen both sides, standard solderable finish.
Minimum trace 0.25 mm, copper clearance 0.20 mm, copper-edge 0.50 mm.
Vias 0.65 mm diameter / 0.30 mm plated drill.
Electrolytic plated drill 0.80 mm; wire plated drill 1.15 mm.
Use Gerbers and Excellon as exported; do not mirror or scale.
Edge_Cuts is the routed board outline. No NPTH holes (empty file expected).
No assembly order is requested.
Nominal dimensions refer to outline centerline. Gerber job bounding box includes 0.05 mm outline stroke (45.05 x 25.05 mm).
