IlyaBOT/MonoPod/Hardware/TDA1308_HeadphoneAmp/revisions/R1_snapshot/validation/netlist_check.txt

PASS: all schematic net members match independently specified component pin/net map.
