IlyaBOT/MonoPod/Hardware/MonoPod_Enclosure_v04_USB_Flush_Acrylic_2026-11-02/validation/REFERENCE_AUDIT_RU.md

# Аудит v0.4, 02.11.2026

Новые сведения пользователя: миниджек выступает дальше USB-C, сохранить его защитную юбку и сделать место для корпуса кабельного штекера. Корпус кабеля примерно 9.7×5.6, носик около 7 мм; инструментальная погрешность не измерена. Требуется плоский лазерный акрил почти заподлицо с задней клеевой рамкой под общими винтами TFT.

Сохранённые измерения: макетка 70×90, выступ USB 6–7 (выбрано 6.5), джек 7–8 (7.5), USB слева отступ 6–7 (6.5), просвет между оболочкой USB и резьбовым носиком джека около 8. Оси относительно макетки — прежние оценочные 2.7/3.2. Дисплей, отверстия макетки/HOLD, толщина пайки, батарея и провода не обмерены.

Сборку теперь позиционирует длинный разъём: jack_tip_recess=1 ставит конец носика на 1 мм за плоскость наружной стенки. Из разницы вылетов получается утопление USB 2. Носик/гайка защищены. Макетка, зарядник и джек по-прежнему единый жёсткий узел; изменение родительского размера двигает все модули и крепёж платы вместе.

USB: корпус кабеля 9.7×5.6 с входом 10.5×6.4; по 0.4 на сторону. Глубина сопряжения 6 и металл 8.2×2.4 условны, их не выдаём за USB-спецификацию/обмер. От носика 7 получается вход корпуса на 1 мм, глубина кармана 1.5 даёт осевой запас 0.5. Проверяется корпус +0.2 по двум полным размерам и носик −0.2. Это проектный запас, не калибровка прибора и не физическое доказательство полного контакта.

Акрил плоский 42×35×1 R2, контур лазера сохранён. Проём в панели 42.4×35.4 насквозь, лицевая поверхность D0.1. Рамка с полосой 2, толщиной 0.8 и задними ушами 0.8; общий крепёж M2.5×5. От рамки до условного стекла TFT 0.5. Вклейка без TFT на временных M2.5×3 и печатном кондукторе. Фрезерованные элементы акрила не нужны.

Чертёж PJ-324MX в reference/external — аналог фактического PJ-324M, не доказательство соответствия экземпляра. Гайка Ø8.2×1.6 по-прежнему оценочная. Габариты TFT и HOLD условные. Original Click Wheel STEP/параметры и четыре фото сохранены и проверяются по хешам. Стек 22 и внешний корпус 94×148×26 не изменены.

CAD-проверки включают пересечения рамки со стойками/стеклом, плоским акрилом и клеевой зоной, внутренние пересечения припаянных модулей, кабельный корпус с допуском и выборочные положения его подключения. Проверка доступа всей платы в поддон консервативная непрерывная; надевание вставки/кабеля проверено в выборочных положениях. Не проводились печать, резка, вклейка, физическая примерка, проверка электрического контакта/прочности/ресурса.
