IlyaBOT/MonoPod/Hardware/TDA1308_HeadphoneAmp/revisions/R1_snapshot/validation/datasheet_comparison.md

# Проверка NXP Fig.4 и отличия проекта

Первичный источник: https://www.nxp.com/docs/en/data-sheet/TDA1308.pdf, Rev.5 14.03.2011, Fig.4 стр.6; таблица выводов стр.3, таблица характеристик стр.5, корпус SO8 стр.9. PDF прочитан через web; изображение стр.6 просмотрено локально из зеркальной копии того же оригинального документа NXP: https://www.kyohritsu.com/eclib/OTHER/DATASHEET/NXP/tda1308.pdf .

Сохранены: распиновка 1 OUTA, 2 INA-, 3 INA+, 4 VSS/GND, 5 INB+, 6 INB-, 7 OUTB, 8 VDD; два инвертирующих каскада с Rin=Rf=3,9 кОм; делитель 10+10 кОм; CREF=22 мкФ; развязка питания 100 мкФ + 100 нФ; + выходных электролитов к усилителю, - к нагрузке.

Изменения относительно Fig.4: входные конденсаторы 1 -> 4,7 мкФ (неполярные X7R с эффективной ёмкостью >=2,2 мкФ); выходные 100 -> 220 мкФ с вариантами 470/100 мкФ; повышенные напряжения электролитов >=10 В; отключаемые с обоих концов входные делители 10 кОм / 3,3 кОм; выходные 2,2 Ом перед электролитами и вне обратной связи, сменные на 0 Ом; bleeder 100 кОм после электролитов; точки измерения и провода. Нумерация деталей проекта отличается от NXP.

При 3,3 В устройство находится в заявленном диапазоне 3-7 В, но паспортные показатели мощности/THD при 5 В нельзя считать измеренными или гарантированными для этого образца при 3,3 В. CL <=200 пФ указано в таблице характеристик при паспортных условиях; 2,2 Ом не подтверждают устойчивость с произвольным кабелем. Требуется испытание собранной платы. Независимый анализ конфигураций подтверждает отключение паразитной нагрузки делителя в DIRECT. Обратная связь короткая, без дополнительных RC/ёмкостей на RAW-GND.
