IlyaBOT/MonoPod/MonoPod_Desktop/docs/validation-1.2.0/settings-100.png

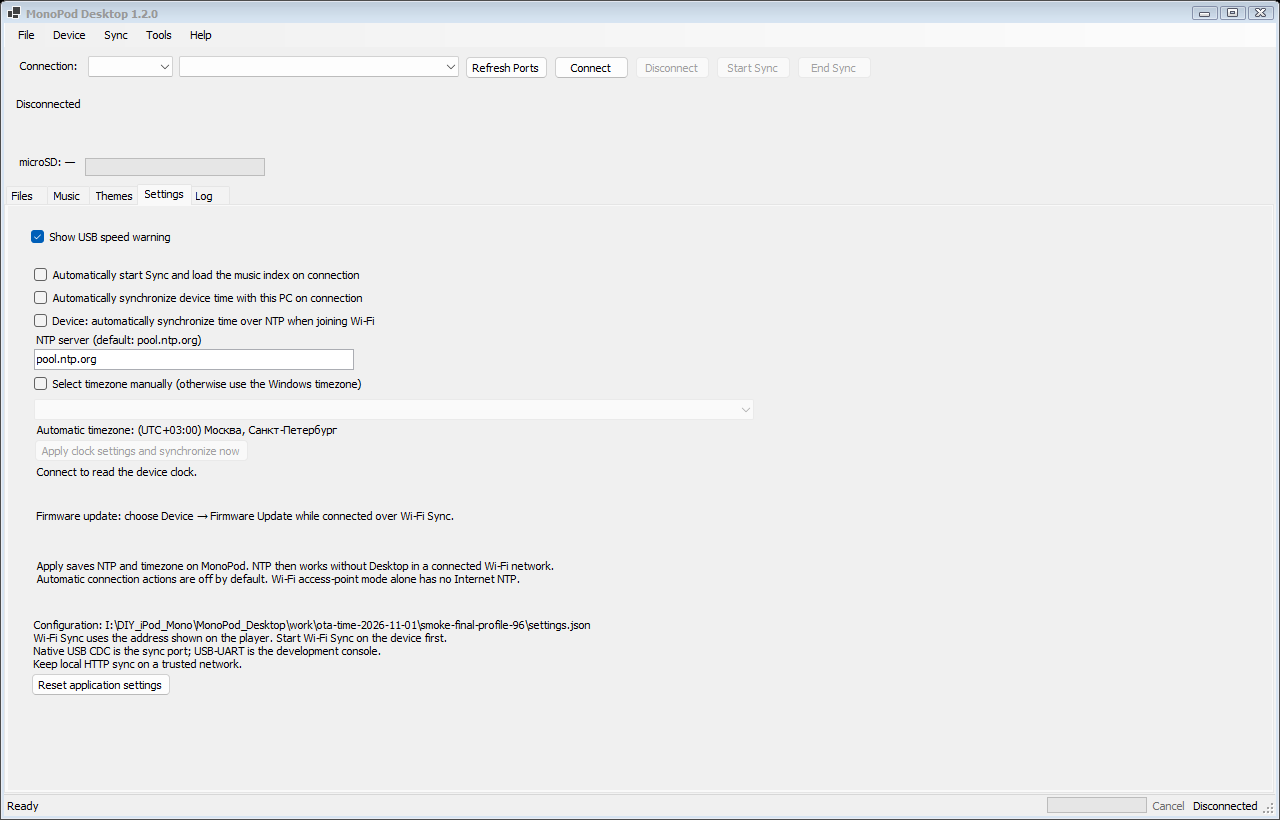
MonoPod_Desktop/docs/validation-1.2.0/settings-100.png
