IlyaBOT/MonoPod/MonoPod_Desktop/docs/validation-1.2.0/settings-150.png

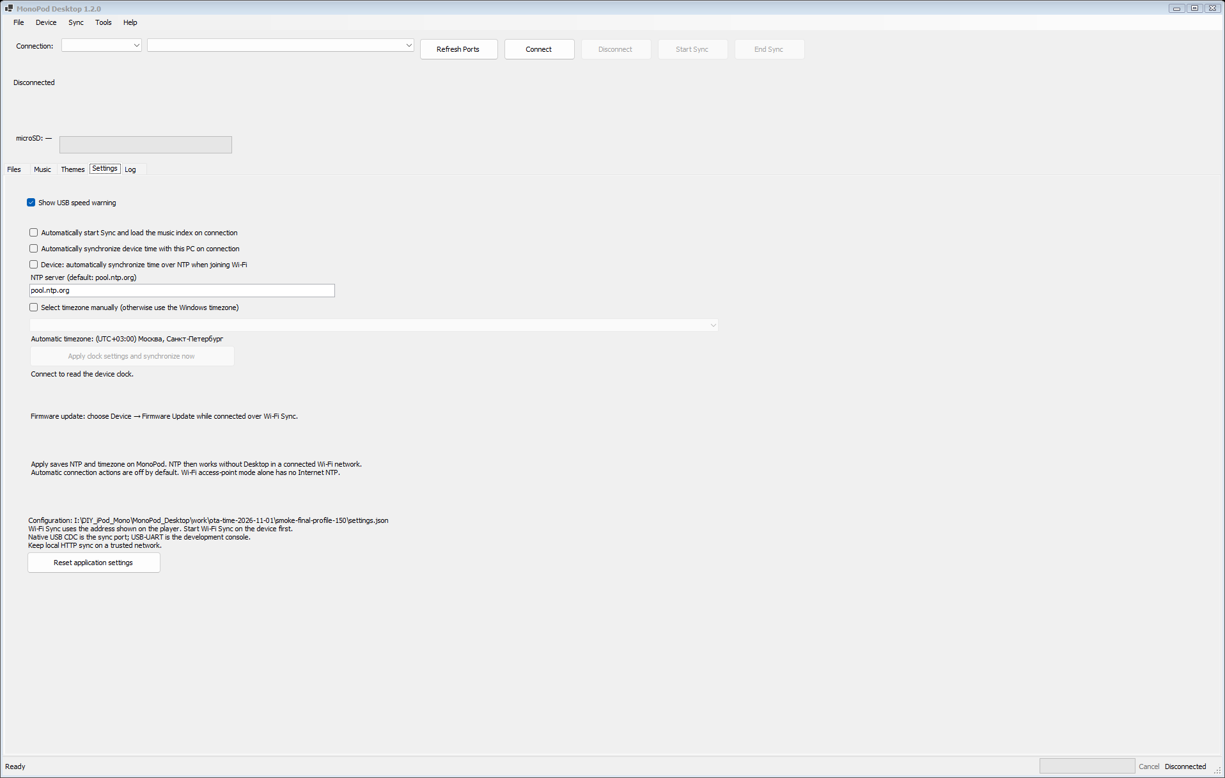
MonoPod_Desktop/docs/validation-1.2.0/settings-150.png
