IlyaBOT/MonoPod/MonoPod_Desktop/docs/validation-1.2.1/clock-moscow-100.png

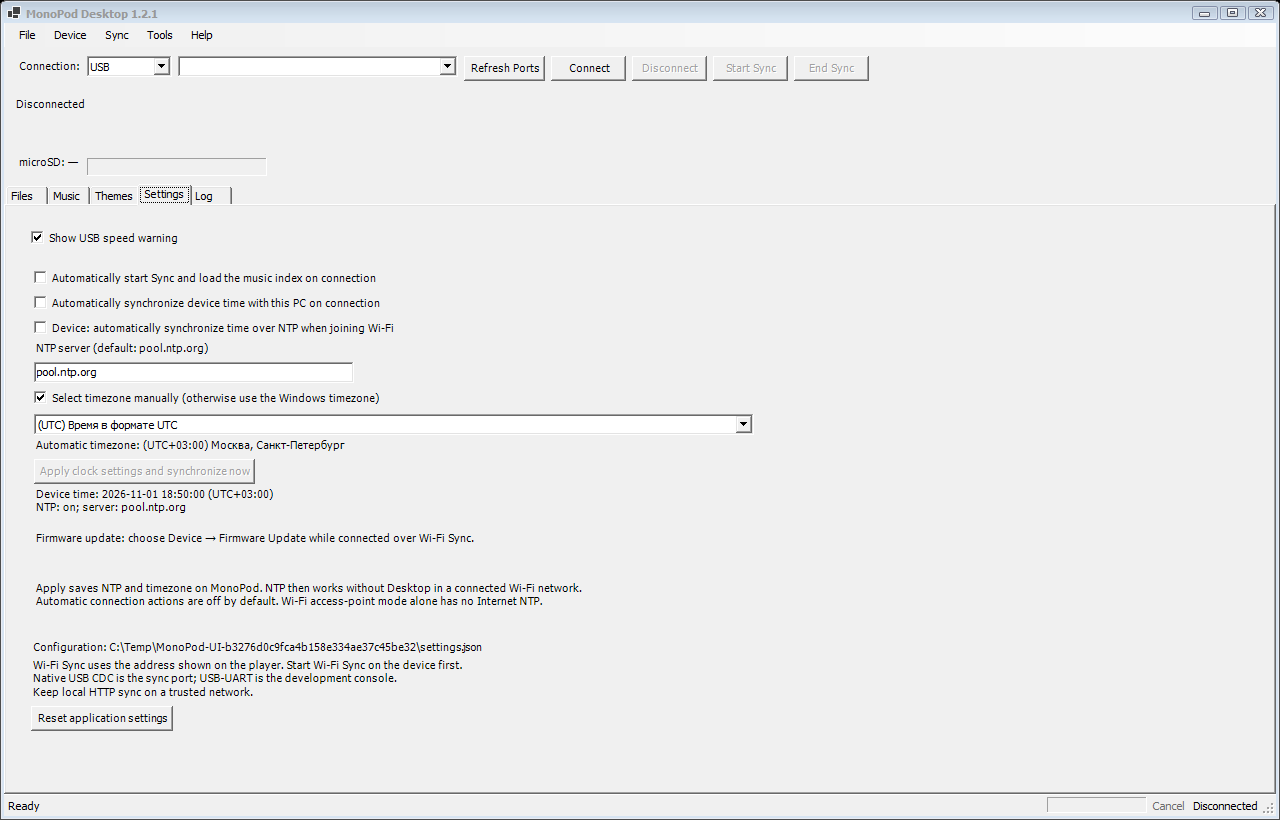
MonoPod_Desktop/docs/validation-1.2.1/clock-moscow-100.png
