IlyaBOT/MonoPod/MonoPod_Desktop/docs/validation-1.2.1/clock-moscow-150.png

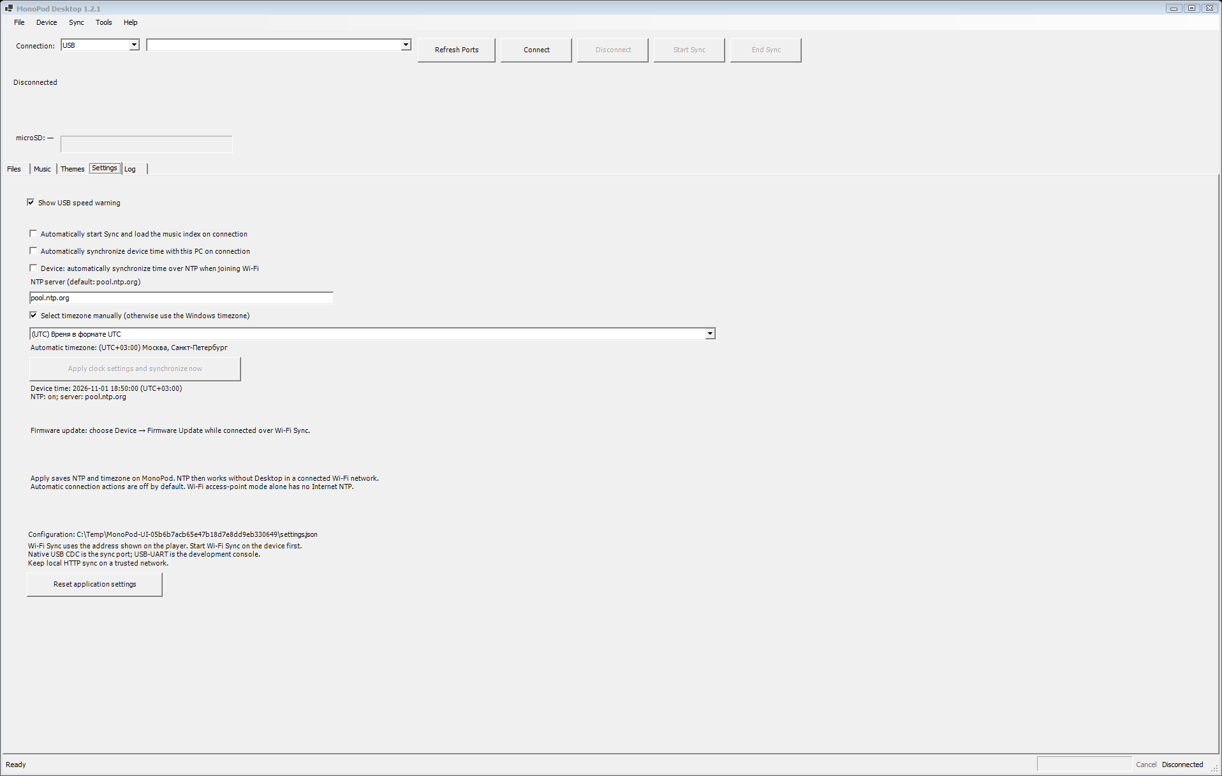
MonoPod_Desktop/docs/validation-1.2.1/clock-moscow-150.png
