IlyaBOT/MonoPod/MonoPod_Desktop/docs/validation-1.3.0/smoke/main.png

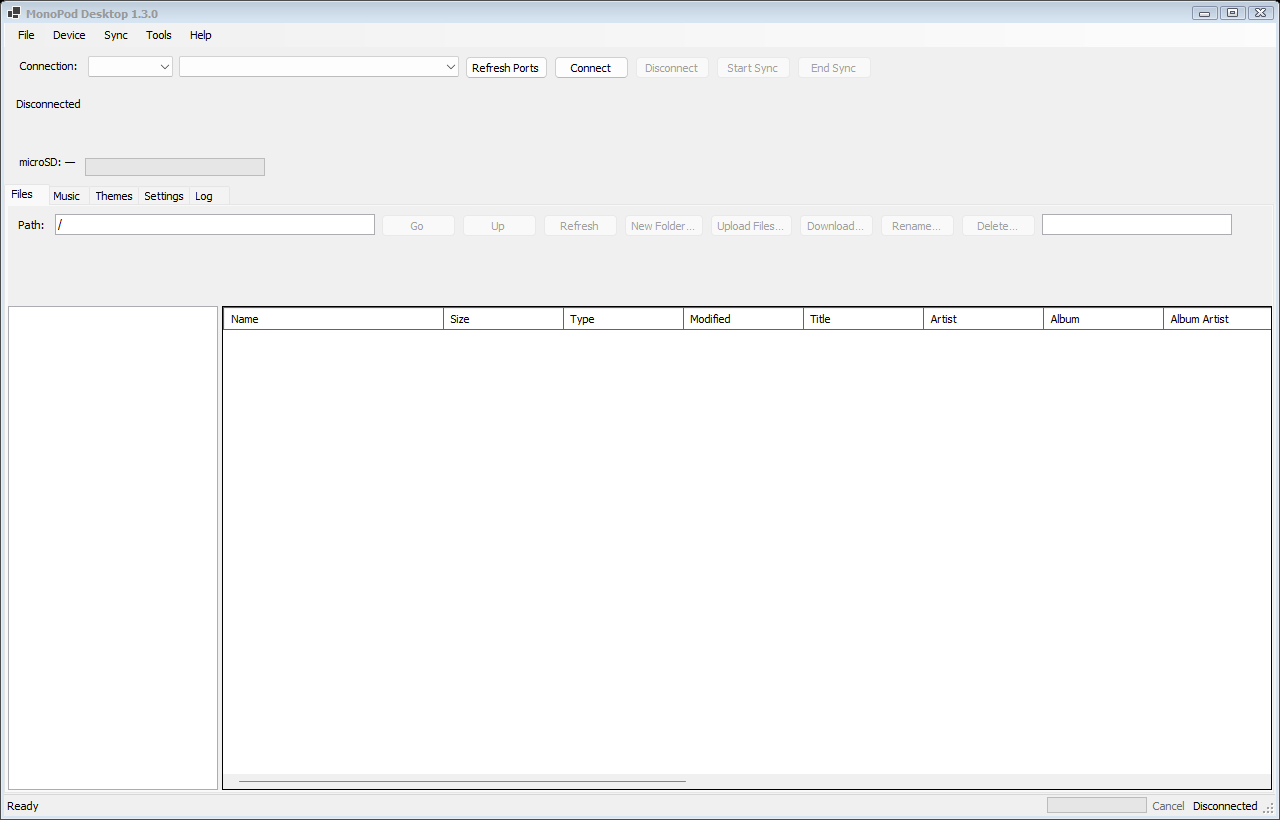
MonoPod_Desktop/docs/validation-1.3.0/smoke/main.png
