IlyaBOT/MonoPod/Hardware/TDA1308_HeadphoneAmp/revisions/R1_snapshot/README.md

# MonoPod: усилитель наушников TDA1308, R1

Создано 27.10.2026 в KiCad 10.0.6. Основной проект: `TDA1308_HeadphoneAmp.kicad_pro`; редактируемые схема и PCB находятся рядом. Папки `libraries/`, таблицы `sym-lib-table` и `fp-lib-table` содержат реальные символы, footprints и модели из установленного KiCad, поэтому проект можно переносить целиком.

## Что выполнено и что подтверждено

- Двухслойная PCB 45 x 25 мм, FR4 1,6 мм. Компоненты сверху; большие электролиты вдоль верхнего края.
- Основа: [NXP TDA1308 Rev.5, Fig.4, стр.6](https://www.nxp.com/docs/en/data-sheet/TDA1308.pdf). Инвертирующие каскады, VREF, питание и полярности сверены по рисунку; различия перечислены в `validation/datasheet_comparison.md`.
- Свежие ERC и DRC: 0 нарушений, 0 незавершённых соединений, 0 расхождений PCB со схемой. Отчёты в `validation/`. Исключения DRC не добавлялись.
- Проверены все площадки и выводы по экспортированному нетлисту, полярности C1/C2/C6/C7, pin 1 U1 и конфигурации ATT/DIRECT. `engineering_audit.json` и `calculations.json` содержат измеренные CAD-параметры и расчёты.
- Это законченные CAD-файлы и производственные экспорты. Физический образец не изготовлен и не испытан. ERC/DRC не подтверждают исправность выпаянной микросхемы, устойчивость с конкретным кабелем, THD, шум или механическое размещение в корпусе MonoPod.

## Питание и провода

Штатно подать стабилизированные 3,3 В. Подача 5 В допустима только после успешных испытаний на стенде; 5 В идут только на эту плату, а не на GPIO ESP32. Не превышать 5 В в этом проекте. Общая земля для питания, PCM5102A и наушников. Разъём 3,5 мм устанавливается отдельно.

| Площадка | Надпись | Назначение |
|---|---|---|
| J1 | VCC | VDD, питание 3,3 В |
| J2 | GND | Земля питания и PCM5102A |
| J3 | LIN | Левый линейный сигнал PCM5102A |
| J4 | RIN | Правый линейный сигнал PCM5102A |
| J5 | GND | Общий контакт наушников |
| J6 | LOUT | Левый контакт наушников, после C6 |
| J7 | ROUT | Правый контакт наушников, после C7 |

Смотреть на лицевую сторону: входные провода слева, выходные справа. Отверстия проводов фактически 1,15 мм, площадки 2,3 мм; AWG26-30 подходят. `D0.9mm` в имени footprint обозначает размер провода, а не диаметр сверла. Закрепить провода от натяжения в корпусе. Монтажных отверстий нет. Провода сигнал/земля вести рядом, вдали от ESP32, антенны и импульсных цепей питания.

## Режим входа: переключать только при снятом питании

| Канал / режим | Установить 0 Ом | Не устанавливать / снять |
|---|---|---|
| L ATTENUATED, по умолчанию | R15, R16 | R19 |
| R ATTENUATED, по умолчанию | R17, R18 | R20 |
| L DIRECT | R19 | R15 И R16 |
| R DIRECT | R20 | R17 И R18 |

R3/R4 и R5/R6 остаются на местах. Две снимаемые перемычки полностью отключают соответствующий делитель и от источника, и от выбранного входа. В DIRECT резистор 3,3 кОм не шунтирует источник. Одновременная установка ATT и DIRECT недопустима; электрической механической защиты от ошибочной пайки нет. Каналы можно конфигурировать отдельно. Вход DIRECT при полной амплитуде PCM5102A вызовет клиппинг: начинать с программно уменьшенной громкости.

Изолированный делитель 10 кОм / 3,3 кОм даёт -12,1 дБ, но вход 3,9 кОм нагружает его. Полная схема в ATT имеет около -16,4 дБ до выходного резистора и -17,0 дБ до наушников 32 Ом на средних частотах. При 2,1 В RMS на входе расчётно получается около 0,298 В RMS / 2,8 мВт на канал. Это расчёт линейной схемы, не измерение громкости и не гарантия максимальной мощности. Оба канала инвертированы одинаково; взаимная полярность стерео сохраняется.

R7/R9 и R8/R10 = 3,9 кОм: номинальное отношение резисторов активной ступени -1. В режиме ATT сопротивление источника дополнительно влияет на суммарное усиление. C4/C5 неполярные, 4,7 мкФ / 25 В X7R 1206; выбрать изделие с фактической ёмкостью не менее 2,2 мкФ при постоянном смещении до 2,5 В. Номинальный входной срез: около 5,3 Гц в ATT и 8,7 Гц в DIRECT при 4,7 мкФ, выше при снижении эффективной ёмкости.

## Конденсаторы и имеющиеся детали

| Ref | Номинал по умолчанию | Место / максимальный диаметр | Полярность |
|---|---|---|---|
| C1 | 22 мкФ, >=10 В | Радиальный D5, шаг 2,0 мм | + к VREF, - к GND |
| C2 | 100 мкФ, >=10 В | Радиальный D6,3, шаг 2,5 мм | + к VDD, - к GND |
| C3 | 100 нФ, 25 В, X7R | 0805 | Неполярный |
| C4/C5 | 4,7 мкФ, 25 В, X7R | 1206 | Неполярные |
| C6/C7 | 220 мкФ, >=10 В | Радиальный D8, шаг 3,5 мм | + к усилителю через R11/R12, - к наушникам |

C6/C7 можно заменить на 470 мкФ / >=10 В в том же габарите. Ваши выпаянные 100 мкФ / 25 В электрически подходят для C2 и как временная замена C6/C7; корпус должен физически помещаться. Для C2 требуется D<=6,3 мм, для C6/C7 D<=8 мм. Шаг 2,5 мм у меньшего конденсатора можно аккуратно развести до 3,5 мм для C6/C7, не нагружая выводы у резиновой пробки. Не изгибать выводы вплотную к корпусу. Монтаж стоя; укладка крупных конденсаторов лёжа внутрь платы не предусмотрена. Высоту и место в корпусе измерить до сборки. 3D-модели библиотечные и не доказывают высоту ваших деталей.

Ёмкость, ESR и утечка выпаянных электролитов неизвестны. Вздутые, высохшие и протекающие детали не использовать. Дефектные выходные конденсаторы тоже могут вызывать искажения и потерю баса.

| C6/C7 | Срез на 32 Ом, без 2,2 Ом | Срез с R11/R12 = 2,2 Ом |
|---|---|---|
| 100 мкФ | 49,7 Гц | 46,5 Гц |
| 220 мкФ | 22,6 Гц | 21,2 Гц |
| 470 мкФ | 10,6 Гц | 9,9 Гц |

На 20 Гц вариант 220 мкФ имеет заметный спад; 470 мкФ лучше сохраняет низкие частоты. Расчёт предполагает резистивную нагрузку 32 Ом. Реальный импеданс наушников зависит от частоты.

Подтверждённый набор пользователя: одна выпаянная SOIC-8 с надписью TDA1308 и электролиты 100 мкФ / 25 В, количество и размеры неизвестны. Для штатной сборки требуются дополнительно C1 22 мкФ x1, C3 100 нФ x1, C4/C5 4,7 мкФ x2 и C6/C7 220 мкФ x2 либо 470 мкФ x2. C2 можно взять из имеющихся 100 мкФ, если он исправен и помещается. Если использовать имеющиеся 100 мкФ на выходах, два новых выходных электролита для первого прототипа не обязательны, но срез будет около 50 Гц.

## Устойчивость и сборка

Схема сохраняет обратную связь NXP до разделительного конденсатора. R9/R10 находятся рядом с U1, их сигнальные цепи проходят сверху. C3 расположен рядом с выводом 8; его GND и вывод 4 входят короткими соединениями в общую землю. На B.Cu залит основной GND, на F.Cu добавлена связанная заливка; отдельные короткие переходы сигналов на нижнюю сторону присутствуют. Разъединённые электрически островки меди удаляются; локальные участки земли соединяются через переходы и верхний слой. Метрики в `engineering_audit.json`.

В даташите указана ёмкостная нагрузка до 200 пФ при его условиях. Не устанавливать большие керамические конденсаторы с RAW-выходов на GND. R11/R12 = 2,2 Ом стоят вне петли обратной связи как места для небольшой выходной развязки; они не гарантируют устойчивость с любым кабелем. Замена на 0 Ом допустима после испытаний. На макете обязательно проверить осциллографом отсутствие ВЧ-возбуждения с реальным кабелем и нагрузкой. Расчётное noise gain в ATT около 1,61, в DIRECT около 2; отдельного гарантированного минимального noise gain даташит не задаёт.

Сначала паять резисторы и C3/C4/C5, затем U1, затем электролиты. По умолчанию ставить 18 резисторов, 7 конденсаторов и U1: всего 26 электронных деталей. R19/R20 не ставить. Девять TP и семь J являются площадками платы, дополнительных деталей не требуют. Полный список с количеством, footprint и режимом установки в `BOM.csv` (UTF-8 BOM, разделитель `;`).

U1: SOIC-8 / SO8, тело примерно 3,9 x 4,9 мм, шаг 1,27 мм. TSSOP-8 с шагом 0,65 мм сюда не подходит. По словам пользователя имеющийся корпус SOIC-8; маркировка TDA1308 сама по себе не доказывает происхождение и исправность. На плате pin 1 U1 находится сверху слева; ориентироваться по метке pin 1 и рисунку assembly. Положительная площадка электролитов квадратная и отмечена `+`; закрашенная половина footprint соответствует отрицательной стороне.

## Первый запуск: без PCM5102A и без наушников

1. При снятом питании проверить пайку, ориентацию U1 и полярности четырёх электролитов. Проверить отсутствие устойчивого короткого VDD-GND мультиметром; из-за зарядки C2 показание сопротивления может меняться. Проверить перемычки режима.
2. Подать стабилизированные 3,3 В от лабораторного источника с начальным ограничением 20 мА. Не подавать аудиосигнал. После зарядки конденсаторов источник должен выйти из ограничения. Нормальный ток покоя ожидается единицы мА (NXP: 3 мА типично, 5 мА максимум при 5 В, плюс ток делителя). Устойчивый ток более 10 мА без сигнала или нагрев требуют выключения и поиска причины.
3. Измерить TP1 VDD и TP3 VREF относительно TP2 GND. VREF должен быть около VDD/2: примерно 1,65 В при 3,3 В. Для начальной диагностики ориентир 1,60-1,70 В при точных 3,3 В; это практический ориентир, не паспортный допуск всей сборки.
4. Измерить постоянное напряжение на выводах 1 и 7 / TP6 и TP7. Оба должны быть около VREF, а не около нуля. Заметная разница между каналами либо выход у шины питания требует проверки U1 и обратной связи. Не подключать наушники к TP6/TP7.
5. Проверить DC после выходных конденсаторов, TP8/TP9. Без нагрузки ждать около 120 с для 220 мкФ, 240 с для 470 мкФ, 60 с для 100 мкФ: постоянная времени с 100 кОм составляет 22/47/10 с. В начале возможен зарядный импульс. После установления ориентир <10 мВ; если напряжение сохраняется, проверить полярность/утечку конденсатора и пайку. Это критерий диагностики, не гарантия для неизвестных электролитов.
6. Подать тестовый синус 1 кГц, например 20 мВ RMS, через LIN/RIN с общей землёй. В ATT ожидается около 3 мВ RMS на наушниковом выходе при резистивной нагрузке, поэтому для оценки формы можно постепенно увеличить до 100-200 мВ RMS на входе. Наблюдать оба RAW-выхода и выходы после C6/C7 осциллографом. Земля щупа только GND. Для проверки ВЧ использовать короткую землю щупа и пробник x10.
7. Установить отдельные эквиваленты нагрузки 330 Ом между LOUT-GND и ROUT-GND; проверить форму, DC и просадку питания. Нагрузки подключать при снятом питании, затем повторять измерения после включения.
8. Заменить эквиваленты на 33 Ом, >=0,25 Вт каждый. Для испытаний с сигналом можно увеличить токовый лимит до 50-100 мА, наблюдая потребление. Начинать с малой амплитуды. Не искать предел громкости в наушниках.
9. Проверить отсутствие клиппинга, ВЧ-самовозбуждения, перегрева и заметного падения VDD; повторить с реальным кабелем и с обоими каналами. Логический анализатор не заменяет осциллограф для DC, аналоговой формы и искажений; учитывать допустимые напряжения его входов.
10. Только после успешных проверок подключить наушники при минимальной громкости и установившемся питании. Затем подключить PCM5102A, начиная с минимального цифрового уровня. При выключениях/включениях учитывать зарядные импульсы. Испытание на 5 В проводить сначала без наушников и повторять весь цикл.

Выпаянная U1 может быть повреждена, перемаркирована или перегрета. Правильная схема и чистый DRC не исключают сохранение прежних симптомов перегруза из-за самой микросхемы. Измеренное улучшение на активных колонках не доказывает её работоспособность на 32 Ом.

## Файлы производства

- `gerbers/`: F.Cu/B.Cu, маски, шелкография, Edge.Cuts; сверловки PTH/NPTH и карты отверстий SVG.
- `manufacturing.zip`: только необходимые Gerber/сверловки, Gerber job и `FABRICATION.txt`. Ничего дополнительно не зеркалить и не масштабировать. Пустой NPTH-файл нормален: нет неплакированных отверстий.
- `renders/front.png`, `renders/back.png`: 3D-виды; `copper_front.svg`, `copper_back.svg`: слои меди; `assembly.svg`: карта компонентов. Изображения не являются файлами изготовления.
- `docs/schematic.pdf`: обзор принципиальной схемы; исходник `.kicad_sch` является редактируемым оригиналом.
- `validation/`: свежие проверки, полный нетлист, контроль карт выводов, расчёты и SHA-256 файлов.

Параметры заказа: 45 x 25 мм, 2 слоя, FR4 1,6 мм, медь 35 мкм, обычная маска и шелкография с двух сторон, стандартный паяемый финиш. Минимальные дорожки 0,25 мм, зазоры 0,20 мм; via 0,65/0,30 мм. Допуски и минимумы выбранного производителя нужно сопоставить с этими параметрами. Заказ и изготовление не выполнялись.

Для повторной проверки на этом ПК: `kicad-cli sch erc --severity-all --exit-code-violations TDA1308_HeadphoneAmp.kicad_sch` и `kicad-cli pcb drc --schematic-parity --all-track-errors --severity-all --exit-code-violations TDA1308_HeadphoneAmp.kicad_pcb`. Если CLI отсутствует в PATH, использовать `C:\Program Files\KiCad\10.0\bin\kicad-cli.exe`. Генераторы в `scripts/` сохраняют инженерное происхождение проекта и при запуске перезаписывают файлы; для обычного редактирования открывать нативные файлы KiCad.
