IlyaBOT/MonoPod/Hardware/TDA1308_HeadphoneAmp/REVISION_HISTORY.md

# R2, 27.10.2026

Single copper side B.Cu, 50x35 mm, 0.6 mm traces, zero vias/wire crossovers, all capacitors through hole on top, SMD parts bottom. Fitted resistors 18 -> 14; 0R links replaced by four mode solder selectors. Analog values R1-R14/C1-C7 preserved.

The original I: project R1 is preserved in revisions/R1_snapshot/ and revisions/TDA1308_R1_before_R2.zip of the main working directory. The independent R1 deliverable archive remains in the earlier outputs.
