IlyaBOT/MonoPod/Hardware/TDA1308_HeadphoneAmp/revisions/R1_snapshot/renders/back.png

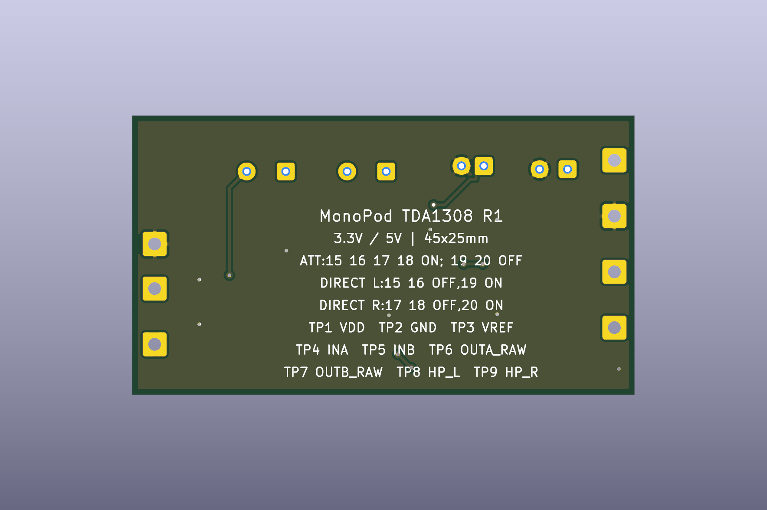
Hardware/TDA1308_HeadphoneAmp/revisions/R1_snapshot/renders/back.png
