IlyaBOT/MonoPod/Hardware/TDA1308_HeadphoneAmp/revisions/R1_snapshot/renders/front.png

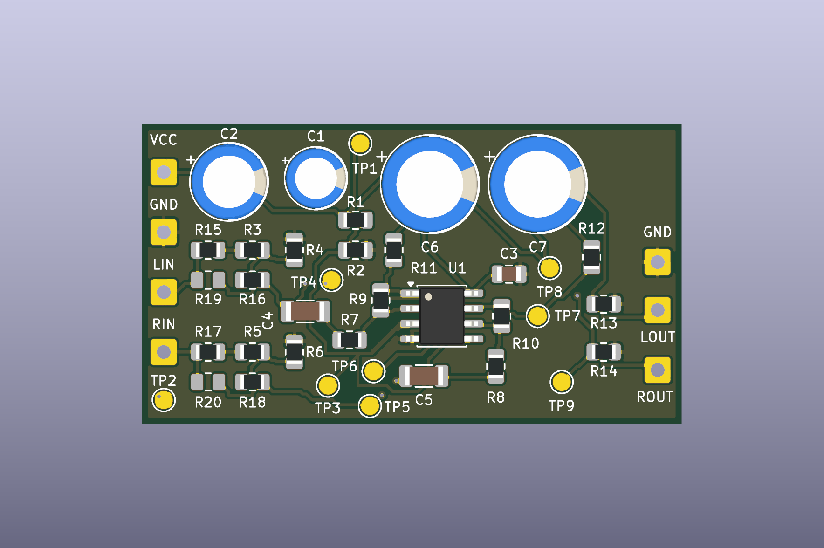
Hardware/TDA1308_HeadphoneAmp/revisions/R1_snapshot/renders/front.png
