IlyaBOT/MonoPod/Hardware/TDA1308_HeadphoneAmp/docs/schematic.pdf

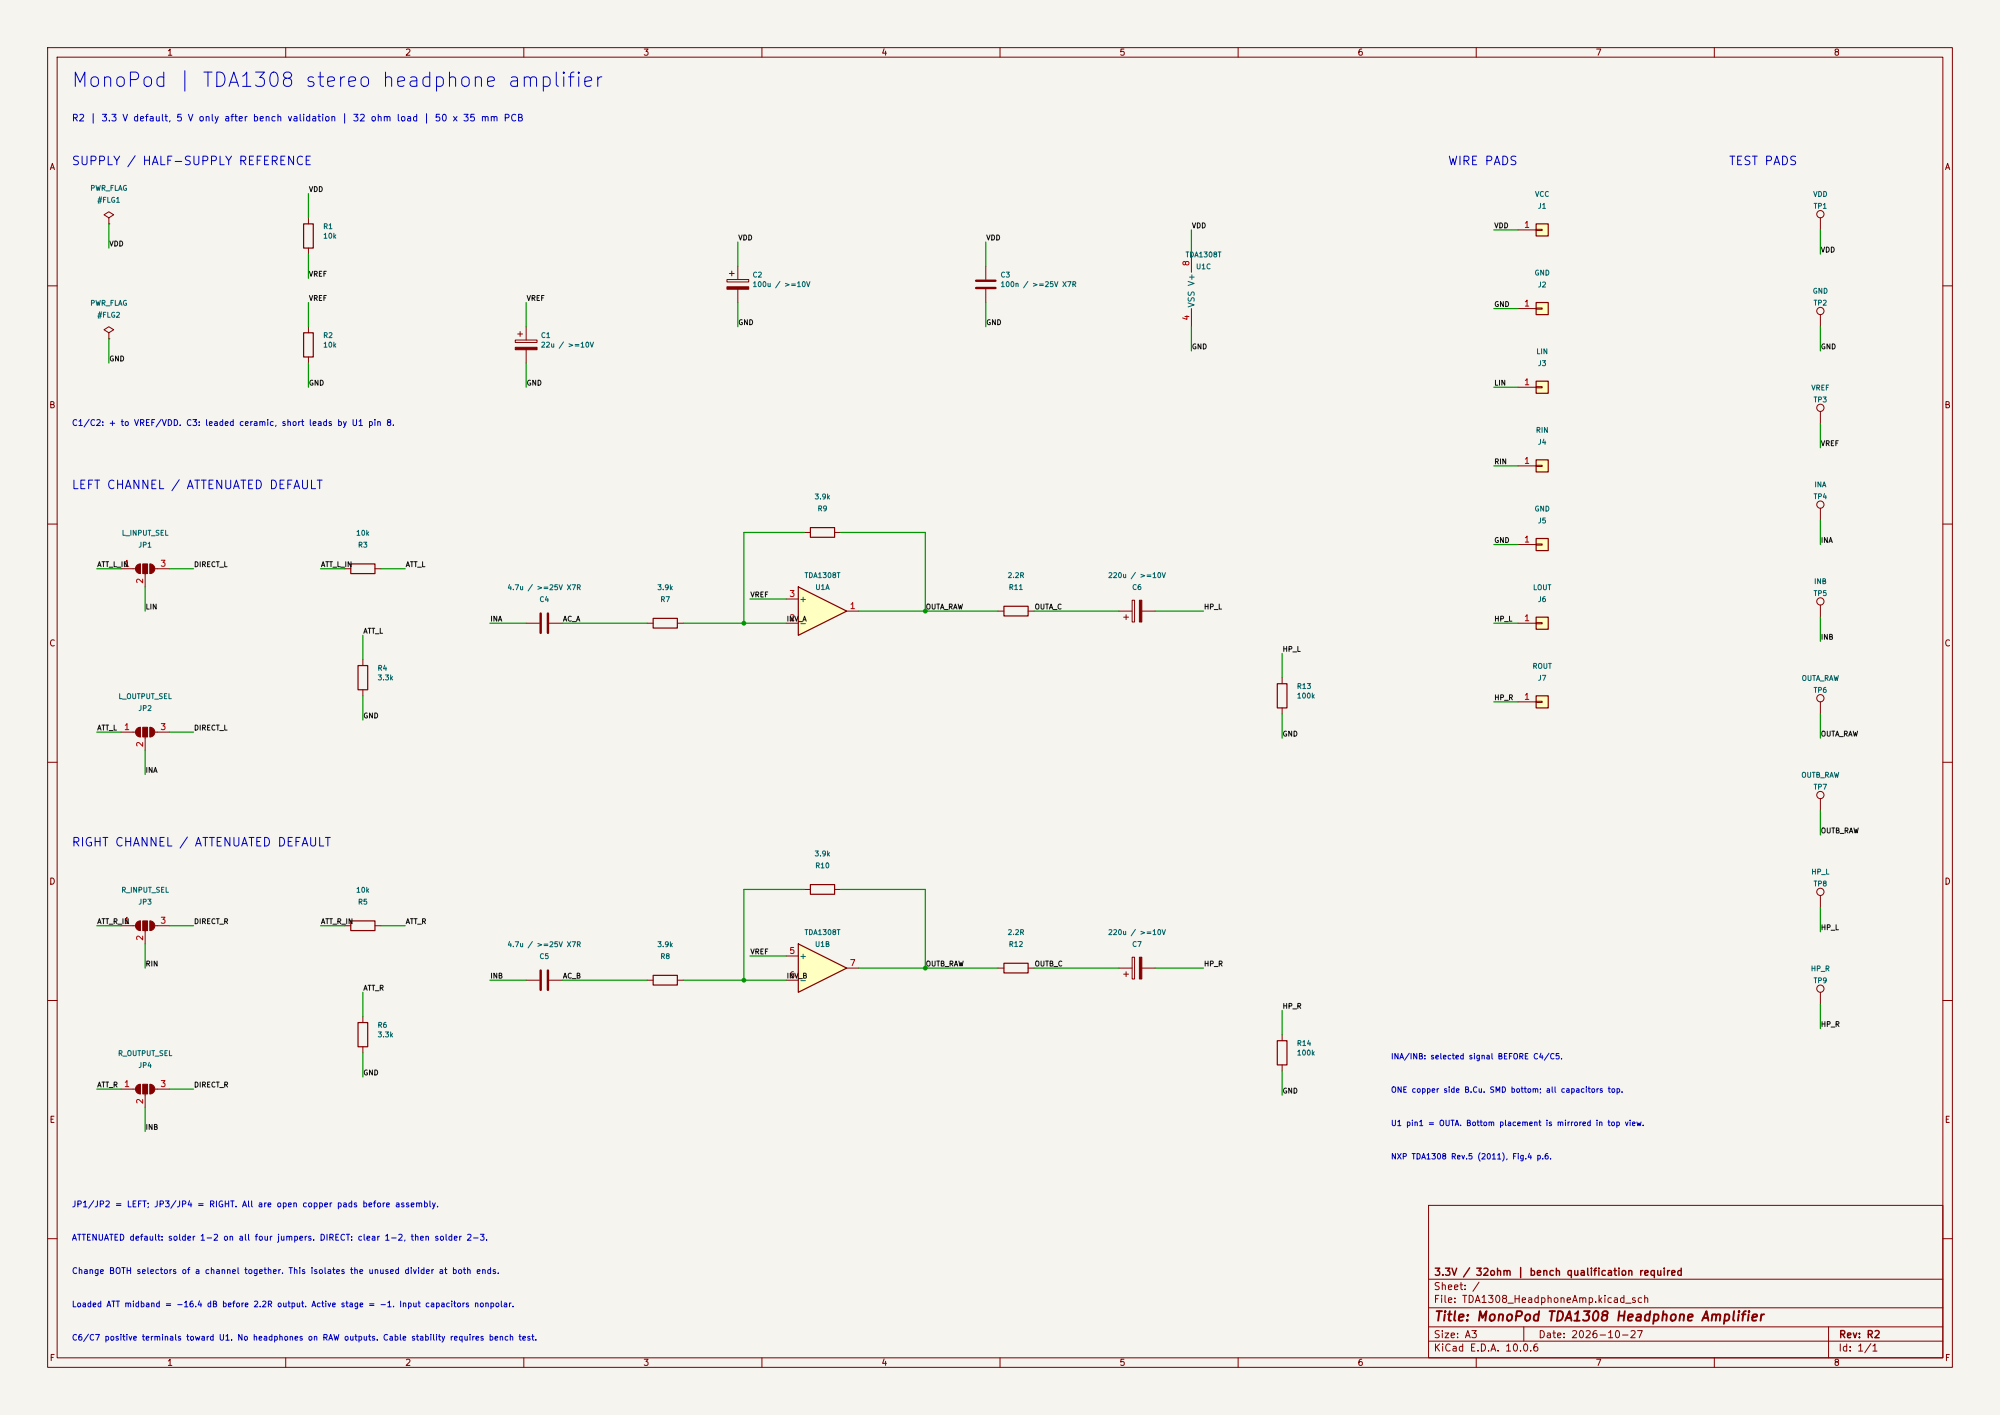
[picture p104: page 1]

MonoPod | TDA1308 stereo headphone amplifier

R2 | 3.3 V default, 5 V only after bench validation | 32 ohm load | 50 x 35 mm PCB

SUPPLY / HALF-SUPPLY REFERENCE

LEFT CHANNEL / ATTENUATED DEFAULT

RIGHT CHANNEL / ATTENUATED DEFAULT

INA/INB: selected signal BEFORE C4/C5.

U1 pin1 = OUTA. Bottom placement is mirrored in top view.

JP1/JP2 = LEFT; JP3/JP4 = RIGHT. All are open copper pads before assembly. ATTENUATED default: solder 1-2 on all four jumpers. DIRECT: clear 1-2, then solder 2-3. Change BOTH selectors of a channel together. This isolates the unused divider at both ends. Loaded ATT midband = -16.4 dB before 2.2R output. Active stage = -1. Input capacitors nonpolar.

3.3V / 32ohm | bench qualification required
Sheet: /
File: TDA1308_HeadphoneAmp.kicad_sch
Title: MonoPod TDA1308 Headphone Amplifier

Size: A3 | Rev: R2 | F Date: 2026-10-27
KiCad E.D.A. 10.0.6 | Id: 1/1
