IlyaBOT/MonoPod/Hardware/TDA1308_HeadphoneAmp/revisions/R1_snapshot/docs/schematic.pdf

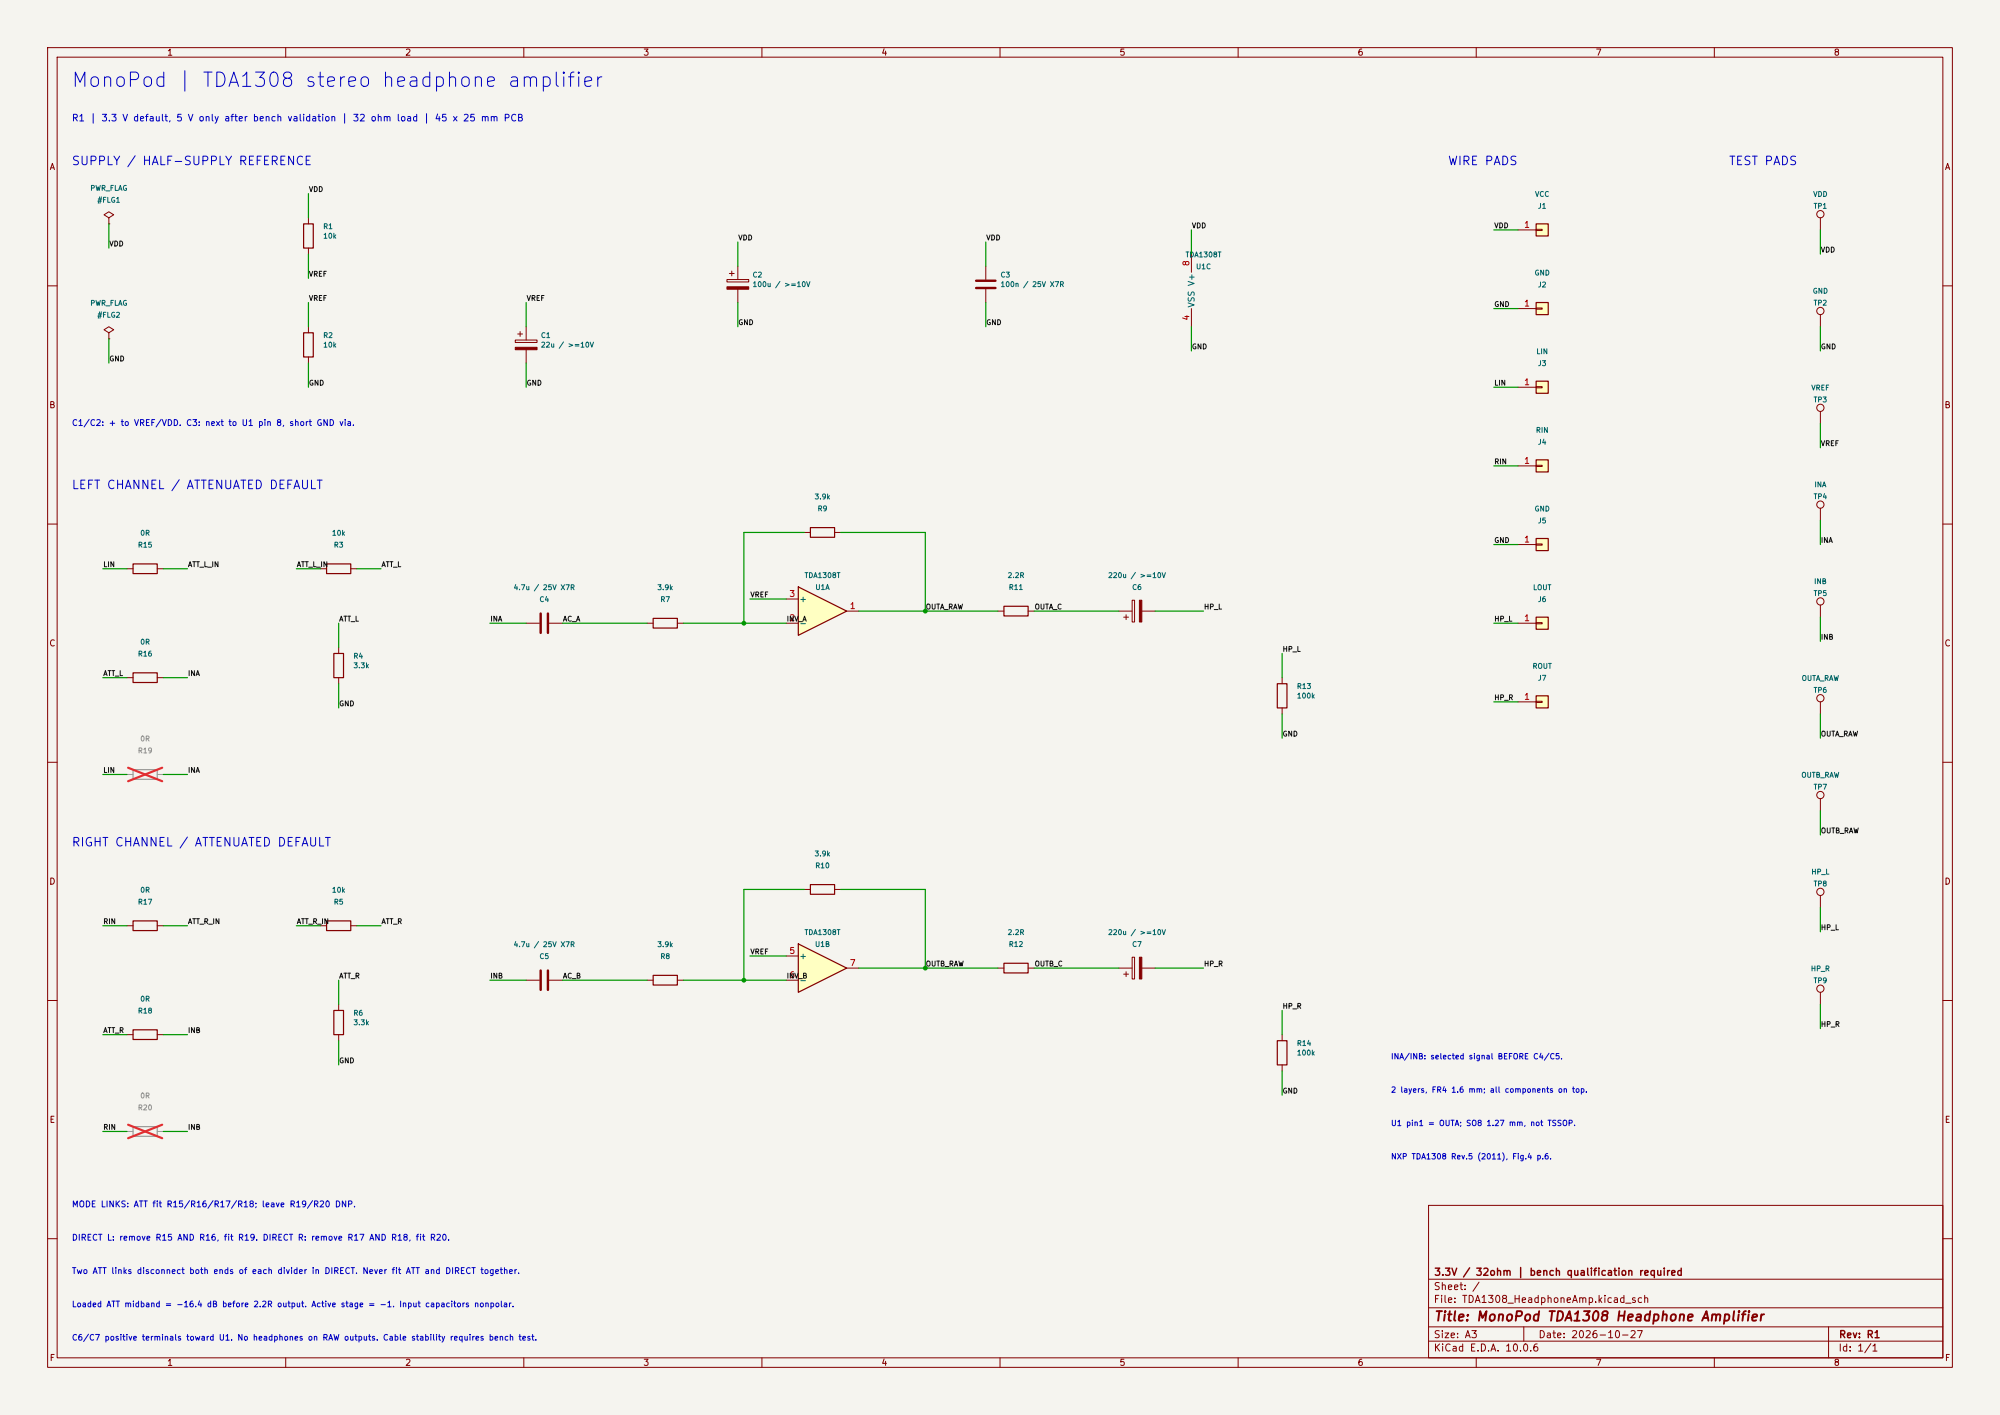
[picture p105: page 1]

INA/INB: selected signal BEFORE C4/C5. NXP TDA1308 Rev.5 (2011), Fig.4 p.6. U1 pin1 = OUTA; SO8 1.27 mm, not TSSOP. MonoPod | TDA1308 stereo headphone amplifier

R1 | 3.3 V default, 5 V only after bench validation | 32 ohm load | 45 x 25 mm PCB

C1/C2: + to VREF/VDD. C3: next to U1 pin 8, short GND via.

LEFT CHANNEL / ATTENUATED DEFAULT

AC_A RIGHT CHANNEL / ATTENUATED DEFAULT

2 layers, FR4 1.6 mm; all components on top.

MODE LINKS: ATT fit R15/R16/R17/R18; leave R19/R20 DNP. DIRECT L: remove R15 AND R16, fit R19. DIRECT R: remove R17 AND R18, fit R20. Two ATT links disconnect both ends of each divider in DIRECT. Never fit ATT and DIRECT together. Loaded ATT midband = -16.4 dB before 2.2R output. Active stage = -1. Input capacitors nonpolar.

3.3V / 32ohm | bench qualification required
Sheet: /
File: TDA1308_HeadphoneAmp.kicad_sch
Title: MonoPod TDA1308 Headphone Amplifier

C6/C7 positive terminals toward U1. No headphones on RAW outputs. Cable stability requires bench test.

Size: A3 | Rev: R1 | F Date: 2026-10-27
KiCad E.D.A. 10.0.6 | Id: 1/1
