IlyaBOT/MonoPod/(list of files, drawings)

Other design files:
Hardware/MonoPod_Enclosure_v04_USB_Flush_Acrylic_2026-11-02/reference/clickwheel/source/pcb_geometry.json
