IlyaBOT/MonoPod/Hardware/TDA1308_HeadphoneAmp/revisions/R1_snapshot/TDA1308_HeadphoneAmp.kicad_pcb

## KiCad design Hardware/TDA1308_HeadphoneAmp/revisions/R1_snapshot/TDA1308_HeadphoneAmp.kicad_pcb (2026-11-14)

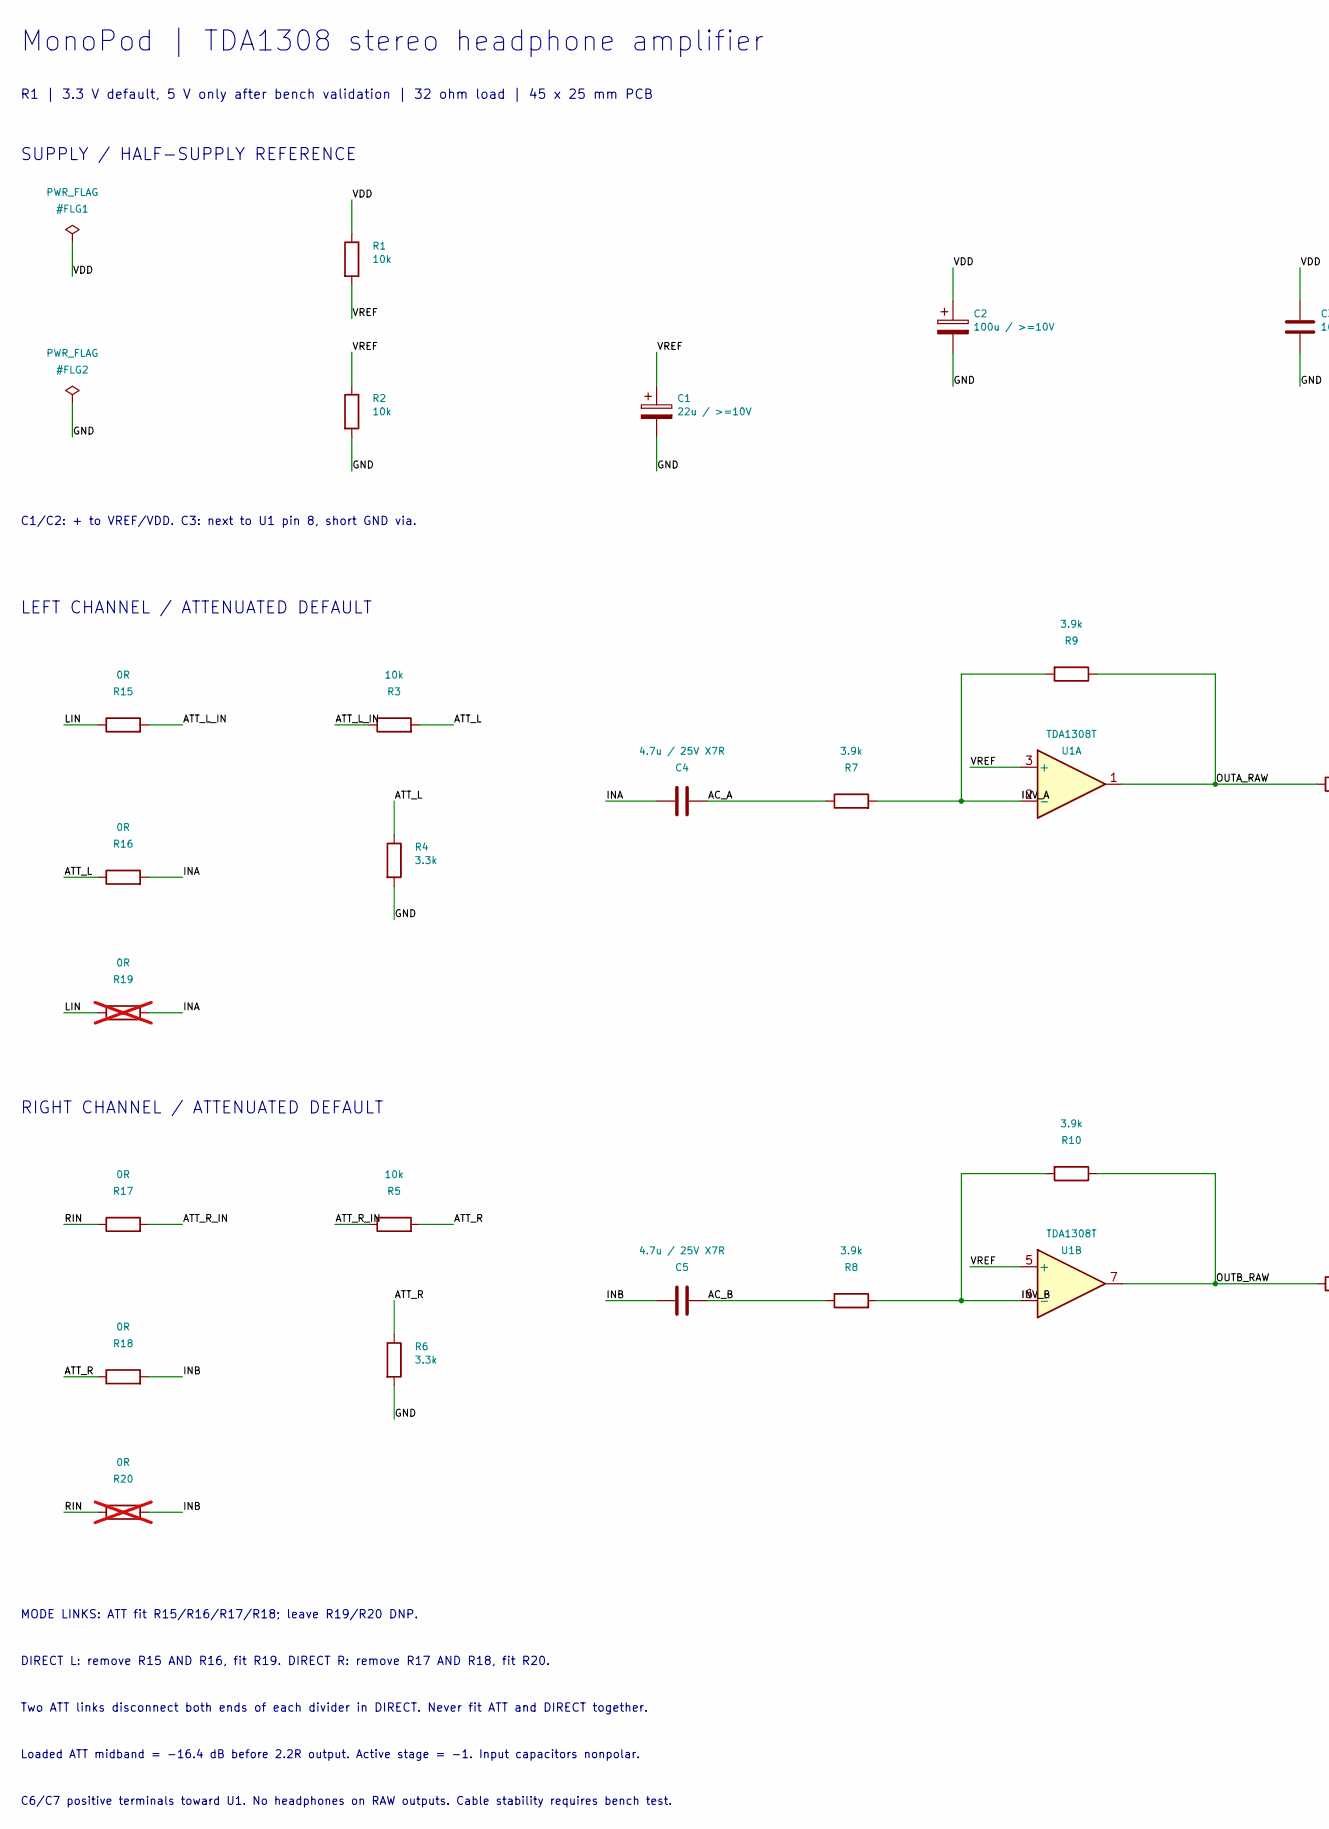
[picture p106: schematic TDA1308_HeadphoneAmp.kicad_sch, MonoPod TDA1308 Headphone Amplifier, part in row 1, column 1]

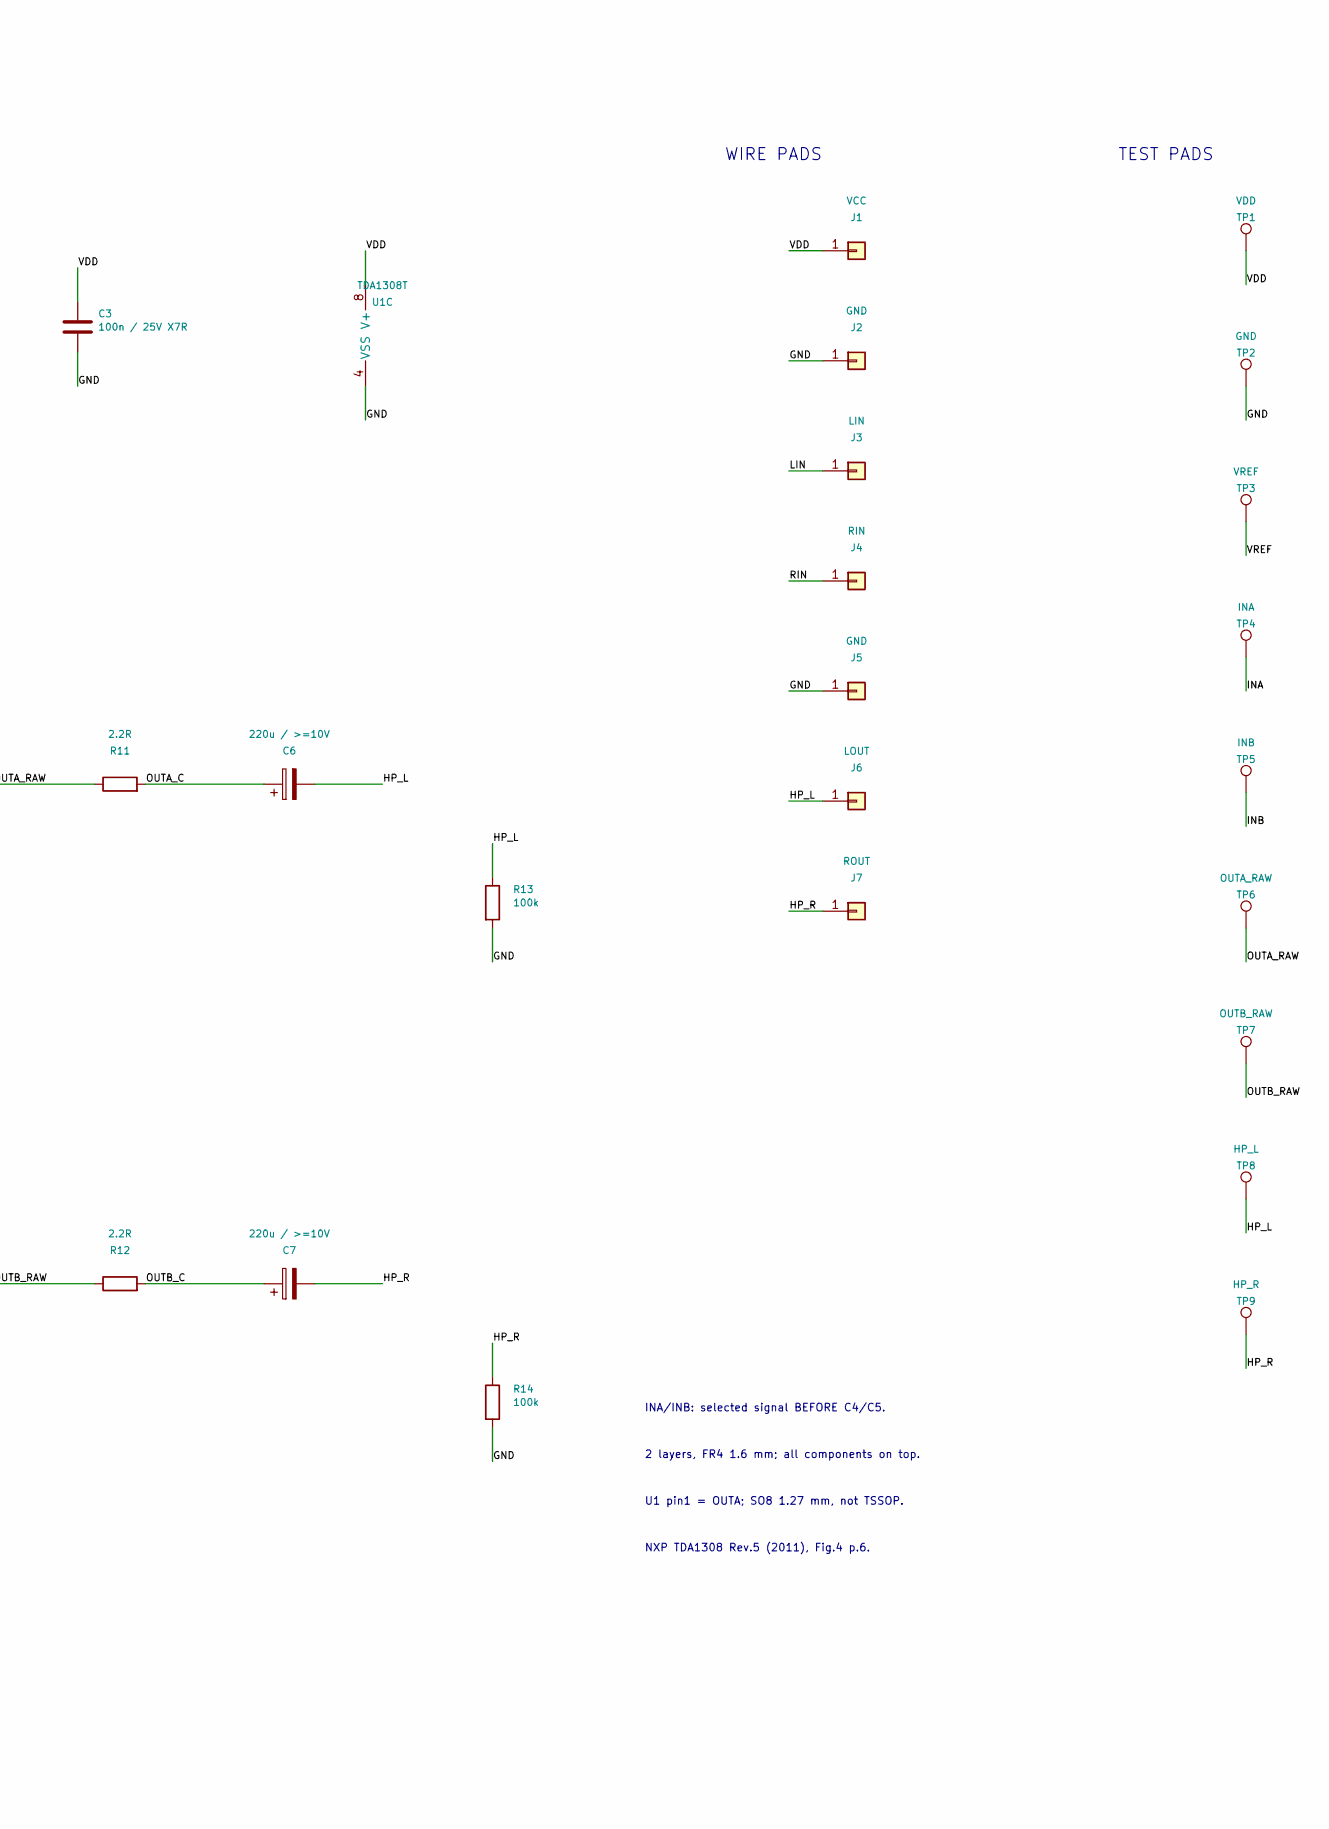
[picture p107: schematic TDA1308_HeadphoneAmp.kicad_sch, MonoPod TDA1308 Headphone Amplifier, part in row 1, column 2]

Parts:
C1: 22u / >=10V; CP_Radial_D5.0mm_P2.00mm
C2: 100u / >=10V; CP_Radial_D6.3mm_P2.50mm
C3: 100n / 25V X7R; C_0805_2012Metric
C4, C5: 4.7u / 25V X7R; C_1206_3216Metric
C6, C7: 220u / >=10V; CP_Radial_D8.0mm_P3.50mm
J1: VCC; SolderWire-0.5sqmm_1x01_D0.9mm_OD2.1mm
J2, J5: GND; SolderWire-0.5sqmm_1x01_D0.9mm_OD2.1mm
J3: LIN; SolderWire-0.5sqmm_1x01_D0.9mm_OD2.1mm
J4: RIN; SolderWire-0.5sqmm_1x01_D0.9mm_OD2.1mm
J6: LOUT; SolderWire-0.5sqmm_1x01_D0.9mm_OD2.1mm
J7: ROUT; SolderWire-0.5sqmm_1x01_D0.9mm_OD2.1mm
R1, R2, R3, R5: 10k; R_0805_2012Metric
R4, R6: 3.3k; R_0805_2012Metric
R7, R8, R9, R10: 3.9k; R_0805_2012Metric
R11, R12: 2.2R; R_0805_2012Metric
R13, R14: 100k; R_0805_2012Metric
R15, R16, R17, R18: 0R; R_0805_2012Metric
R19, R20: 0R; R_0805_2012Metric; not fitted
TP1: VDD; TestPoint_Pad_D1.5mm
TP2: GND; TestPoint_Pad_D1.5mm
TP3: VREF; TestPoint_Pad_D1.5mm
TP4: INA; TestPoint_Pad_D1.5mm
TP5: INB; TestPoint_Pad_D1.5mm
TP6: OUTA_RAW; TestPoint_Pad_D1.5mm
TP7: OUTB_RAW; TestPoint_Pad_D1.5mm
TP8: HP_L; TestPoint_Pad_D1.5mm
TP9: HP_R; TestPoint_Pad_D1.5mm
U1: TDA1308T; SOIC-8_3.9x4.9mm_P1.27mm

Connections:
/AC_A: C4.2, R7.1
/AC_B: C5.2, R8.1
/ATT_L: R3.2, R4.1, R16.1
/ATT_L_IN: R3.1, R15.2
/ATT_R: R5.2, R6.1, R18.1
/ATT_R_IN: R5.1, R17.2
/GND: C1.2, C2.2, C3.2, J2.1, J5.1, R2.2, R4.2, R6.2, R13.2, R14.2, TP2.1, U1.4 (VSS)
/HP_L: C6.2, J6.1, R13.1, TP8.1
/HP_R: C7.2, J7.1, R14.1, TP9.1
/INA: C4.1, R16.2, R19.2, TP4.1
/INB: C5.1, R18.2, R20.2, TP5.1
/INV_A: R7.2, R9.2, U1.2 (-)
/INV_B: R8.2, R10.2, U1.6 (-)
/LIN: J3.1, R15.1, R19.1
/OUTA_C: C6.1, R11.2
/OUTA_RAW: R9.1, R11.1, TP6.1, U1.1
/OUTB_C: C7.1, R12.2
/OUTB_RAW: R10.1, R12.1, TP7.1, U1.7
/RIN: J4.1, R17.1, R20.1
/VDD: C2.1, C3.1, J1.1, R1.1, TP1.1, U1.8 (V+)
/VREF: C1.1, R1.2, R2.1, TP3.1, U1.3 (+), U1.5 (+)

Notes on the sheet:
MonoPod | TDA1308 stereo headphone amplifier
R1 | 3.3 V default, 5 V only after bench validation | 32 ohm load | 45 x 25 mm PCB
SUPPLY / HALF-SUPPLY REFERENCE
C1/C2: + to VREF/VDD. C3: next to U1 pin 8, short GND via.
LEFT CHANNEL / ATTENUATED DEFAULT
RIGHT CHANNEL / ATTENUATED DEFAULT
MODE LINKS: ATT fit R15/R16/R17/R18; leave R19/R20 DNP.
DIRECT L: remove R15 AND R16, fit R19. DIRECT R: remove R17 AND R18, fit R20.
Two ATT links disconnect both ends of each divider in DIRECT. Never fit ATT and DIRECT together.
Loaded ATT midband = -16.4 dB before 2.2R output. Active stage = -1. Input capacitors nonpolar.
C6/C7 positive terminals toward U1. No headphones on RAW outputs. Cable stability requires bench test.
WIRE PADS
TEST PADS
INA/INB: selected signal BEFORE C4/C5.
2 layers, FR4 1.6 mm; all components on top.
U1 pin1 = OUTA; SO8 1.27 mm, not TSSOP.
NXP TDA1308 Rev.5 (2011), Fig.4 p.6.

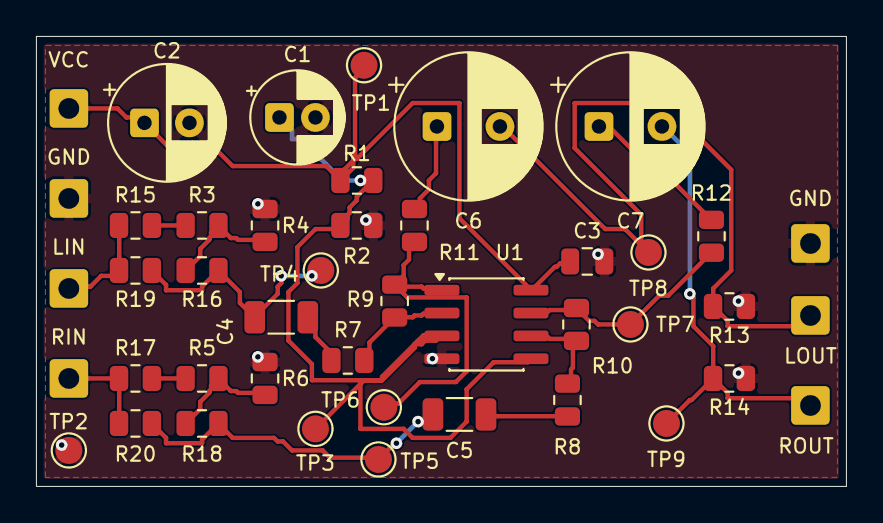
[picture p108: board TDA1308_HeadphoneAmp.kicad_pcb from above]

Board: 2 copper layers, 45.0 x 25.0 mm, 44 parts (0 on the bottom side), 21 nets.
