IlyaBOT/MonoPod/firmware/DIY_iPod_Mono/MonoFont.h

#pragma once
#include <Arduino.h>
#include <pgmspace.h>
// Generated from DejaVu Sans Bold (Bitstream Vera license, see LICENSE-MONOFONT.txt).
// Each glyph uses an independent fixed-height alpha4 raster. The OFF setting
// thresholds this SAME raster, so anti-aliasing OFF/ON does not change layout.
// Source generator: tools/generate_monofont.py
namespace MonoFont {
struct Glyph {uint16_t codepoint;uint8_t advance;uint8_t width;uint32_t offset;};
static const Glyph big[] PROGMEM = {
  {32,5,5,0},
  {33,7,7,40},
  {34,8,8,96},
  {35,13,13,160},
  {36,11,11,264},
  {37,15,15,352},
  {38,13,13,472},
  {39,5,5,576},
  {40,7,7,616},
  {41,7,7,672},
  {42,8,8,728},
  {43,13,13,792},
  {44,6,6,896},
  {45,6,6,944},
  {46,6,6,992},
  {47,6,6,1040},
  {48,11,11,1088},
  {49,11,11,1176},
  {50,11,11,1264},
  {51,11,11,1352},
  {52,11,11,1440},
  {53,11,11,1528},
  {54,11,11,1616},
  {55,11,11,1704},
  {56,11,11,1792},
  {57,11,11,1880},
  {58,6,6,1968},
  {59,6,6,2016},
  {60,13,13,2064},
  {61,13,13,2168},
  {62,13,13,2272},
  {63,9,9,2376},
  {64,15,15,2448},
  {65,12,12,2568},
  {66,11,11,2664},
  {67,11,11,2752},
  {68,12,12,2840},
  {69,10,10,2936},
  {70,10,10,3016},
  {71,12,12,3096},
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
};
static constexpr size_t bigCount=sizeof(big)/sizeof(big[0]);
static const uint8_t bigPixels[] PROGMEM = {
  0x00,0x00,0x00,0x00,0x00,0x00,0x00,0x00,0x00,0x00,0x00,0x00,0x00,0x00,0x00,0x00,0x00,0x00,0x00,0x00,
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
  const uint8_t height=small?12:16;
  if(x>=g.width || y>=height) return 0;
  const size_t index=(size_t)y*g.width+x;
  const uint8_t* table=small?smallPixels:bigPixels;
  uint8_t packed=pgm_read_byte(table+g.offset+(index>>1));
  return (index&1)?(packed&15):(packed>>4);
}
}
