IlyaBOT/MonoPod/firmware/DIY_iPod_Mono/PixelFont.h

#pragma once
// Automatically rasterized open DejaVu Sans Mono glyphs (not Apple fonts).
// Glyph rows: 7 usable pixels (MSB first), 11 pixels high, stride 8.
// Source font: DejaVu Sans Mono, see LICENSE-FONT.txt.
#include <Arduino.h>
namespace PixelFont {
constexpr uint8_t GLYPH_WIDTH=8, GLYPH_HEIGHT=11;
const uint8_t glyphs[] PROGMEM={
  0x00, 0x00, 0x00, 0x00, 0x00, 0x00, 0x00, 0x00, 0x00, 0x00, 0x00, 0x00, 0x60, 0x60, 0x60, 0x60, 0x20, 0x00, 0x60, 0x00, 0x00, 0x00,
  0x00, 0x60, 0x60, 0x60, 0x00, 0x00, 0x00, 0x00, 0x00, 0x00, 0x00, 0x00, 0x50, 0x50, 0xF8, 0x50, 0xF8, 0xA0, 0xA0, 0x00, 0x00, 0x00,
  0x00, 0x00, 0xF0, 0x80, 0xE0, 0x30, 0x30, 0xF0, 0x00, 0x00, 0x00, 0x00, 0xC0, 0x40, 0xD0, 0x60, 0xB0, 0x28, 0x30, 0x00, 0x00, 0x00,
  0x00, 0xE0, 0x80, 0xC0, 0xE8, 0x38, 0x90, 0xF8, 0x00, 0x00, 0x00, 0x00, 0x60, 0x60, 0x60, 0x00, 0x00, 0x00, 0x00, 0x00, 0x00, 0x00,
  0x20, 0x20, 0x40, 0x40, 0x40, 0x40, 0x40, 0x20, 0x20, 0x00, 0x00, 0x40, 0x40, 0x20, 0x20, 0x20, 0x20, 0x20, 0x40, 0x40, 0x00, 0x00,
  0x00, 0x90, 0x60, 0x60, 0x90, 0x00, 0x00, 0x00, 0x00, 0x00, 0x00, 0x00, 0x00, 0x20, 0x20, 0xF8, 0x20, 0x20, 0x00, 0x00, 0x00, 0x00,
  0x00, 0x00, 0x00, 0x00, 0x00, 0x00, 0x00, 0x60, 0x60, 0x40, 0x00, 0x00, 0x00, 0x00, 0x00, 0x00, 0x60, 0x00, 0x00, 0x00, 0x00, 0x00,
  0x00, 0x00, 0x00, 0x00, 0x00, 0x00, 0x00, 0x60, 0x00, 0x00, 0x00, 0x00, 0x10, 0x10, 0x20, 0x20, 0x40, 0x40, 0x80, 0x80, 0x00, 0x00,
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
};
inline int index(uint32_t cp){
  if(cp>=32&&cp<=126)return (int)cp-32;
  if(cp==0x401)return 95;
  if(cp>=0x410&&cp<0x450)return 96+(int)cp-0x410;
  if(cp==0x451)return 160;
  return '?' - 32;
}
}
