IlyaBOT/MonoPod/firmware/DIY_iPod_Mono/Display.h

#pragma once
#include "Config.h"
#include "Types.h"
#include <SPI.h>
#include <Adafruit_GFX.h>
#include <Adafruit_ST7735.h>
using MonoDisplayDriver=Adafruit_ST7735;
class Display {
public:
  Display();
  void begin();
  void palette(uint8_t p);
  bool reloadTheme();
  bool themeLoaded() const;
  void clear();
  void startFrame(); // draw offscreen when PSRAM/RAM is available
  void endFrame(); // one full-screen SPI transfer: no visible erase/flicker
  void header(const String& title,bool held,bool playbackActive,uint8_t wifiBars,bool nowPlaying=false,bool playbackPaused=false);
  void wifiSignal(uint8_t bars); // refresh only the icon region; 0 hides it
  void footer(const String& message=""); // Explicit info only; no generic item counter
  void listRow(uint8_t row,const String& label,bool selected,bool submenu,int scrollPx=0);
  void headerTitleMarquee(const String& label,int scrollPx);
  void nowPlayingTitleMarquee(const String& label,int scrollPx);
  void text(int x,int y,const String& value,uint16_t front,uint16_t back,uint8_t maxChars=0);
  void smallText(int x,int y,const String& value,uint16_t front,uint16_t back,uint8_t maxChars=0);
  void serialText(int x,int y,const String& serial,uint16_t front,uint16_t back); // Compact 6x8px hex serial, never ellipsized.
  void centerText(int y,const String& value,bool small=false,bool inverted=false);
  void fillRect(int x,int y,int w,int h,uint16_t color){surface().fillRect(x+OX,y+OY,w,h,color);}
  void progress(int x,int y,int w,int percent);
  void clock(const String& dt);
  void syncScreen(bool wifi, bool transferring, const String& address="", const String& otaLine="", bool otaUpdating=false);
  void nowPlaying(const String& title,const String& artist,const String& album,bool paused,uint32_t trackNumber,uint32_t trackCount);
  void nowPlayingControls(uint8_t mode,uint8_t progress,uint8_t volume,uint8_t scrub,uint32_t elapsed,uint32_t remaining,bool knownDuration,uint32_t scrubSeconds=UINT32_MAX);
  uint8_t batteryBand() const;
  void batteryIcon();
  void bootLogo();
  bool streamMonoFrame(const uint8_t* packed, uint16_t white=0xffff, uint16_t black=0x0000);
  bool streamGray2Frame(const uint8_t* packed,const uint16_t colors[4]);
  bool streamGray6Frame(const uint8_t* packed); // packed 6bpp, four pixels per three bytes
  bool streamRgb565Frame(const uint8_t* packed); // 16bpp little endian raw RGB565
  uint16_t themed(uint8_t index,uint16_t fallback)const;
  uint16_t background()const{return bg;}
  uint16_t foreground()const{return fg;}
  uint16_t selectedBackground()const{return hi;}
  uint16_t muted()const{return low;}
  int textWidth(const String& s,bool small=false)const;
  String fittedTitle(const String& title,int maxWidth,bool small=false)const;
  static constexpr uint8_t ROW_COUNT=5;
private:
  MonoDisplayDriver tft;
  GFXcanvas16* buffer=nullptr;
  bool inFrame=false;
  Adafruit_GFX& surface(){return inFrame && buffer?static_cast<Adafruit_GFX&>(*buffer):static_cast<Adafruit_GFX&>(tft);}
  static constexpr int OX=0, OY=0;
  uint16_t bg=0xCE59,fg=0x2104,hi=0x2945,low=0x8C71;
  void drawGlyph(int x,int y,uint32_t cp,uint16_t front,uint16_t back,bool small,int clipLeft=0,int clipRight=160);
  void windowText(int left,int y,int width,const String& text,bool small,int offset,uint16_t front,uint16_t back);
  void drawString(int x,int y,const String& s,uint16_t front,uint16_t back,bool small,uint8_t maxChars,int maxX=160);
};
extern Display display;
