IlyaBOT/MonoPod/firmware/DIY_iPod_Mono/BootLogoBitmap.h

#pragma once
#include <Arduino.h>
// Classic 1-bit boot silhouette; centered 52x52 square pixels, no aspect stretch.
// Cropped one row at top and bottom from the original 52x54 raster.
static const uint8_t appleBootBitmap[] PROGMEM={
  0x00,0x00,0x00,0x00,0xfc,0x00,0x00,0x00,0x00,0x00,0x03,0xfc,0x00,0x00,
  0x00,0x00,0x00,0x07,0xf8,0x00,0x00,0x00,0x00,0x00,0x0f,0xf8,0x00,0x00,
  0x00,0x00,0x00,0x1f,0xf0,0x00,0x00,0x00,0x00,0x00,0x1f,0xf0,0x00,0x00,
  0x00,0x00,0x00,0x3f,0xe0,0x00,0x00,0x00,0x00,0x00,0x3f,0xc0,0x00,0x00,
  0x00,0x00,0x00,0x3f,0x80,0x00,0x00,0x00,0x00,0x00,0x3f,0x00,0x00,0x00,
  0x00,0x00,0x00,0x7e,0x00,0x00,0x00,0x00,0x1f,0xf0,0x20,0x7f,0xe0,0x00,
  0x00,0xff,0xff,0x07,0xff,0xfc,0x00,0x01,0xff,0xff,0xff,0xff,0xfe,0x00,
  0x07,0xff,0xff,0xff,0xff,0xff,0x00,0x0f,0xff,0xff,0xff,0xff,0xff,0xc0,
  0x1f,0xff,0xff,0xff,0xff,0xff,0x80,0x1f,0xff,0xff,0xff,0xff,0xff,0x00,
  0x3f,0xff,0xff,0xff,0xff,0xfe,0x00,0x3f,0xff,0xff,0xff,0xff,0xfc,0x00,
  0x7f,0xff,0xff,0xff,0xff,0xf8,0x00,0x7f,0xff,0xff,0xff,0xff,0xf8,0x00,
  0x7f,0xff,0xff,0xff,0xff,0xf0,0x00,0xff,0xff,0xff,0xff,0xff,0xf0,0x00,
  0xff,0xff,0xff,0xff,0xff,0xf0,0x00,0xff,0xff,0xff,0xff,0xff,0xf0,0x00,
  0xff,0xff,0xff,0xff,0xff,0xe0,0x00,0xff,0xff,0xff,0xff,0xff,0xf0,0x00,
  0xff,0xff,0xff,0xff,0xff,0xf0,0x00,0xff,0xff,0xff,0xff,0xff,0xf0,0x00,
  0xff,0xff,0xff,0xff,0xff,0xf0,0x00,0xff,0xff,0xff,0xff,0xff,0xf8,0x00,
  0xff,0xff,0xff,0xff,0xff,0xf8,0x00,0x7f,0xff,0xff,0xff,0xff,0xfc,0x00,
  0x7f,0xff,0xff,0xff,0xff,0xfc,0x00,0x7f,0xff,0xff,0xff,0xff,0xfe,0x00,
  0x3f,0xff,0xff,0xff,0xff,0xff,0x80,0x3f,0xff,0xff,0xff,0xff,0xff,0xc0,
  0x3f,0xff,0xff,0xff,0xff,0xff,0xe0,0x1f,0xff,0xff,0xff,0xff,0xff,0xe0,
  0x1f,0xff,0xff,0xff,0xff,0xff,0xe0,0x0f,0xff,0xff,0xff,0xff,0xff,0xc0,
  0x0f,0xff,0xff,0xff,0xff,0xff,0xc0,0x07,0xff,0xff,0xff,0xff,0xff,0x80,
  0x03,0xff,0xff,0xff,0xff,0xff,0x80,0x03,0xff,0xff,0xff,0xff,0xff,0x00,
  0x01,0xff,0xff,0xff,0xff,0xfe,0x00,0x00,0xff,0xff,0xff,0xff,0xfc,0x00,
  0x00,0x7f,0xff,0xff,0xff,0xf8,0x00,0x00,0x3f,0xff,0xff,0xff,0xf0,0x00,
  0x00,0x1f,0xff,0xff,0xff,0xe0,0x00,0x00,0x0f,0xfc,0x00,0xff,0xc0,0x00,
 };
static constexpr uint8_t appleBootW=52,appleBootH=52;
