IlyaBOT/MonoPod/(commit log)

2026-11-14 ESP32-S3 support, USB CDC sync, BT/AVRCP overhaul, PWM backlight, UI fixes & SD I/O optimizations
    [BOM.csv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]
2026-11-14 Add runtime UART debug console, virtual input control, HW input override & diagnostics
    [BOM.csv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]
2026-11-14 Mute I2S/piezo clicker, improve SPI SD init/retry, fix battery ADC attenuation & UART diagnostics
    [AudioEngine.cpp, AudioEngine.h, Battery.cpp, ClickMixOutput.cpp, ClickMixOutput.h, Config.h, DIY_iPod_Mono.ino, DevConsole.cpp]
2026-11-14 WiFi STA auto-reconnect, RSSI status icon, UART clicker fixes & ADC/SD diagnostics
    [Config.h, DIY_iPod_Mono.ino, DevConsole.cpp, DevConsoleProtocol.h, Display.cpp, Display.h, UI.cpp, UI.h]
2026-11-14 WiFi compile hotfix, ADC/SD cleanup, configurable SPI clock & legacy debug removal
2026-11-14 iPod 4G UI overhaul, FAT32 formatting, PCM clicker, framebuffer rendering, volume/seek controls & Bad Apple Video format (.BAV)
2026-11-14 Status bar alignment fix, rebuild stock font glyphs & enable 4-bit AA rendering
    [DIY_iPod_Mono.ino, Display.cpp, MonoFont.h, UI.cpp]
2026-11-14 fix: WiFi Sync STA persistence, LAN HTTP server, AP fallback & reconnect handling
    [DIY_iPod_Mono.ino, Display.cpp, Display.h, UI.cpp, WiFiNetworks.cpp, WiFiSync.cpp, WiFiSync.h]
2026-11-14 MonoPod Desktop integration, MPOD1 v4, unified USB/WiFi FS API, atomic I/O recovery, MPT2 themes & MP3 stack overflow fix
    [partitions.csv]
2026-11-14 fix: ID3v2 UTF-16 parsing, skip oversized APIC frames, extend tag scan to 32MB & optimize heap usage
    [Arduino.h, DIY_iPod_Mono.ino, Display.cpp, Id3Parser.h, Library.cpp, SD.h, SyncFiles.cpp, UI.cpp]
2026-11-14 feat: BAV3 RGB565/GRAY6 video, MP3 A/V playback, clock sync, SPI tuning, USB diagnostics & UI cleanup
    [partitions.csv]
2026-11-14 feat: background playback, MPOD1 USB/WiFi CLI, GPIO pullup input, dynamic Now Playing, BAV sync & UI fixes
    [Config.h, DIY_iPod_Mono.ino, DevConsole.cpp, Display.cpp, Display.h, Input.cpp, Library.cpp, SyncFiles.cpp]
2026-11-14 feat: calibrate battery ADC, add charging hysteresis, lightning status icon & UART battery diagnostics
2026-11-14 fix: ESP32-S3 touch baseline calibration, auto-recalibration, ADC button ladder & touch sensitivity; MonoPod Desktop upload and some hardware update
    [PARAMETERS.csv, Probnik.stl, Ramka.stl, acrylic_carrier_subassembly.step, acrylic_screen_lens.step, acrylic_screen_lens_1to1.dxf, acrylic_seat_coupon.step, acrylic_seat_coupon.stl]
2026-11-14 fix: Touch Wheel swipe tracking, sensitivity tuning, ADC button calibration & 20k pullup support
    [Config.h, DIY_iPod_Mono.ino, Input.cpp, Input.h, test_button_20k.py, test_touch_debug.py]
2026-11-14 feat: WiFi OTA v1, smooth touch wheel detents, adaptive scroll acceleration, clicker fixes, volume curve & seek overhaul
    [monopod_s3_n16r8_ota.csv]
2026-11-14 feat: FLAC streaming, sample-accurate seek, 2MB PSRAM ring buffer, dual-core audio task & I2S DMA tuning
2026-11-14 fix: adaptive GPIO9 ADC button thresholds, VCC droop compensation & input voltage tracking
    [ButtonAdcCompensation.h, Config.h, DIY_iPod_Mono.ino, Input.cpp, Input.h, SyncFiles.cpp, UI.cpp, WiFiOta.cpp]
2026-11-14 fix: zero-copy FLAC picture skipping, virtual metadata padding, seek preservation & decoder crash mitigation
    [partitions.csv]
2026-11-14 feat: PowerGuard undervoltage monitoring, low-battery deep sleep, HOLD wake sequence & OTA voltage interlock
    [partitions.csv]
2026-11-14 perf: boost TFT SPI to 20MHz, SD to 16MHz, add adaptive SPI clock fallback & SD readback validation
2026-11-14 perf: optimize WiFi Sync throughput, buffered SD writes, LUT CRC32, disable WiFi power save & fix WebServer const
    [BufferedSdWrite.h, DIY_iPod_Mono.ino, FastCrc32.h, MonoPodDB.h, SyncFiles.cpp, UI.cpp, WiFiOta.cpp, WiFiSync.cpp]
